Kalana304/CEM_Design_Files/SolidWorks/LED light/Number 8 screw/screw.PNG

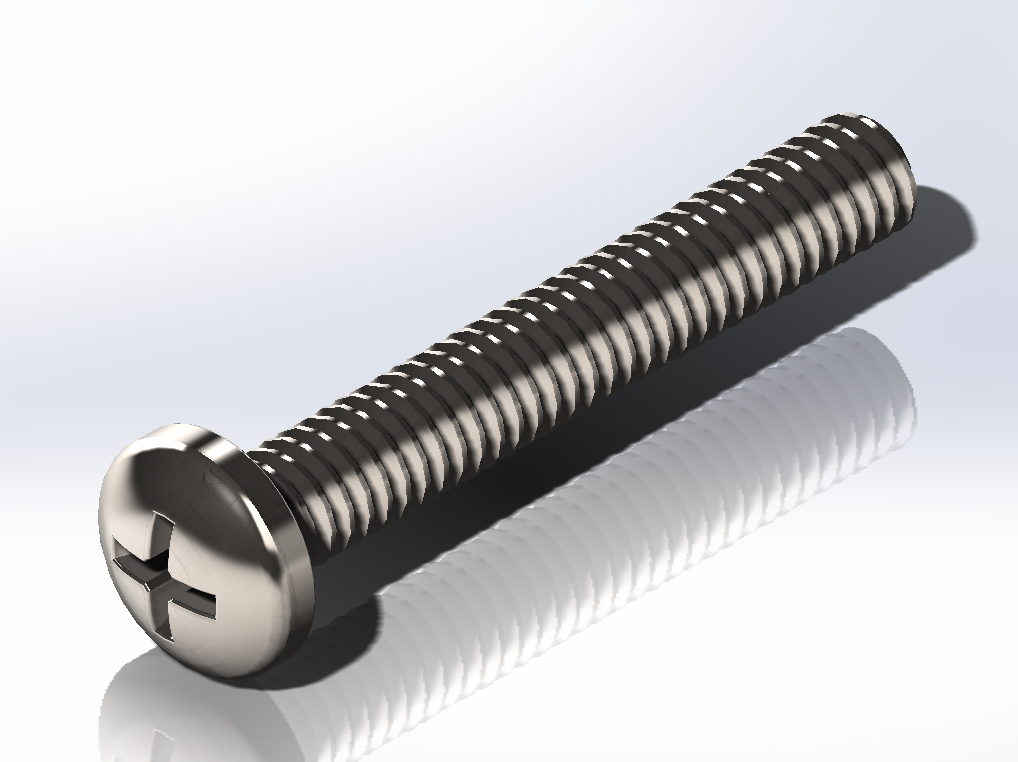
SolidWorks/LED light/Number 8 screw/screw.PNG
