Kalana304/CEM_Design_Files/SolidWorks/LED light/arduino-buzzer-1.snapshot.2/Screenshot (179).png

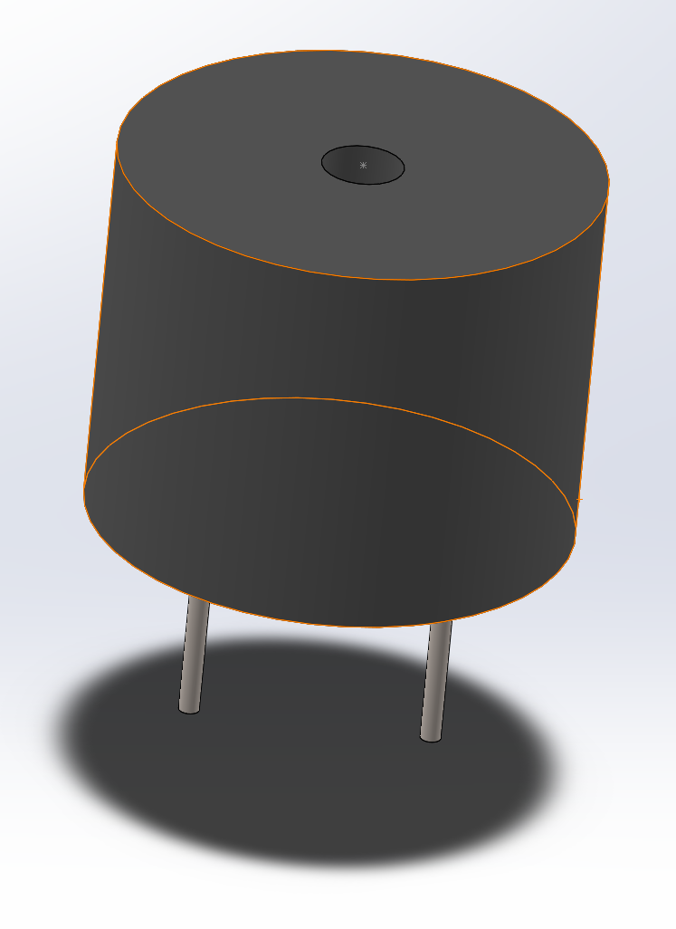
SolidWorks/LED light/arduino-buzzer-1.snapshot.2/Screenshot (179).png
