Kalana304/CEM_Design_Files/Reports/Enclosure.docx

Group 1

Controlled Environment Monitors

Manufacturing Document

# Contents

# Display Unit Manufacture

## Enclosure

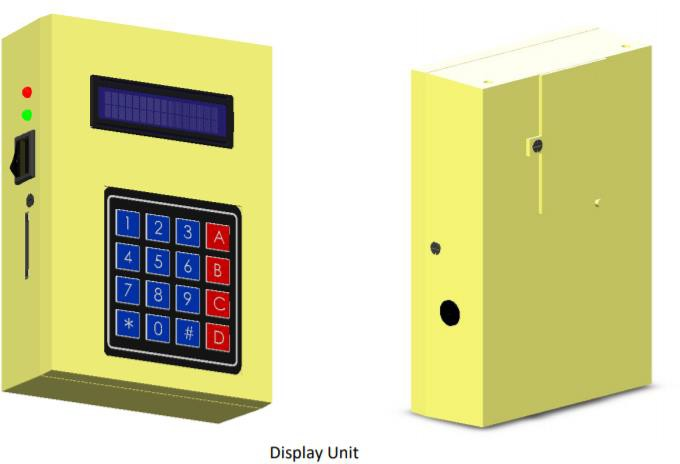
[picture p13: figure]
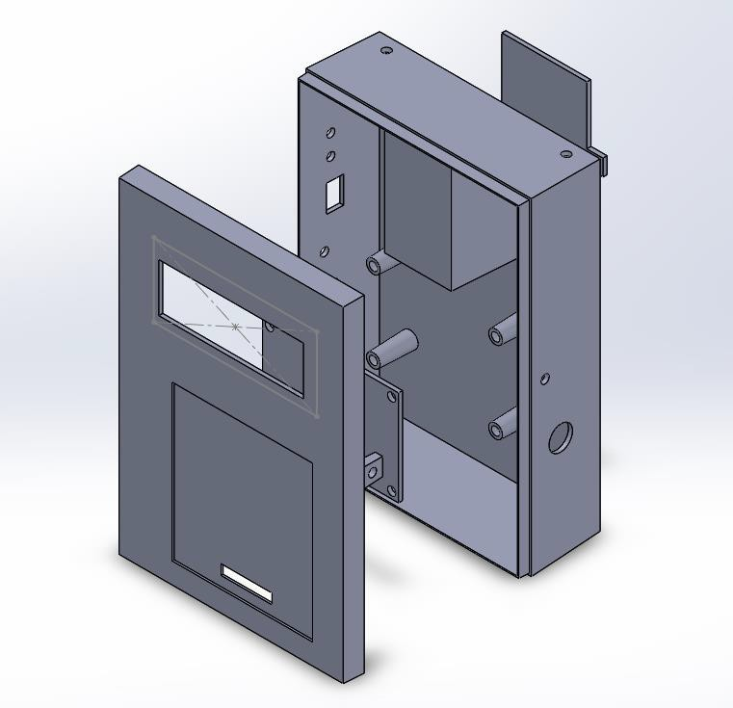
[picture p14: figure]

## Components

The display unit enclosure consists of 3 components that are manufactured by injection molding. All units are to be molded using hard plastic.

1. Top Cover
2. Bottom Cover
3. Battery Cover

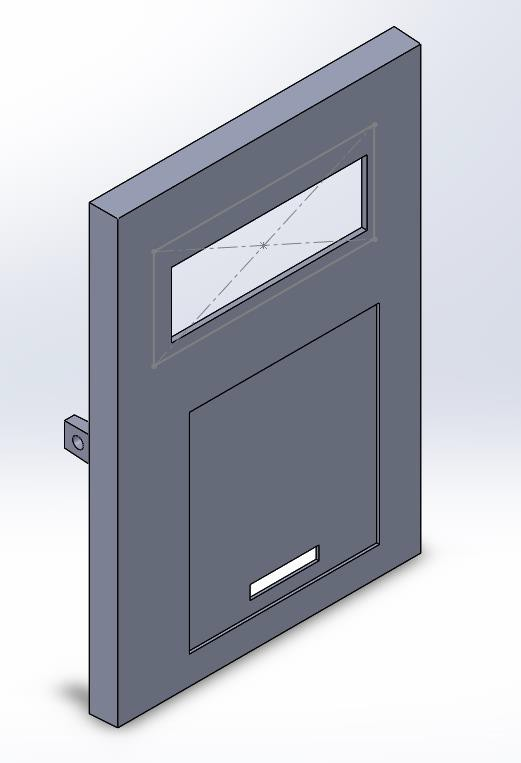
[picture p15: figure]

## Top Cover

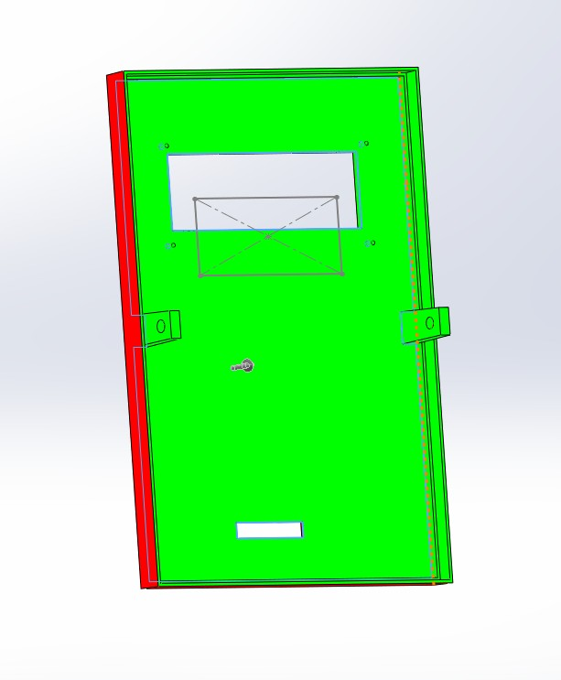
[picture p16: figure]

Draft Analysis

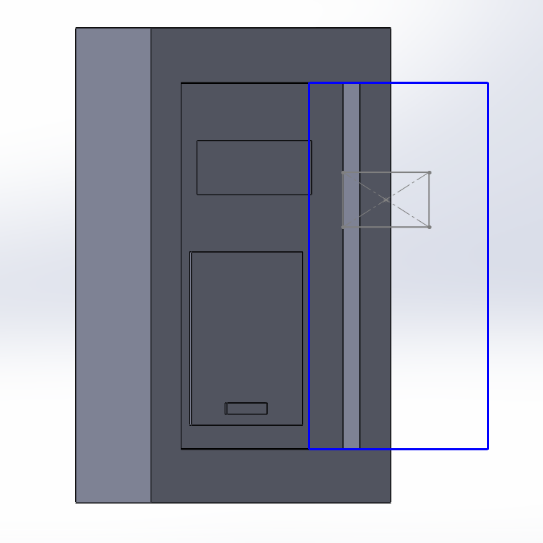
[picture p17: figure]
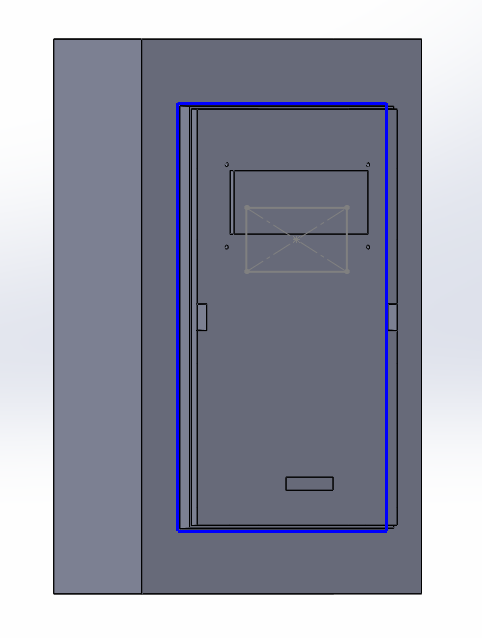
[picture p18: figure]

Mold Components

Cavity Core

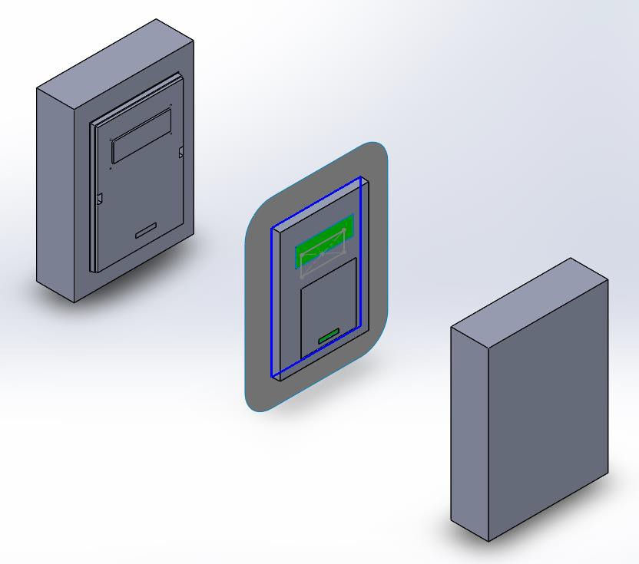
[picture p19: figure]

Exploded view of mold

## Bottom Cover

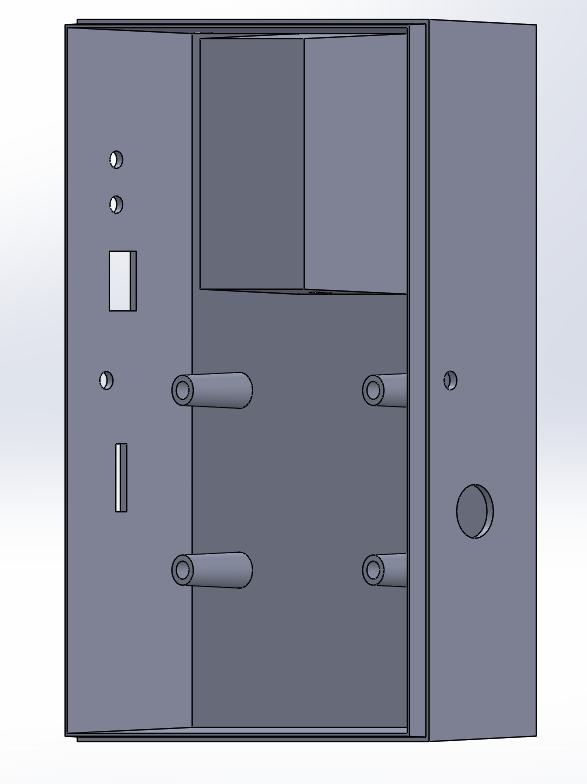
[picture p20: figure]

Draft Analysis

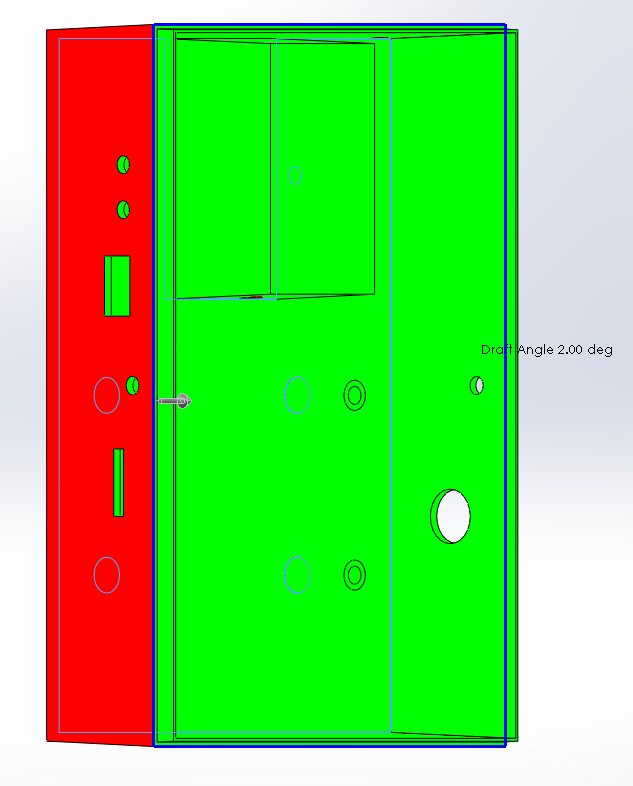
[picture p21: figure]
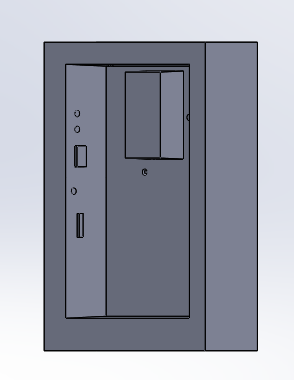
[picture p22: figure]
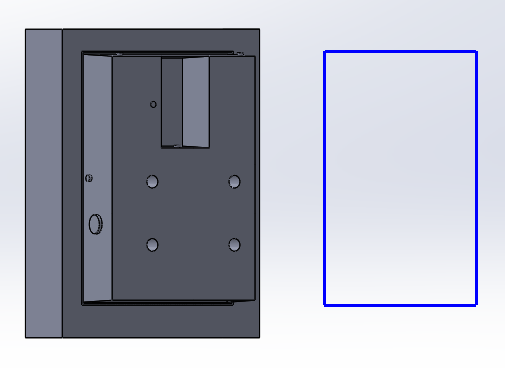
[picture p23: figure]

Mold Components

Core Cavity

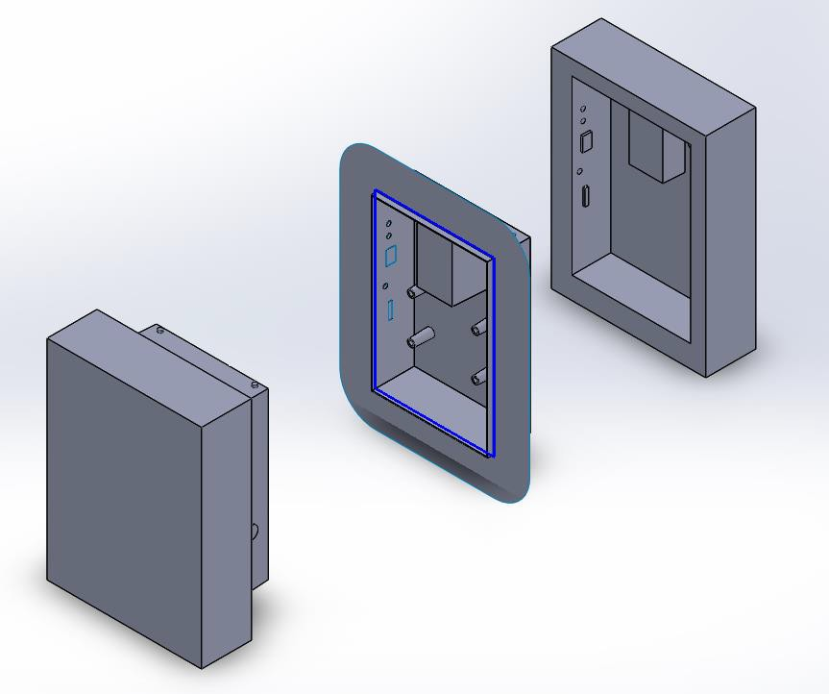
[picture p24: figure]

Exploded view of Mold

## Battery Cover

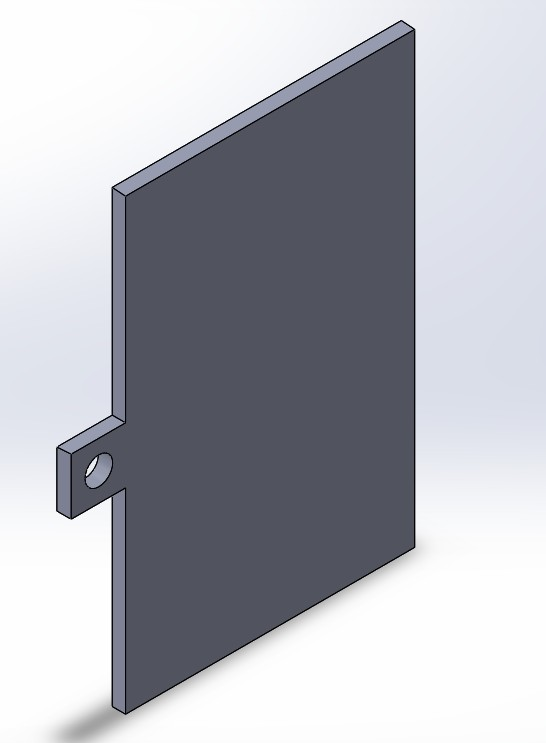
[picture p25: figure]

Draft Analysis

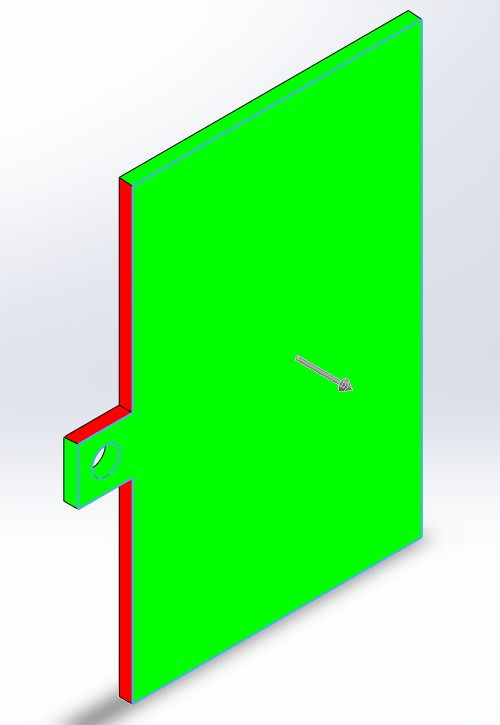
[picture p26: figure]

Mold Components

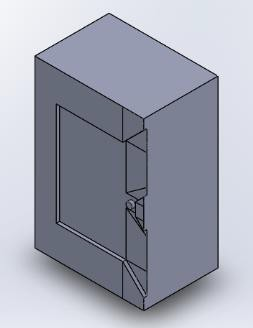
[picture p27: figure]
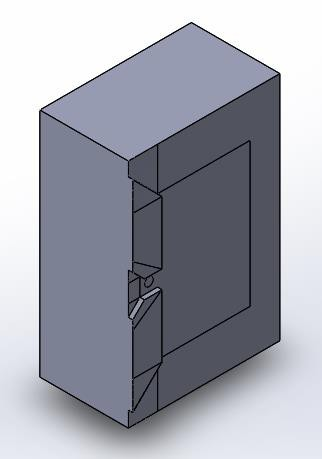
[picture p28: figure]

Core Cavity

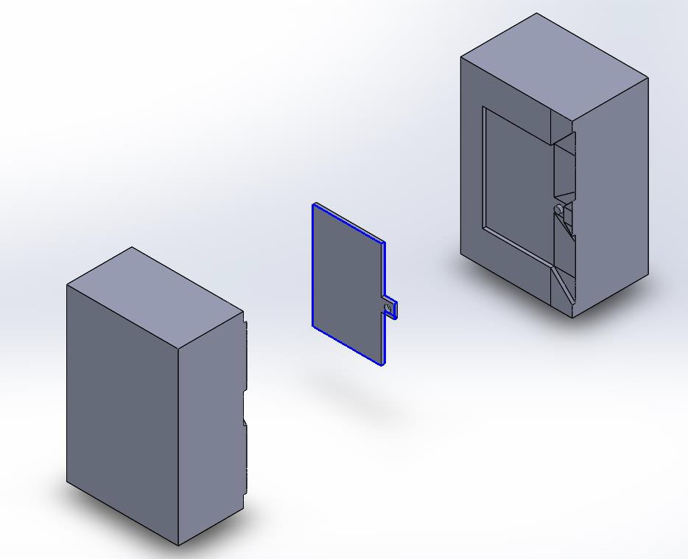
[picture p29: figure]

Exploded view of Mold

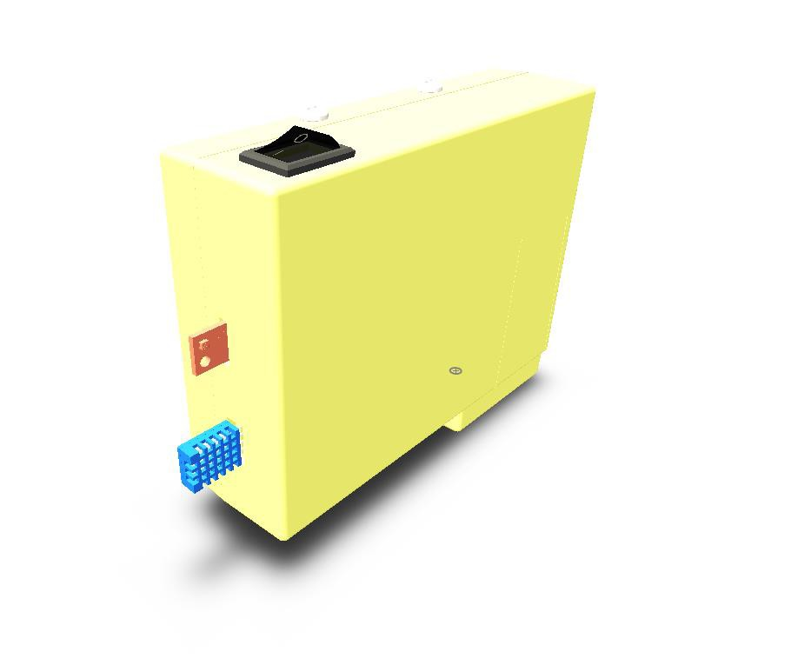
[picture p30: figure]
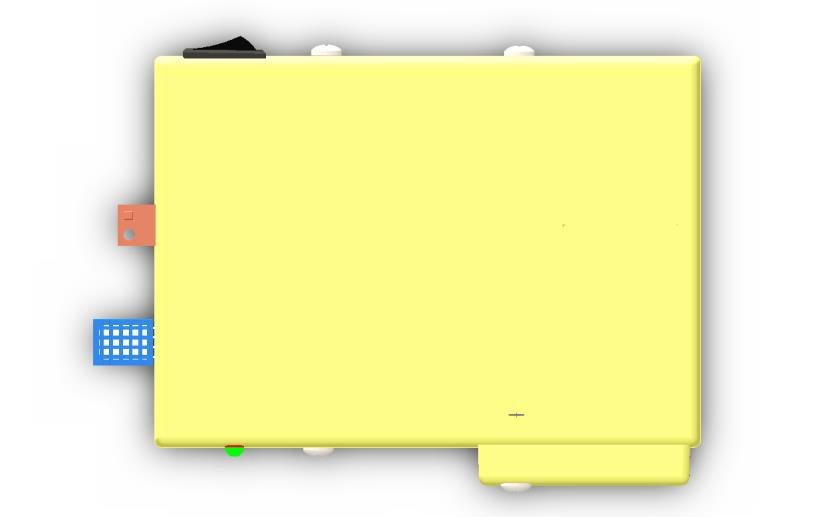
[picture p31: figure]

# Sensor Unit Manufacture

Sensor Unit

## Enclosure

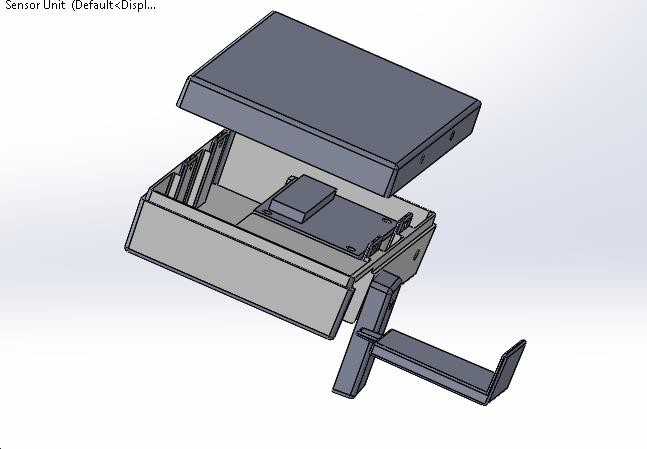
[picture p32: figure]

### Components

The Sensor Unit Enclosure consists of 4 components that are to be manufactured by injection molding. All units are to be molded using hard plastic

Components to be molded are:

  1. Top Cover
  2. Bottom Cover
  3. Battery Cover
  4. Battery Lock

### Top Cover

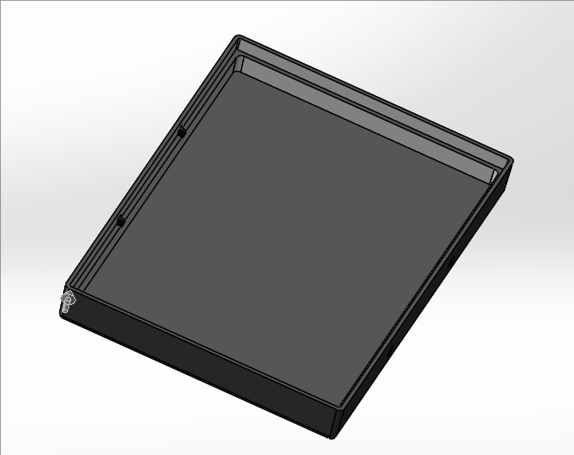
[picture p33: figure]

Draft Analysis

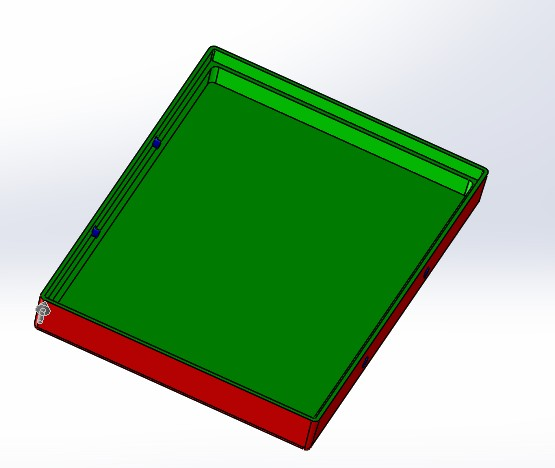
[picture p34: figure]

Mold Components

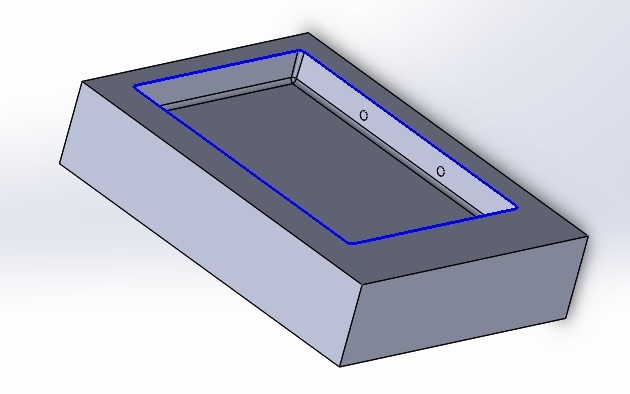
[picture p35: figure]
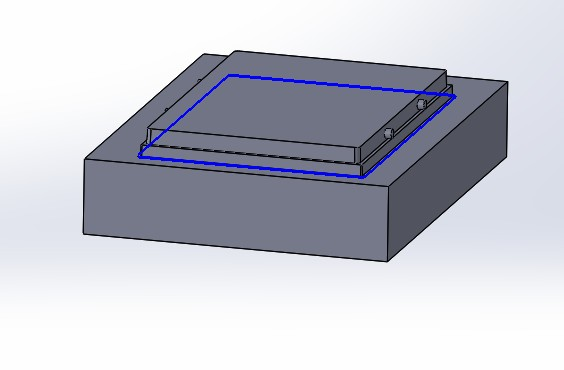
[picture p36: figure]
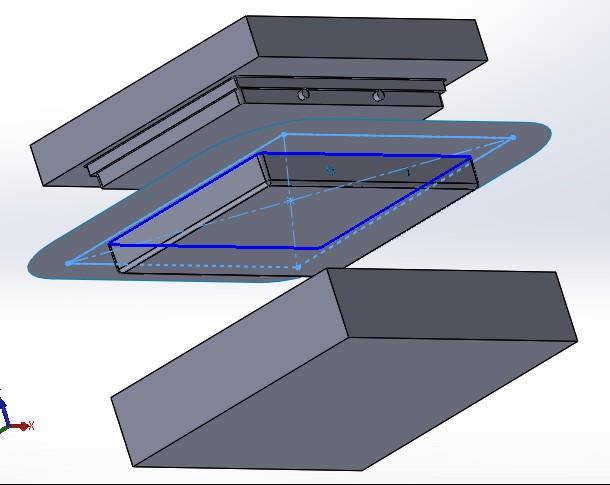
[picture p37: figure]

Cavity

Core

Exploded View of Mold

### Bottom Cover

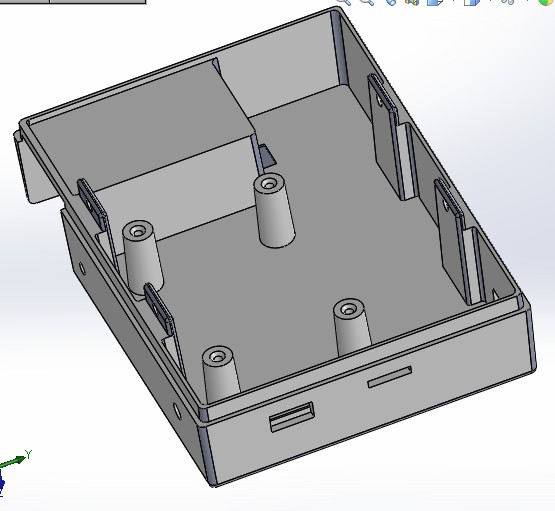
[picture p38: figure]

Draft Analysis

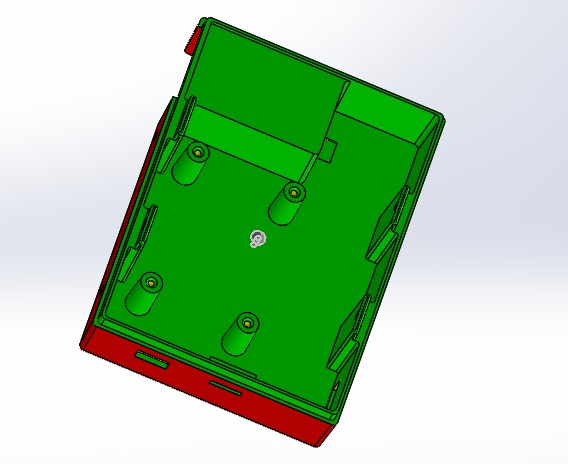
[picture p39: figure]
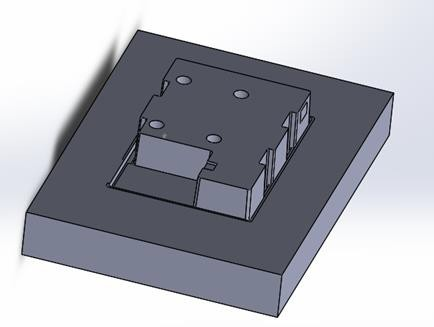
[picture p40: figure]

Mold Components

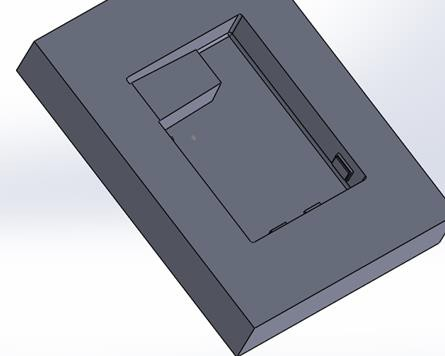
[picture p41: figure]
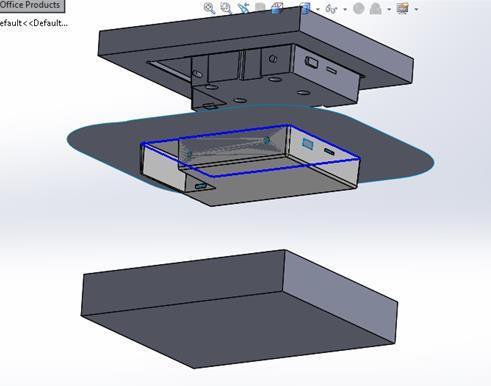
[picture p42: figure]

Cavity

Core

Exploded View of Mold

### Battery Cover

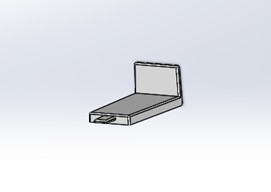
[picture p43: figure]

Draft Analysis

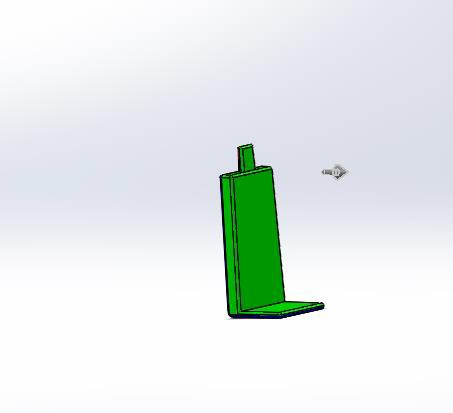
[picture p44: figure]

Mold Components

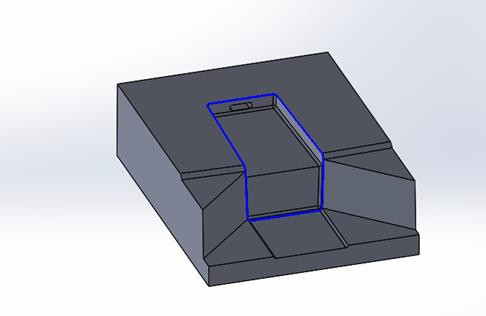
[picture p45: figure]
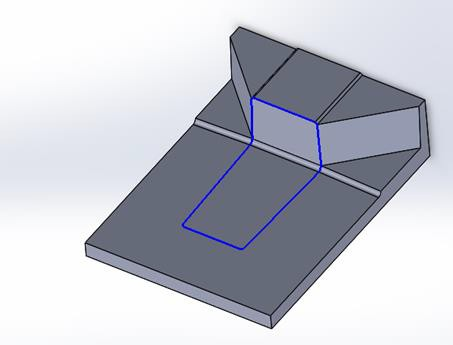
[picture p46: figure]
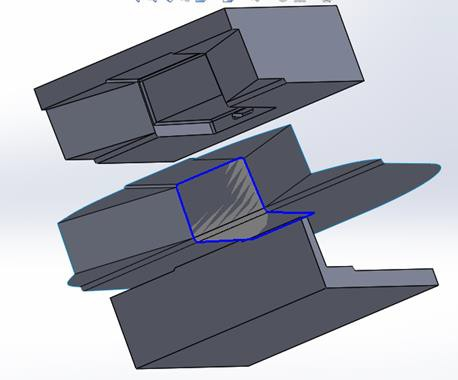
[picture p47: figure]

Cavity

Core

Exploded View of Mold

### Battery Lock

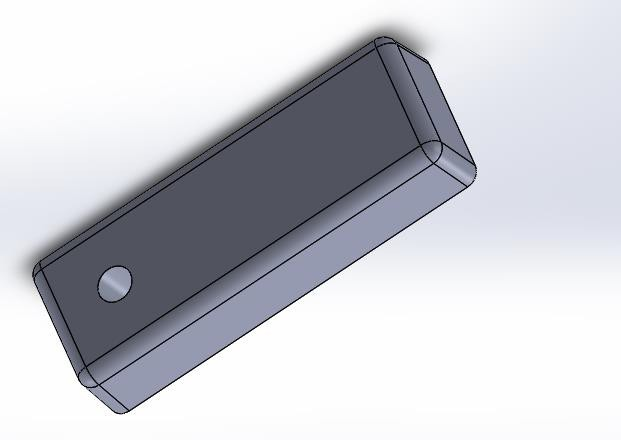
[picture p48: figure]

Draft Analysis

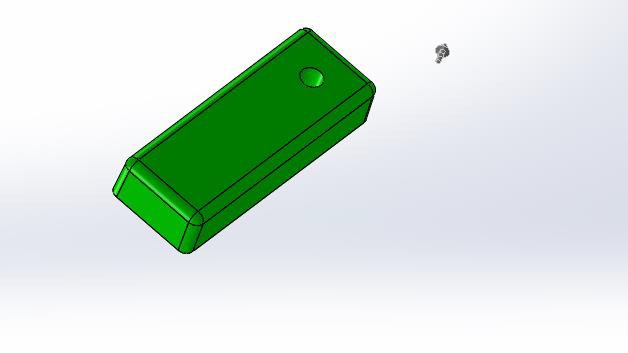
[picture p49: figure]
