Kalana304/CEM_Design_Files/SolidWorks/SolidWorks Design Report.pdf

# CEM SOLIDWORKS DESIGNS

### GROUP 1

## MAY 24, 2019

160005C | Abeywardena K.G.
160050H | Bahavan T.T.N.
160145E | Ekanayake R.P.
160190K | Gunawardena M.B.M.
160276F | Kariyawasam U.G.S.D.
160285G | Karunasena G.K.S.R.
160480B | Perera W.A.H.D.
160616B | Sumanthiran S. K.
160637N | Tribuwan T.W.H.
160648A | Uyanwatte A.M.B

## 1. Sensor Module

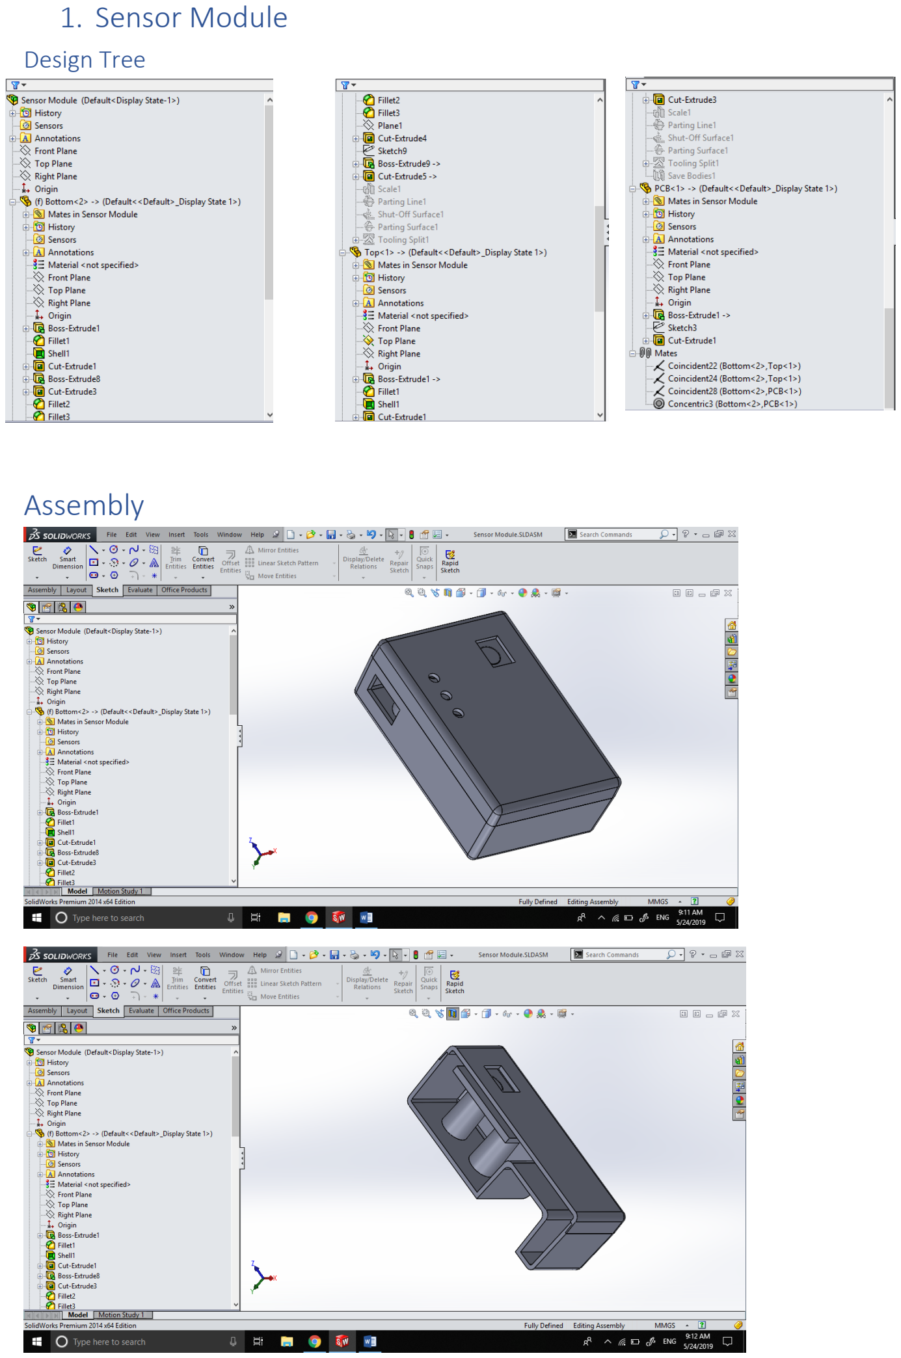
[picture p161: page 2]

Design Tree

## Assembly

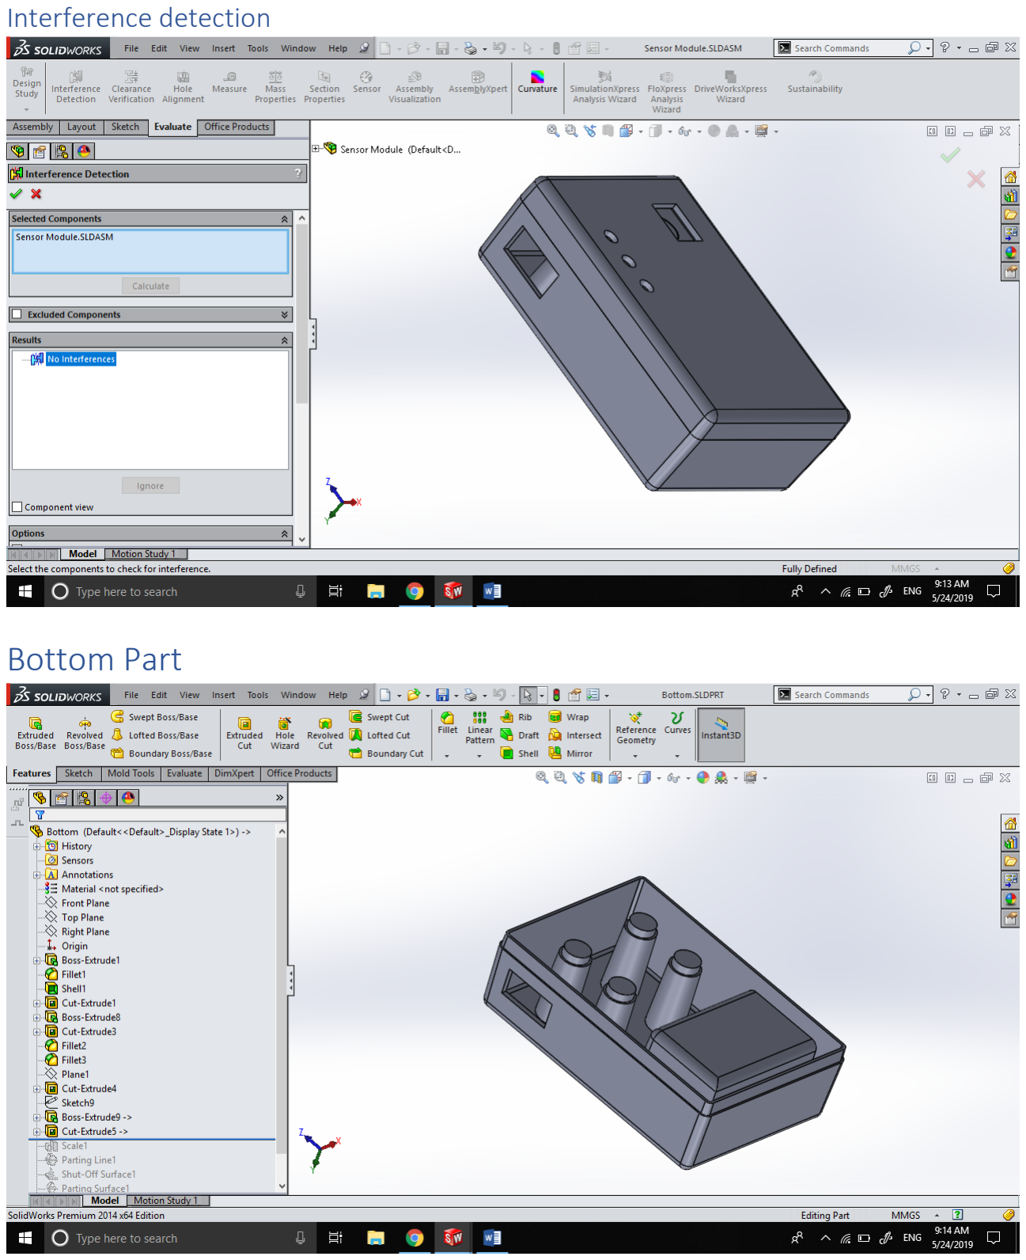
[picture p162: page 3]

Interference detection

## Bottom Part

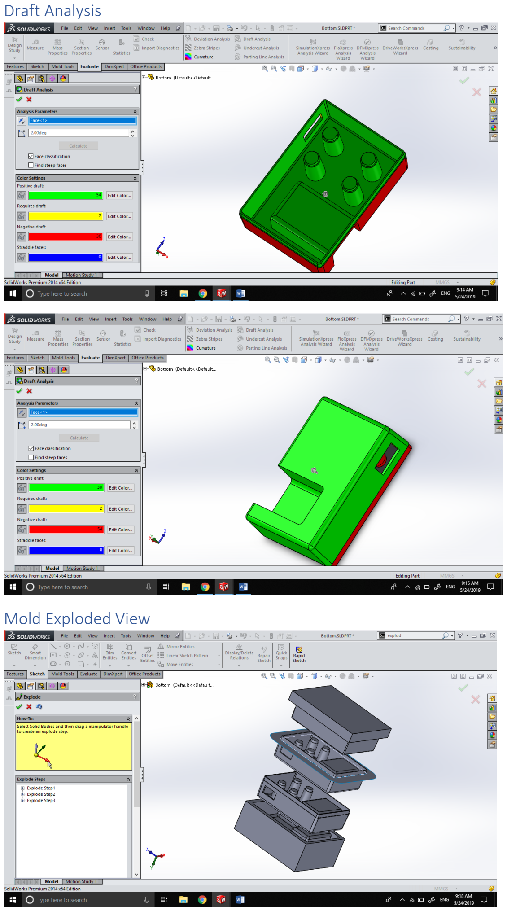
[picture p163: page 4]

Draft Analysis

Mold Exploded View

## Top Part

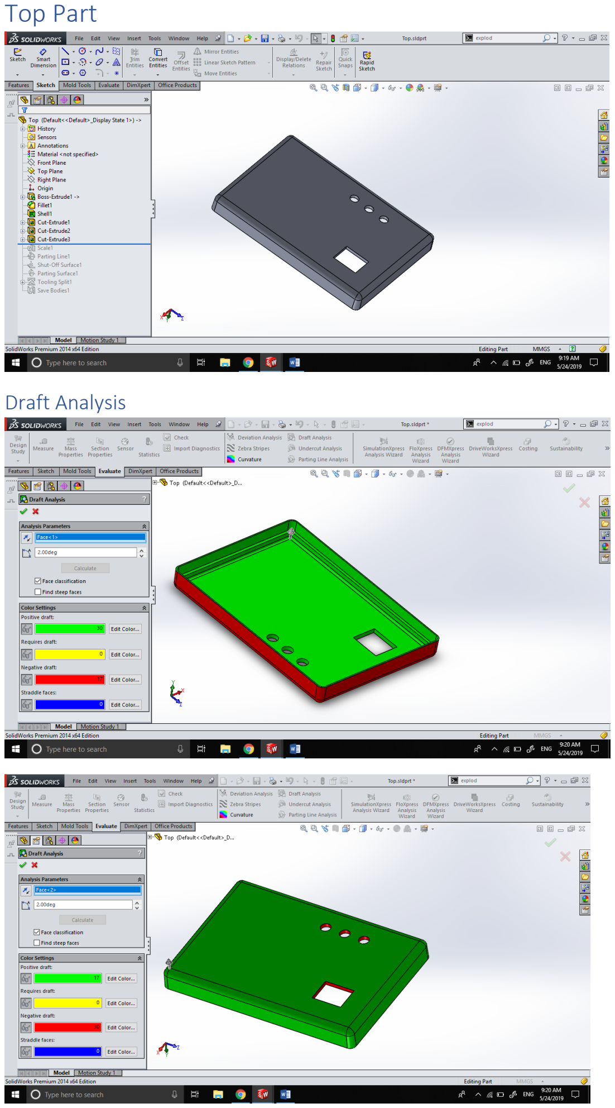
[picture p164: page 5]

Draft Analysis

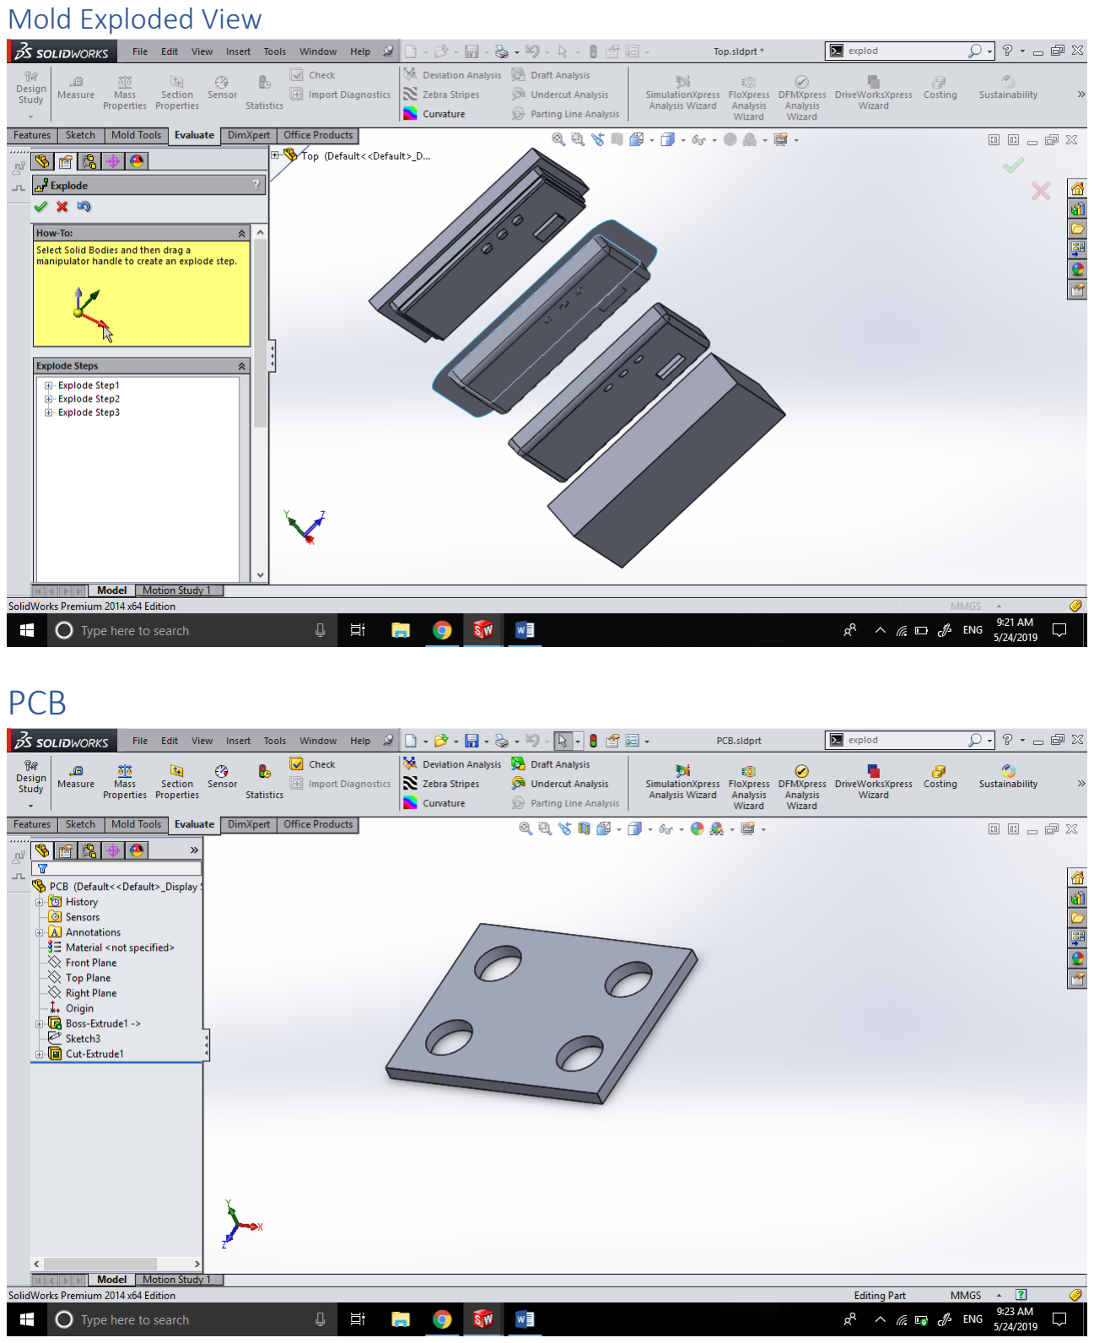
[picture p165: page 6]

Mold Exploded View

## PCB

## Display Unit Enclosure Design

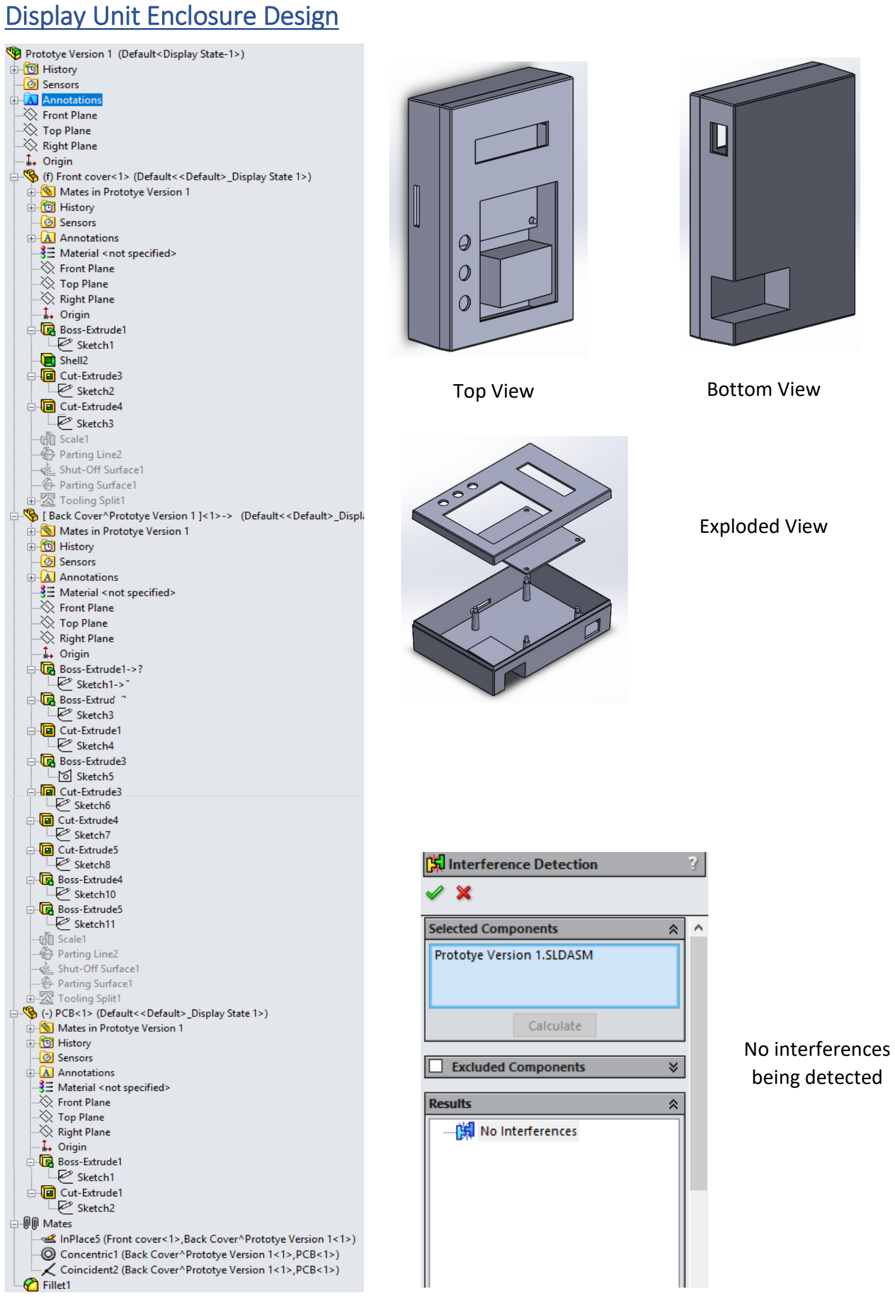
[picture p166: page 7]

Top View | Bottom View

Exploded View

No interferences
being detected

## Back Cover

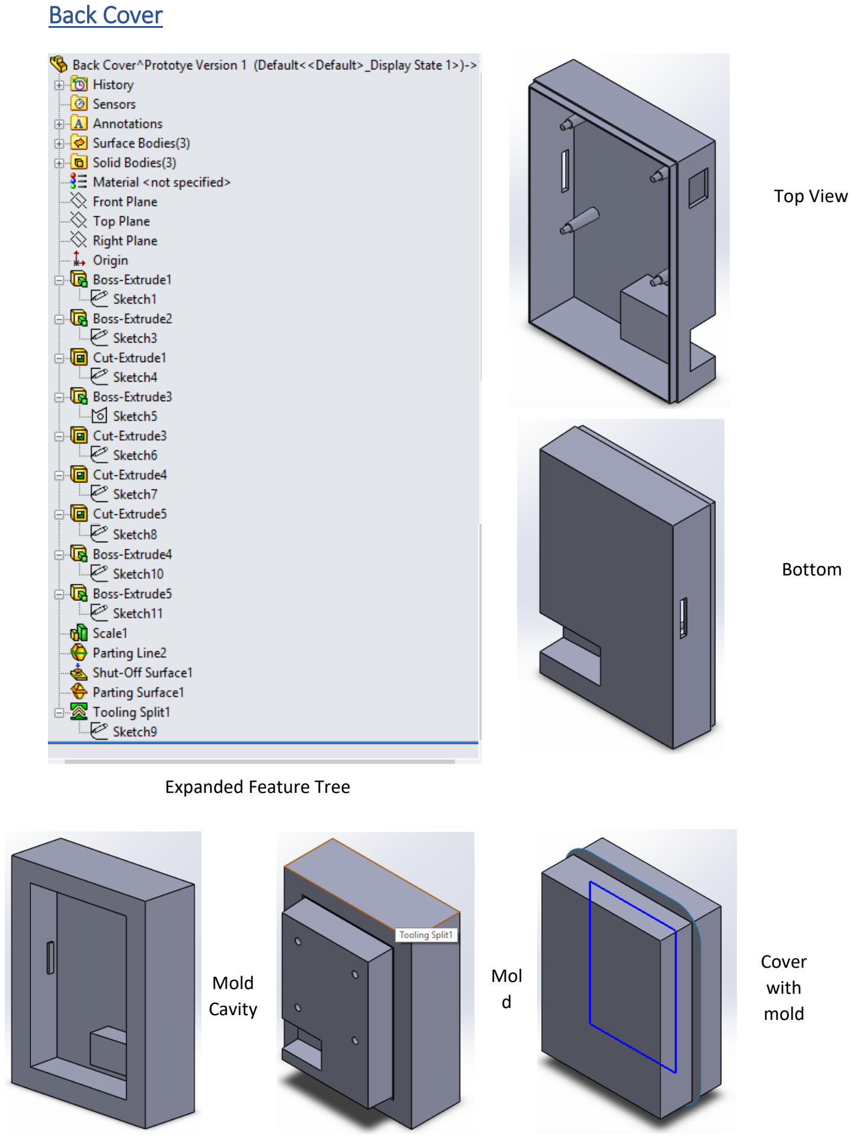
[picture p167: page 8]

Top View

Bottom

Expanded Feature Tree

Mold
Cavity

Mol
d

Cover
with
mold

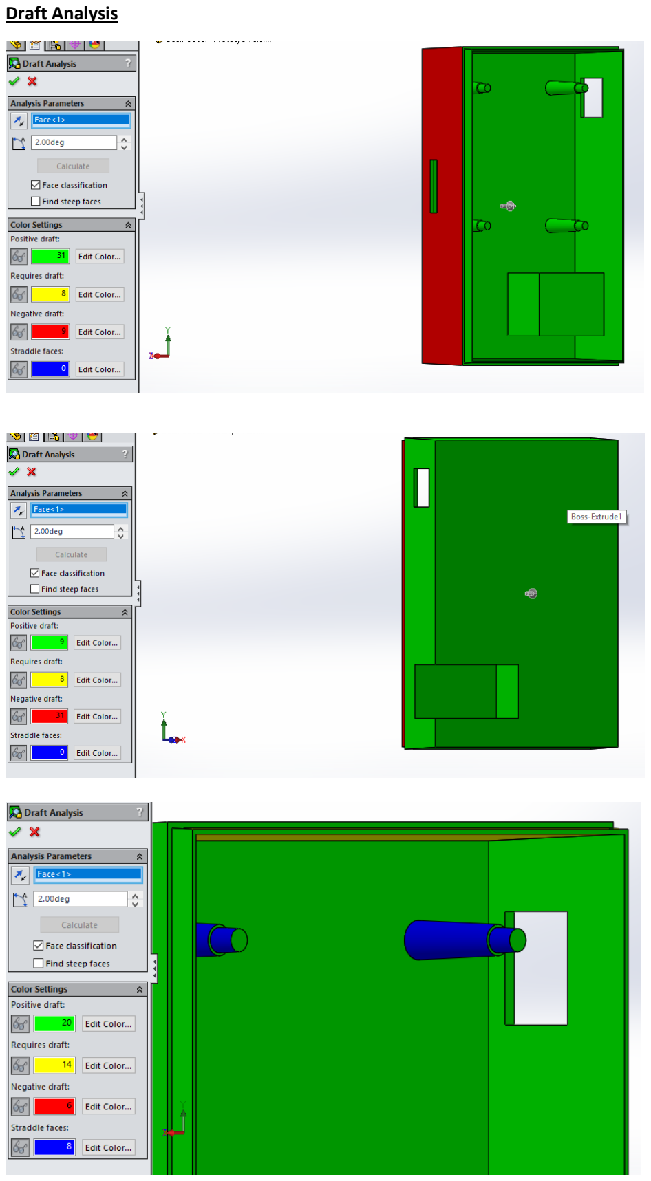
[picture p168: page 9]

Draft Analysis

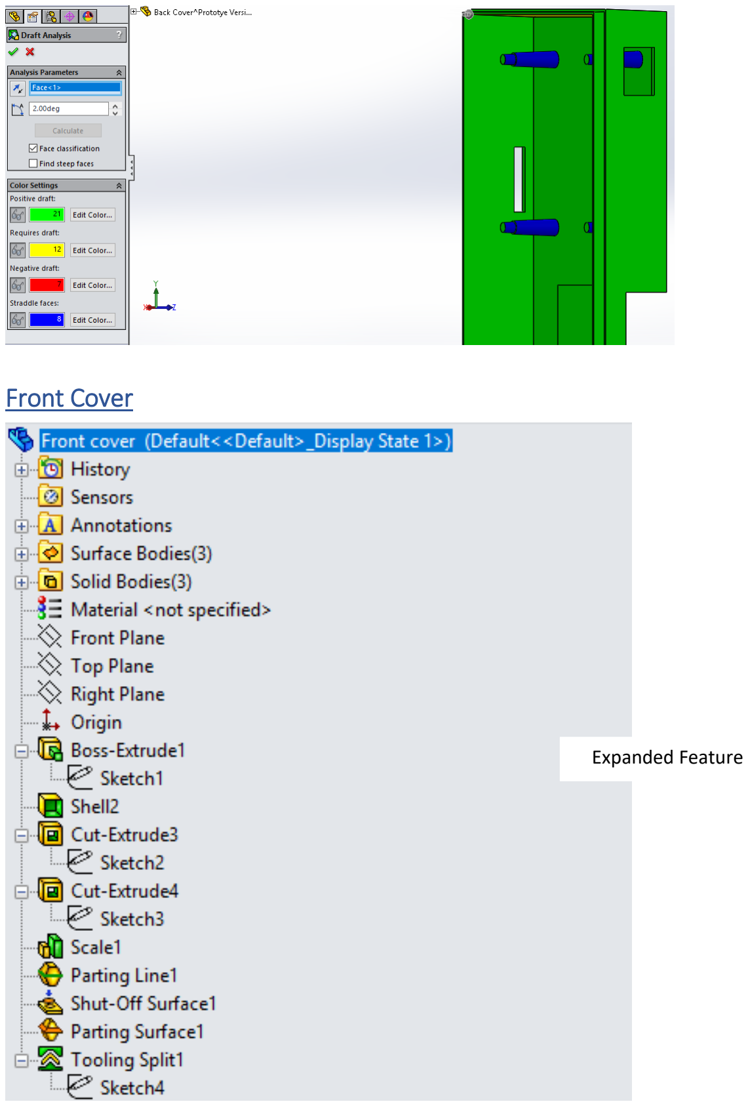
[picture p169: page 10]

## Front Cover

Expanded Feature

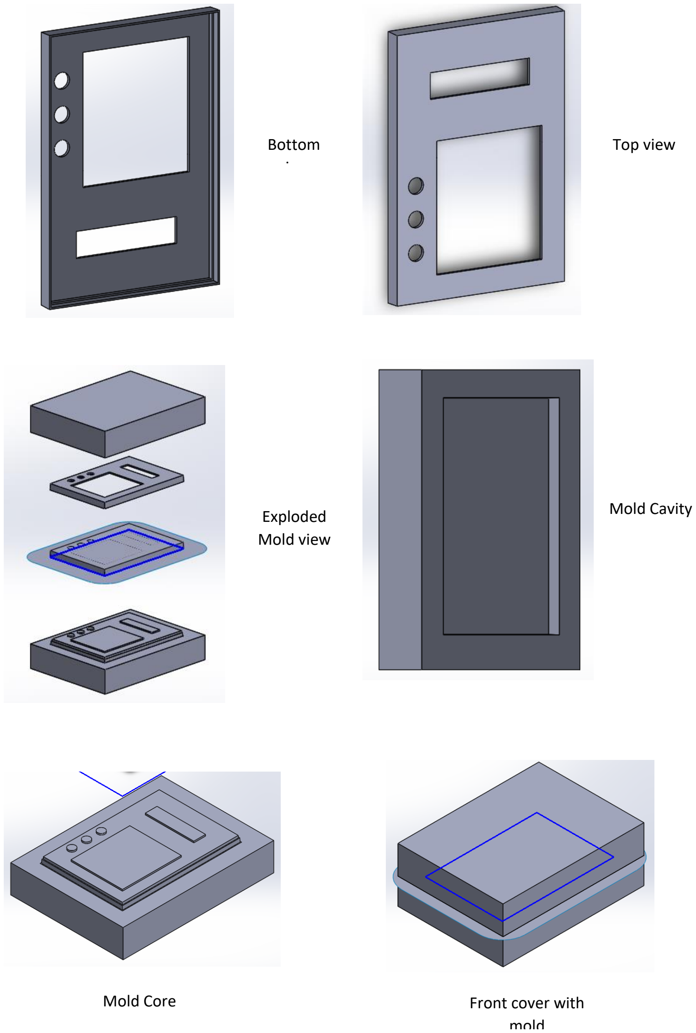
[picture p170: page 11]

Bottom

Top view

Exploded
Mold view

Mold Cavity

Mold Core | Front cover with mold

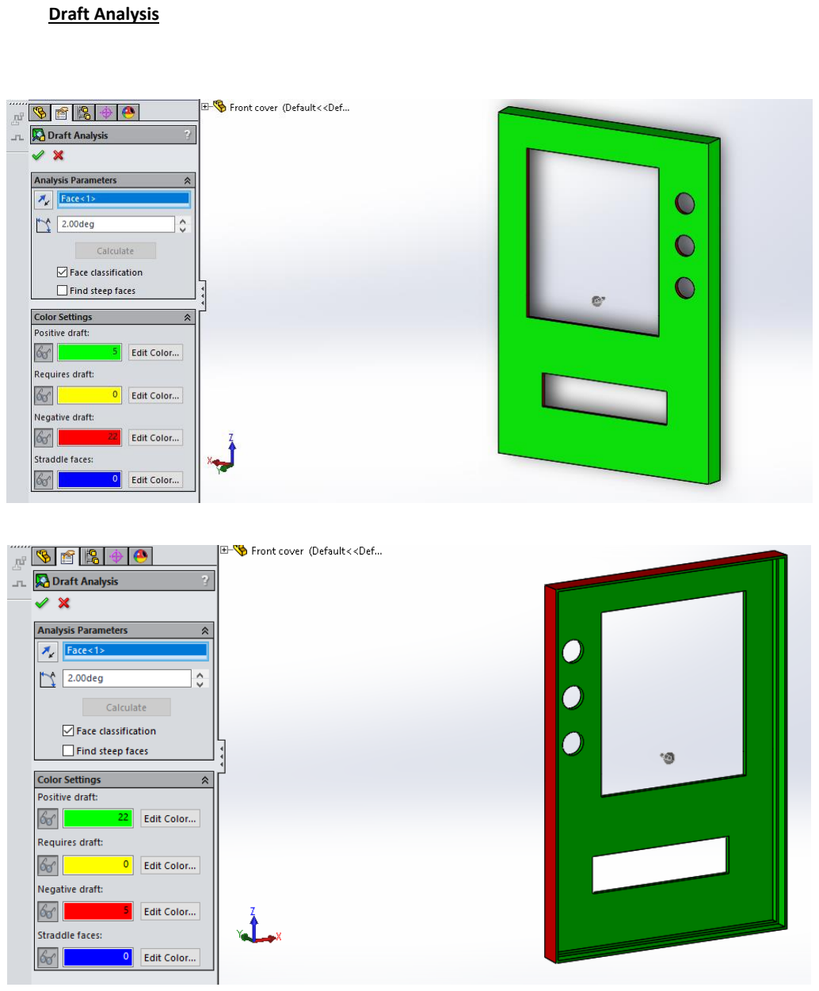
[picture p171: page 12]

Draft Analysis

## PCB Design

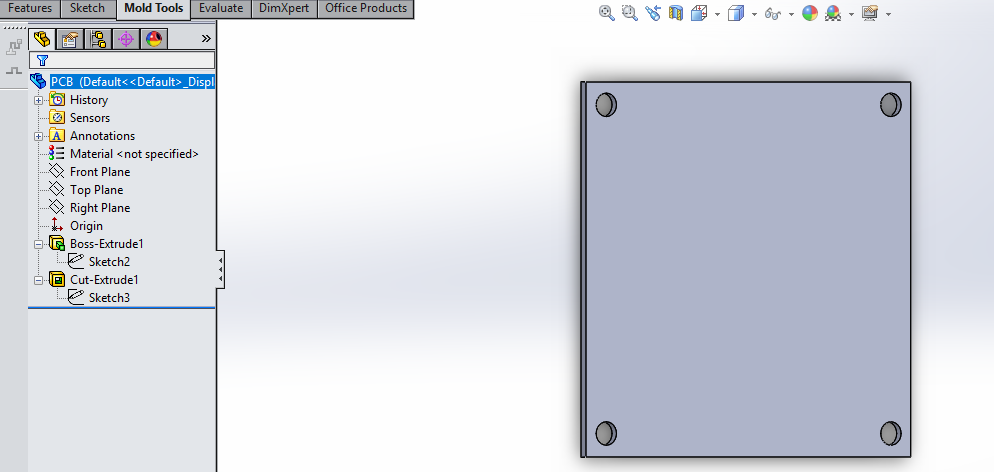
[picture p172: figure]
