Kalana304/CEM_Design_Files/Reports/Document List.xlsx

Document Components Needed
 | Component | Have | Containing Document Name | Added to Design Document | Production Document | Promotional Document | User Manual | Service Manual | Disposal Instructions
 | Interpreters Feedback | Yes | Interpreters.docx | No
 | Product Goals | Yes | ProductGoals_Desgin_specs_Conceptual Designs_Evaluations.docx | No
 | Design Specs | Yes | Specs(1).pdf | No
 | Conceptual Designs | Yes | ProductGoals_Desgin_specs_Conceptual Designs_Evaluations.docx | No
 | Evaluation | Yes | ProductGoals_Desgin_specs_Conceptual Designs_Evaluations.docx | No
 | Preliminary Design and Evaluation | No |  | No
 | Detailed Design |  |  | No
 | Solidworks Mold Screenshots | No |  | No
 | Product Screenshots | Yes | Service Manual.dox | No
 | Assembly Instruction | Yes | Service Manual.dox | No
 | Circuit Diagrams | Yes | cct diagram * .pdf | No
 | Layout Images | Yes | Circuit Information | No
 | Codes | No |  | No
 | Features | No |  | No
 | Test Details | No |  | No
 | Usage Information | No |  | No
 | Service Information | Yes | Service Manual.dox | No |  |  |  | Complete
 | Disposal Information | No |  | No
 | Datasheets
