Kalana304/CEM_Design_Files/Reports/Circuit Information/Etch_length_sensor_unit.pdf

Design Name D:/JAKS jaya/Propagater/orcad lib/sensorboardfinal.brd
Date Thu Jun 06 21:34:40 2019
Net Name | Layer Name | Total Length (millimeters) | Line Width (millimeters) | Length at Width (millimeters)
N01461 | TOP | 7.7887 | 0.5000 | 7.7887
N01481 | TOP | 13.0578 | 0.5000 | 13.0578
N01545 | TOP | 10.6569 | 0.5000 | 10.6569
N01565 | TOP | 8.7383 | 0.5000 | 8.7383
N01577 | TOP | 7.9861 | 0.5000 | 7.9861
N01607 | BOTTOM | 12.5173 | 0.8000 | 12.5173
N03368 | BOTTOM | 14.3891 | 0.8000 | 14.3891
N03420 | TOP | 19.4144 | 0.7000 | 8.4853
N03420 | BOTTOM | 19.4144 | 0.8000 | 10.9291
N05812 | BOTTOM | 117.8184 | 0.5000 | 27.5953
N05812 | BOTTOM | 117.8184 | 0.8000 | 40.8636
N05812 | BOTTOM | 117.8184 | 1.3000 | 49.3595
N05864 | TOP | 201.7947 | 0.5000 | 37.9584
N05864 | BOTTOM | 201.7947 | 0.7000 | 62.8143
N05864 | BOTTOM | 201.7947 | 0.8000 | 23.3978
N05864 | BOTTOM | 201.7947 | 1.0000 | 42.1947
N05864 | BOTTOM | 201.7947 | 1.3000 | 24.4841
N05864 | BOTTOM | 201.7947 | 1.5000 | 10.9453
N06064 | BOTTOM | 6.3024 | 0.5000 | 6.3024
N06072 | BOTTOM | 6.3024 | 0.5000 | 6.3024
N06627 | TOP | 199.7712 | 0.7000 | 37.4890
N06627 | BOTTOM | 199.7712 | 0.7000 | 136.3284
N06627 | BOTTOM | 199.7712 | 0.8000 | 8.7931
N06627 | BOTTOM | 199.7712 | 1.0000 | 17.1607
N06779 | BOTTOM | 17.3665 | 0.8000 | 17.3665
N07080 | BOTTOM | 13.3806 | 0.7000 | 13.3806
N07092 | BOTTOM | 13.3806 | 0.7000 | 13.3806
N07402 | BOTTOM | 14.4783 | 0.7000 | 14.4783
N07414 | BOTTOM | 24.6688 | 0.7000 | 24.6688
N09349 | BOTTOM | 6.2528 | 0.8000 | 6.2528
Etch Length by Layer and Width Report | Page 1 of 1
file:///C:/Users/HP/AppData/Local/Temp/#Taaaacc00888.tmp.html | 06-Jun-19
