Kalana304/CEM_Design_Files/Datasheets/Product Views/BatteryLockOutline.png

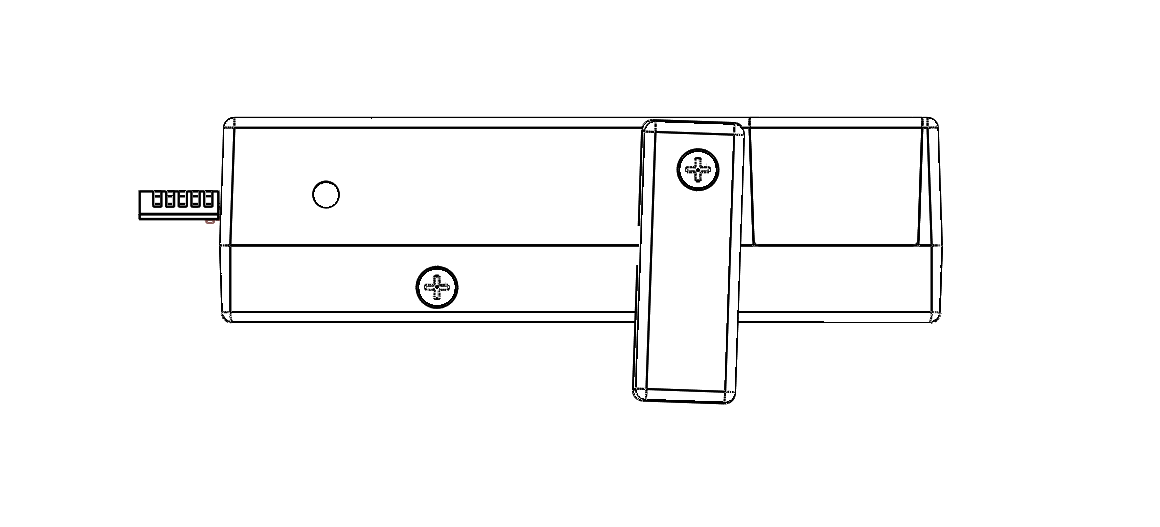
Datasheets/Product Views/BatteryLockOutline.png
