Kalana304/CEM_Design_Files/Datasheets/Product Views/DBatteryLockOutline.png

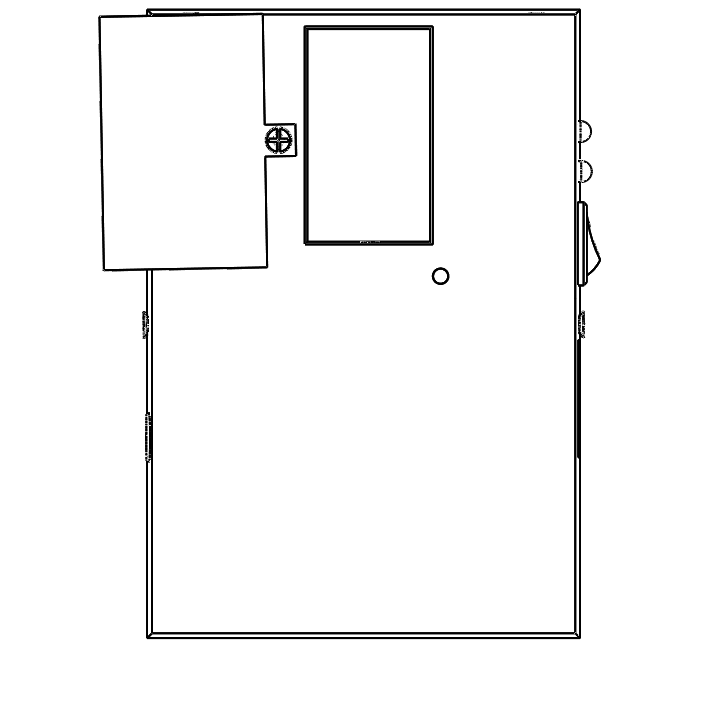
Datasheets/Product Views/DBatteryLockOutline.png
