Kalana304/CEM_Design_Files/Datasheets/Product Views/DisplayExploded.png

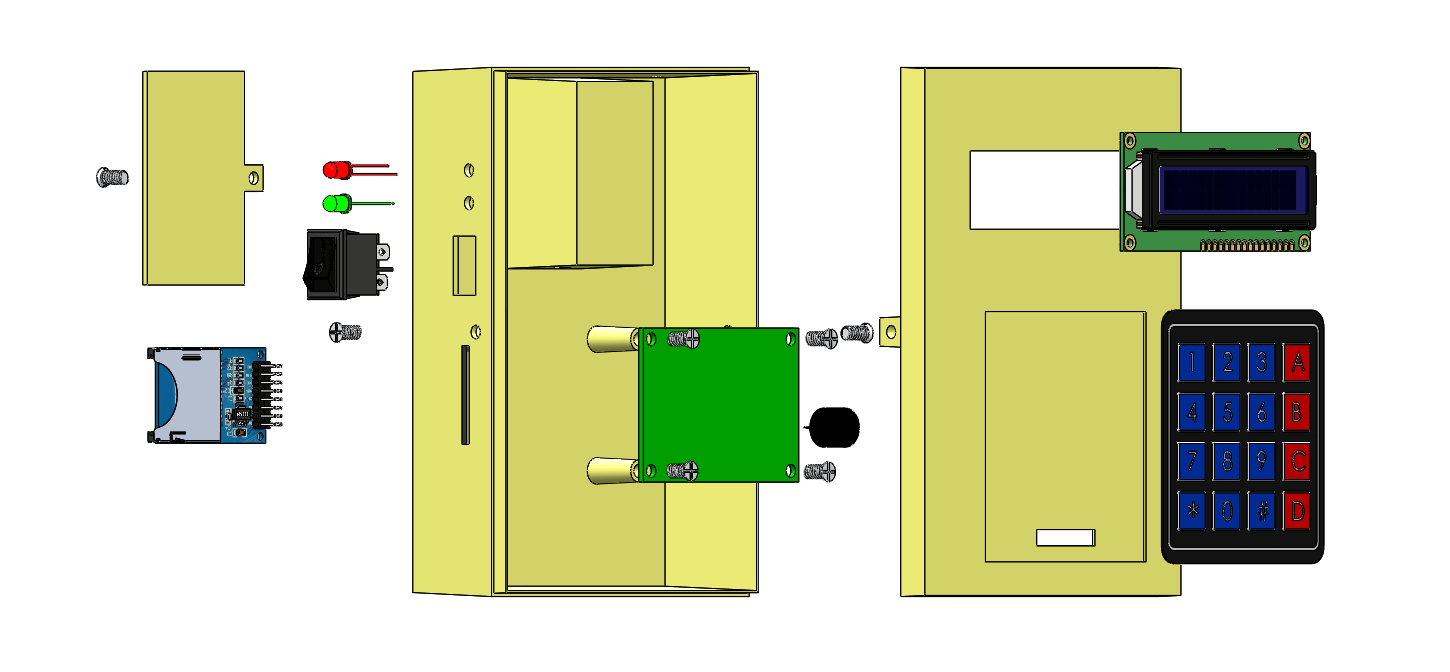
Datasheets/Product Views/DisplayExploded.png
