Kalana304/CEM_Design_Files/Datasheets/Product Views/DisplayExplodedAnnotated.png

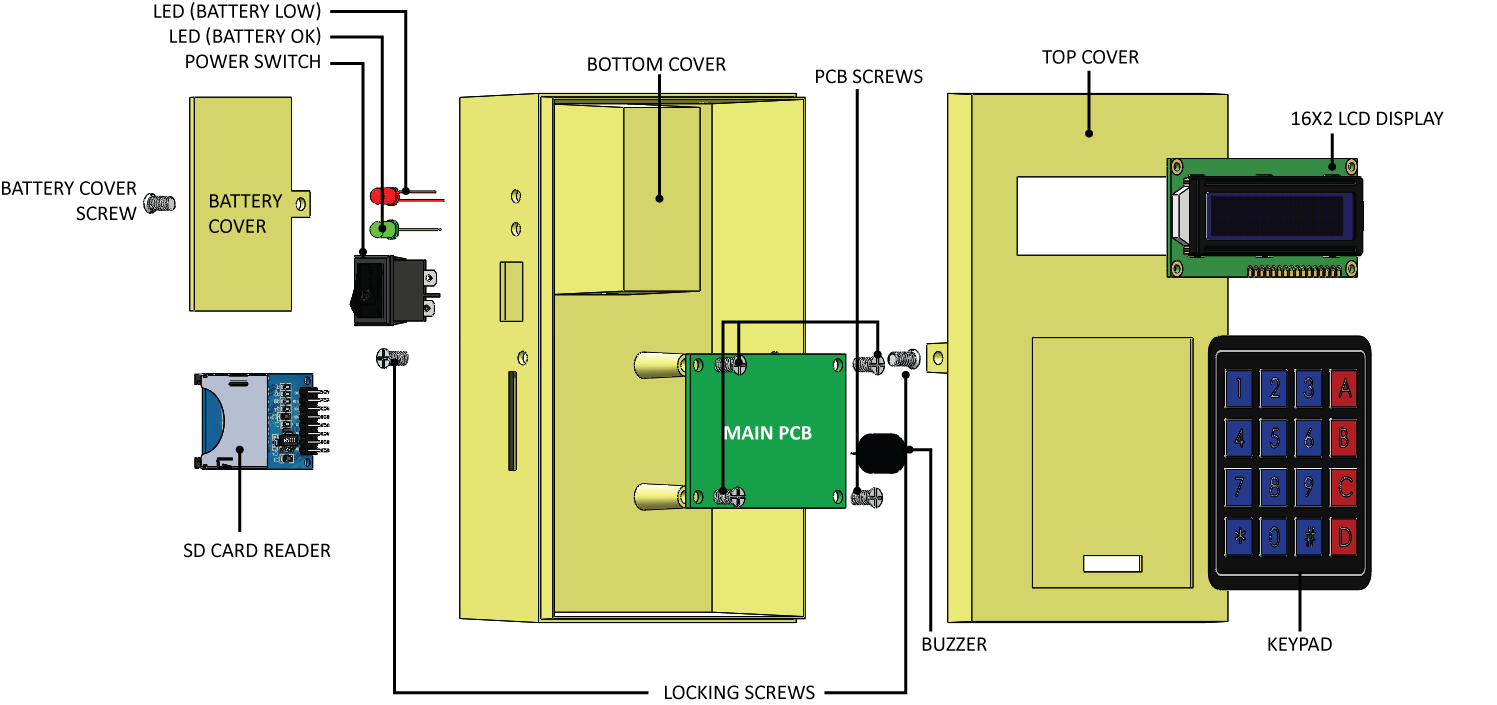
Datasheets/Product Views/DisplayExplodedAnnotated.png
