Kalana304/CEM_Design_Files/Datasheets/Product Views/DisplayInsideOutline.png

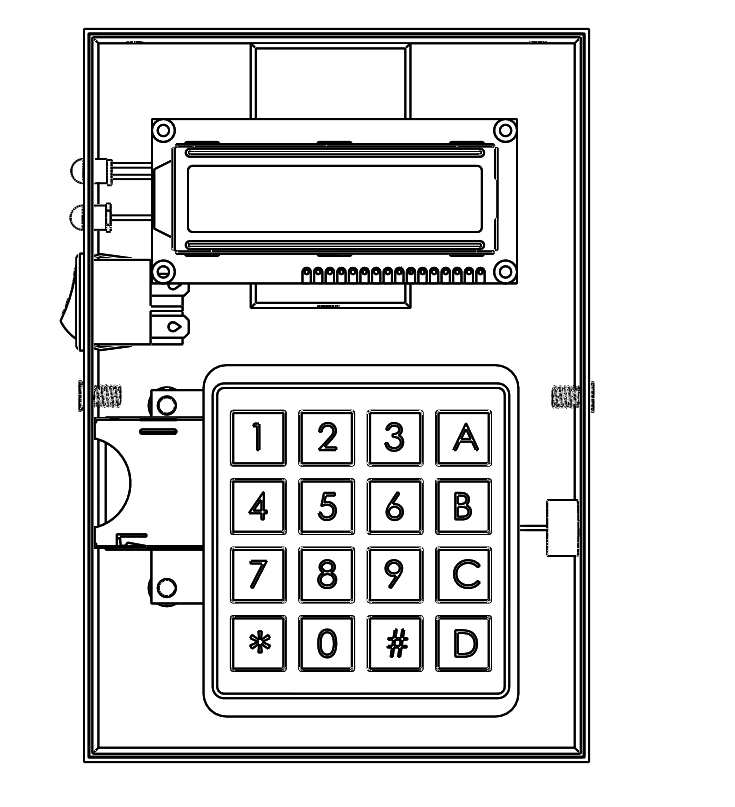
Datasheets/Product Views/DisplayInsideOutline.png
