Kalana304/CEM_Design_Files/Datasheets/Product Views/DisplayLeftOutline.png

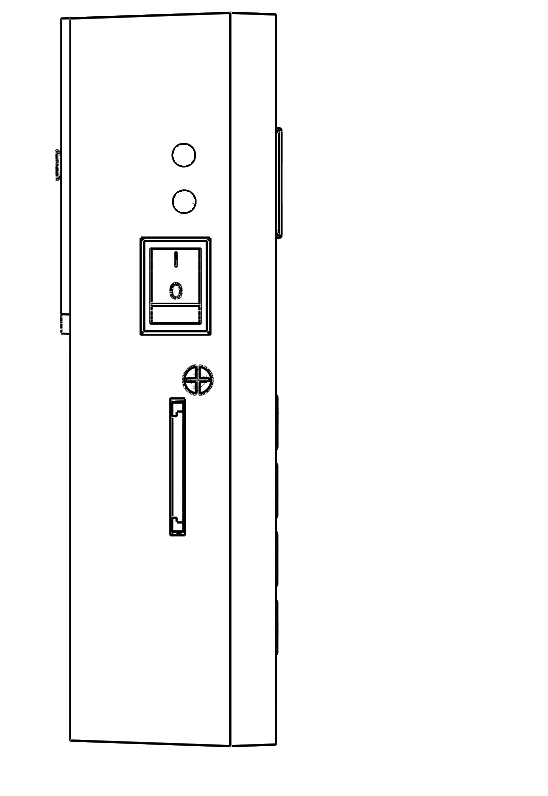
Datasheets/Product Views/DisplayLeftOutline.png
