Kalana304/CEM_Design_Files/Datasheets/Product Views/DisplayRightOutline.png

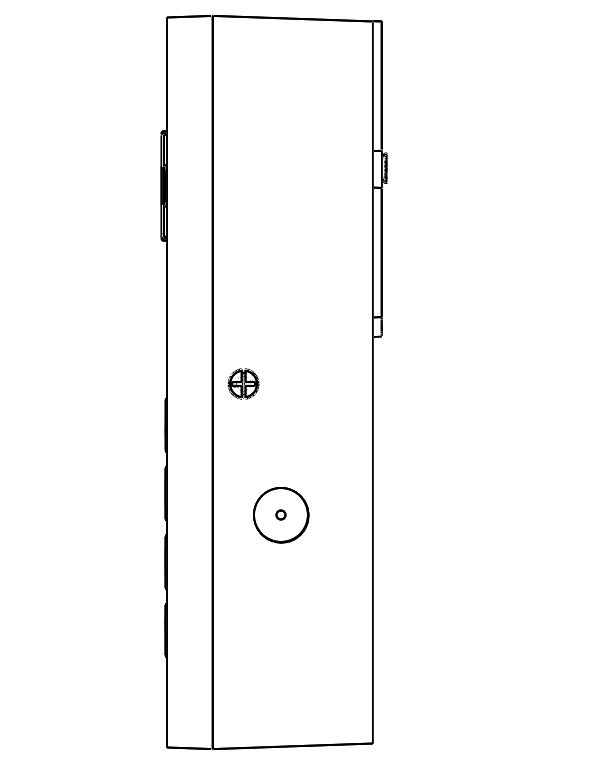
Datasheets/Product Views/DisplayRightOutline.png
