Kalana304/CEM_Design_Files/Datasheets/Product Views/DisplayTopOutline.png

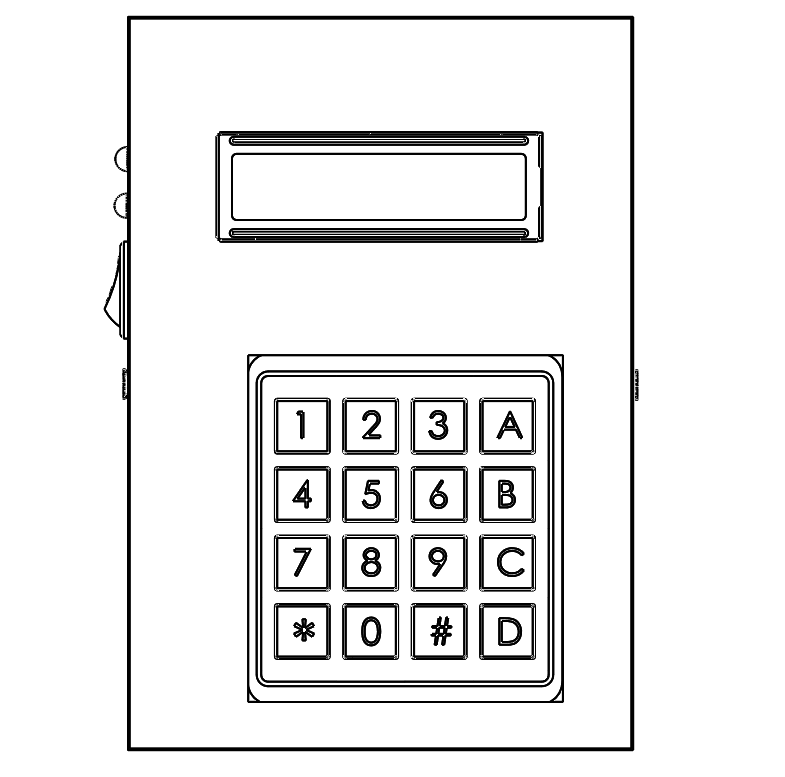
Datasheets/Product Views/DisplayTopOutline.png
