Kalana304/CEM_Design_Files/Datasheets/Product Views/DisplayUnitBack.png

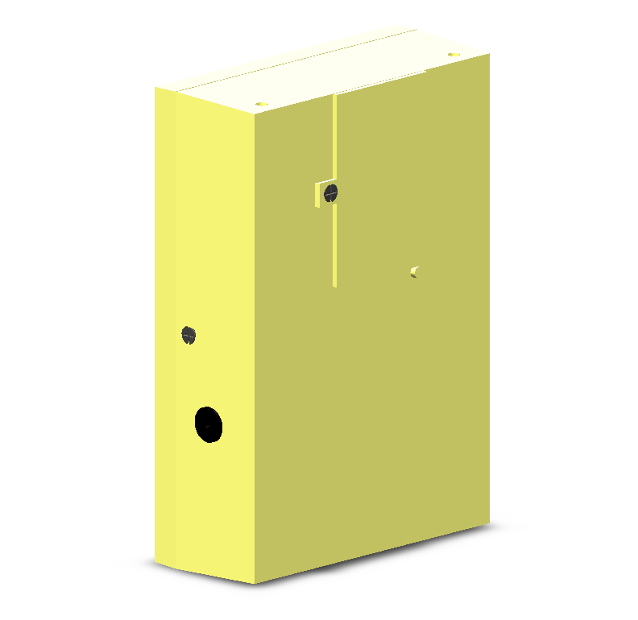
Datasheets/Product Views/DisplayUnitBack.png
