Kalana304/CEM_Design_Files/Datasheets/Product Views/SensorBottomOutline.png

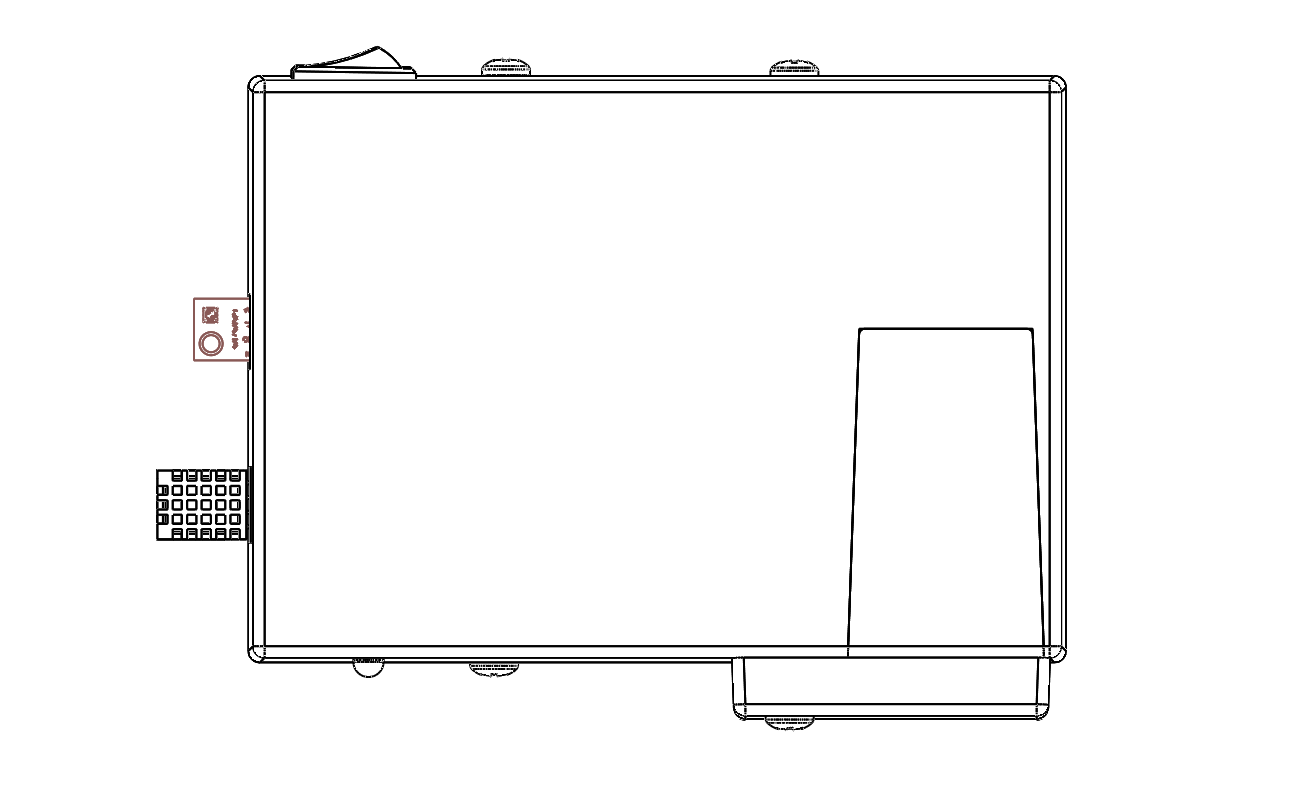
Datasheets/Product Views/SensorBottomOutline.png
