Kalana304/CEM_Design_Files/Datasheets/Product Views/SensorExploded View.png

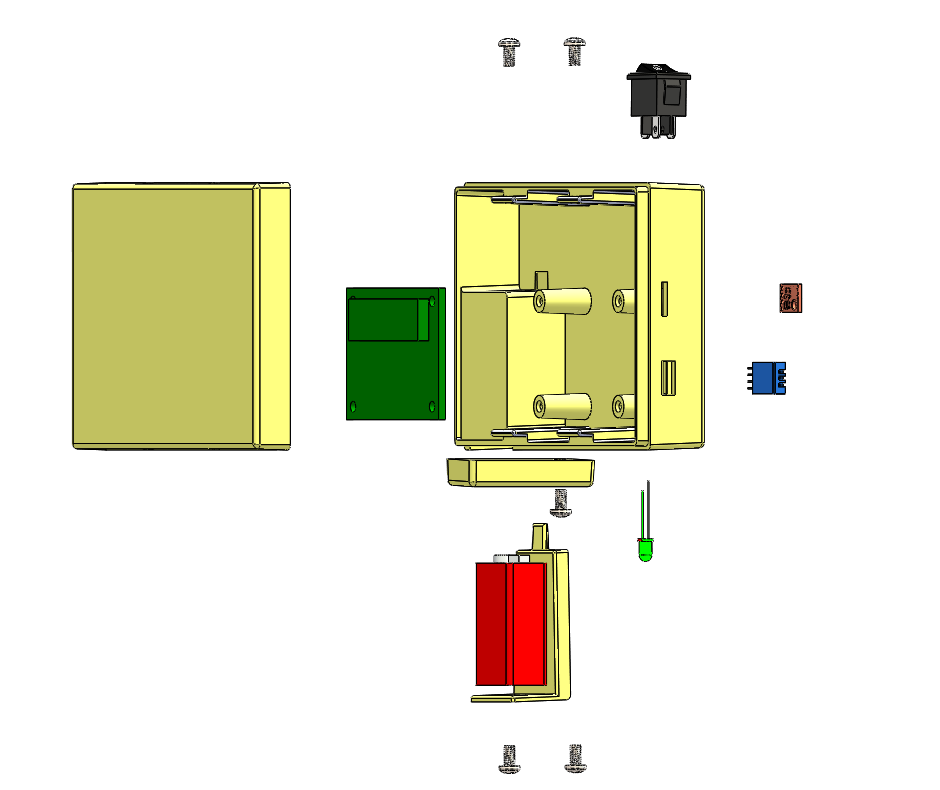
Datasheets/Product Views/SensorExploded View.png
