Kalana304/CEM_Design_Files/Datasheets/Product Views/SensorInsideOutline.png

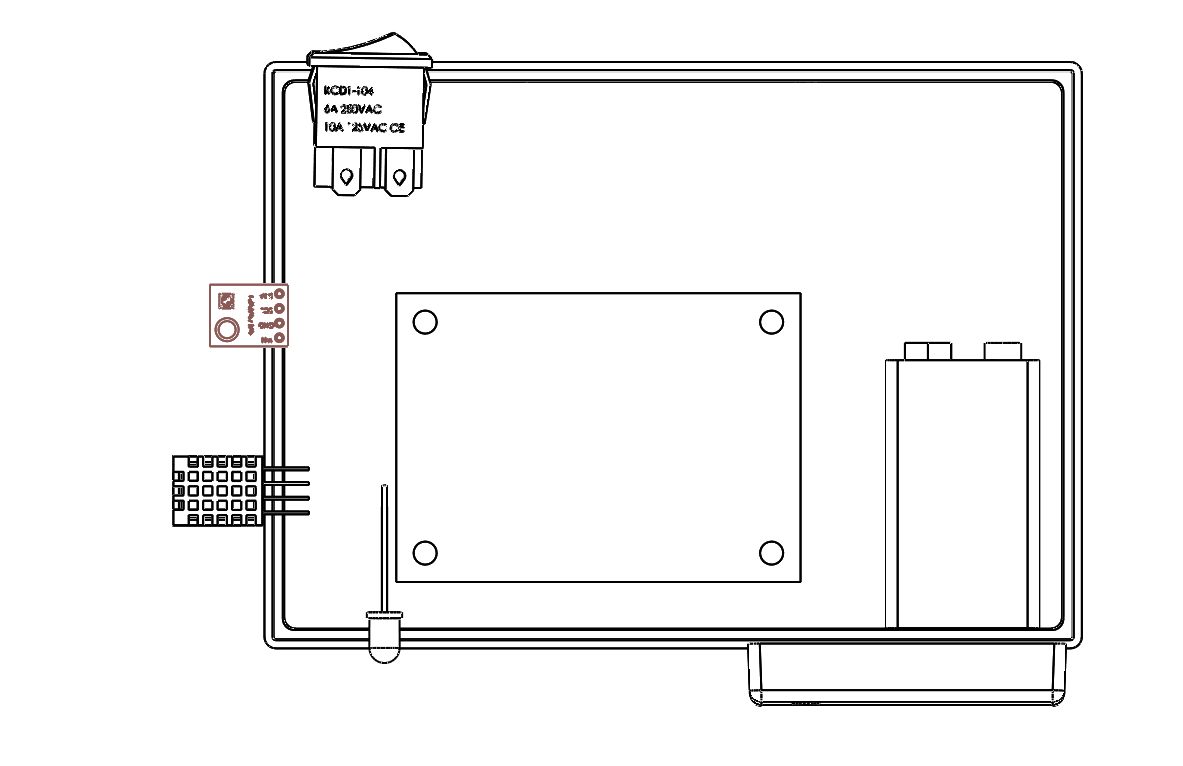
Datasheets/Product Views/SensorInsideOutline.png
