Kalana304/CEM_Design_Files/Datasheets/Product Views/SensorLeftOutline.png

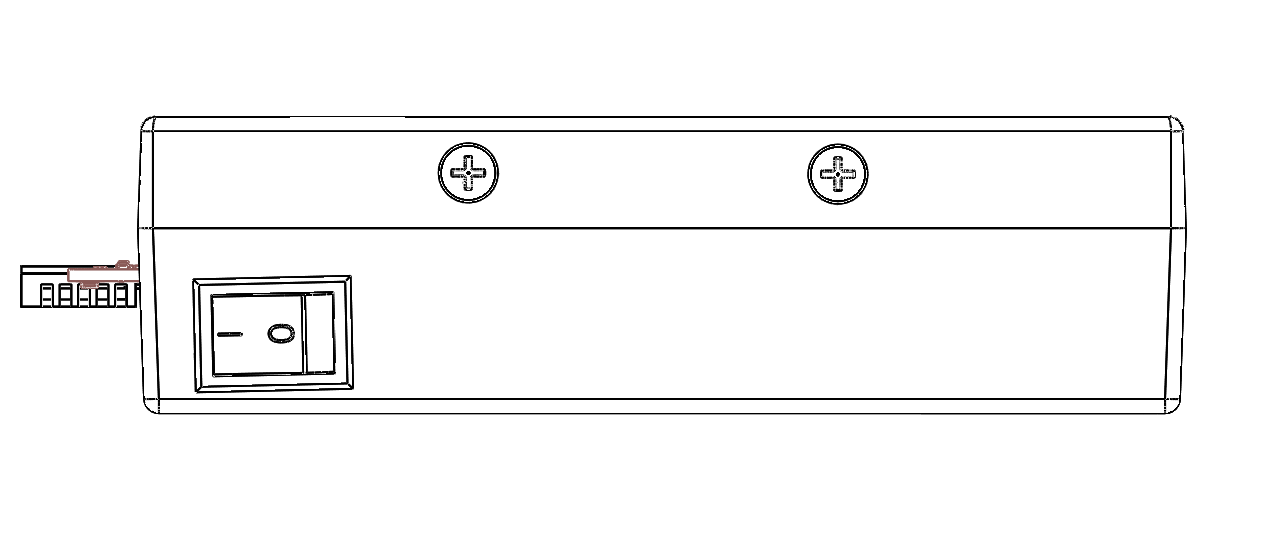
Datasheets/Product Views/SensorLeftOutline.png
