Kalana304/CEM_Design_Files/Datasheets/Product Views/SensorRightOultine.png

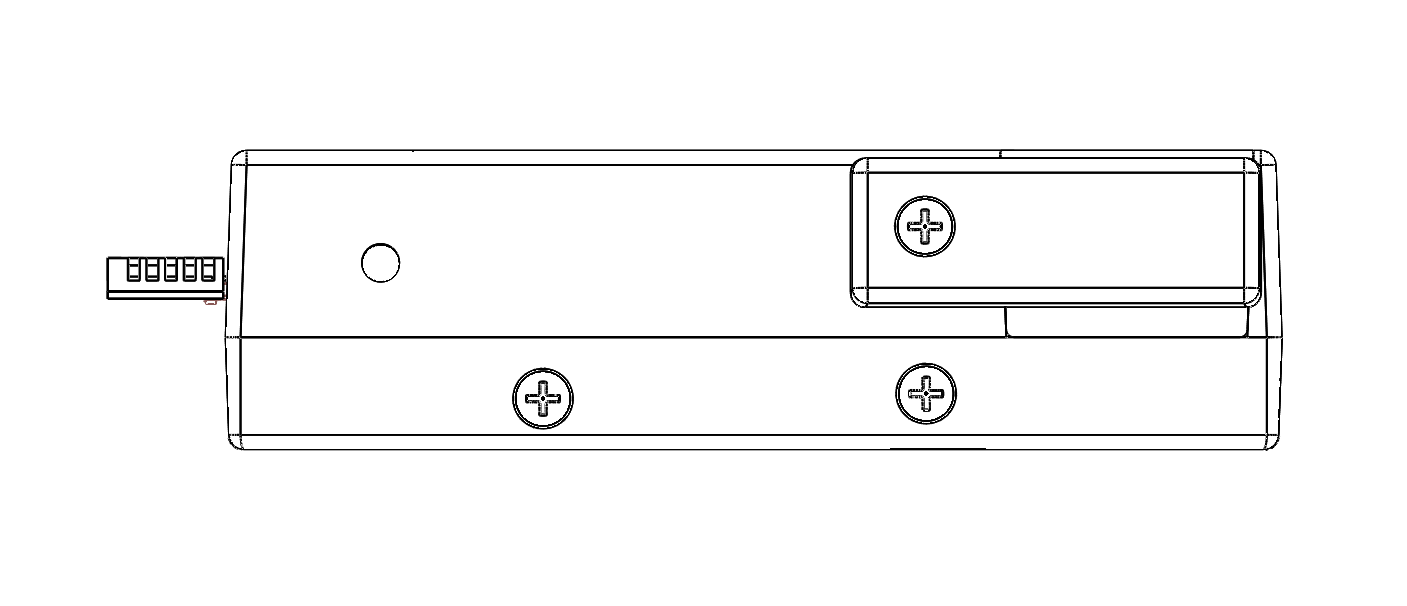
Datasheets/Product Views/SensorRightOultine.png
