Kalana304/CEM_Design_Files/Datasheets/Product Views/SensorTopOutline.png

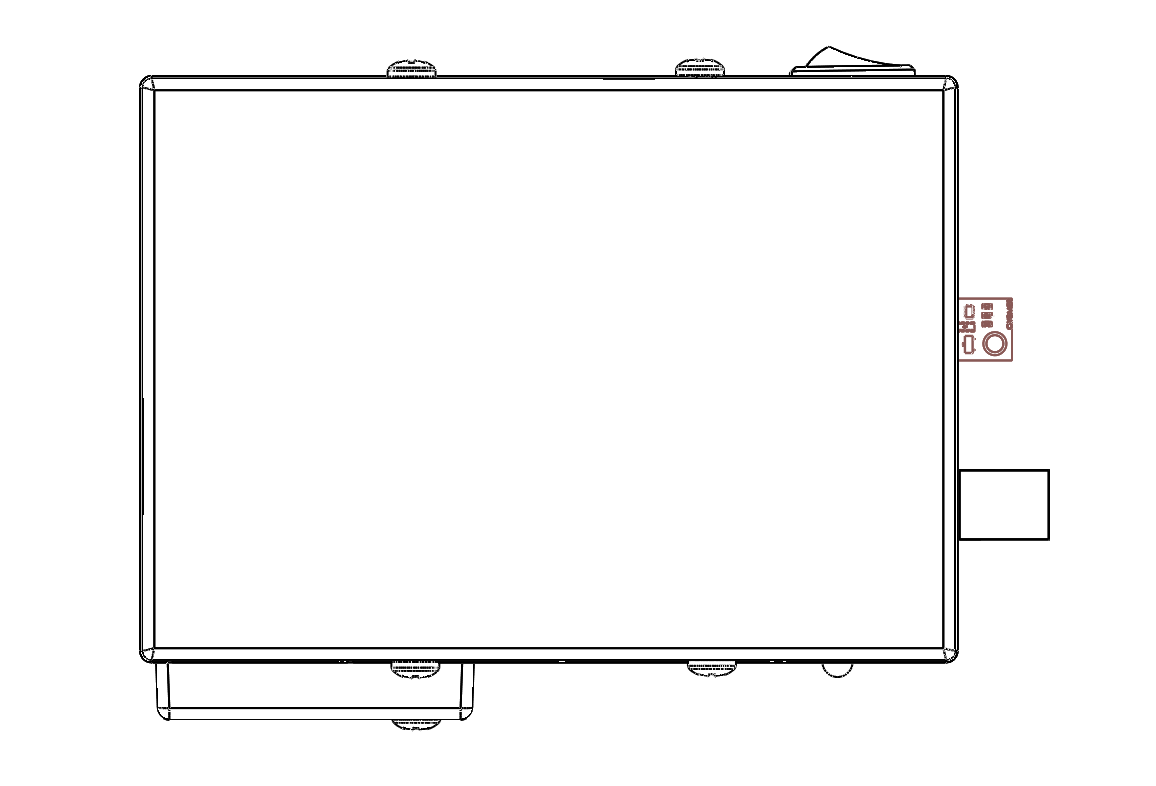
Datasheets/Product Views/SensorTopOutline.png
