Kalana304/CEM_Design_Files/Reports/Circuit Information/bot_display unit.png

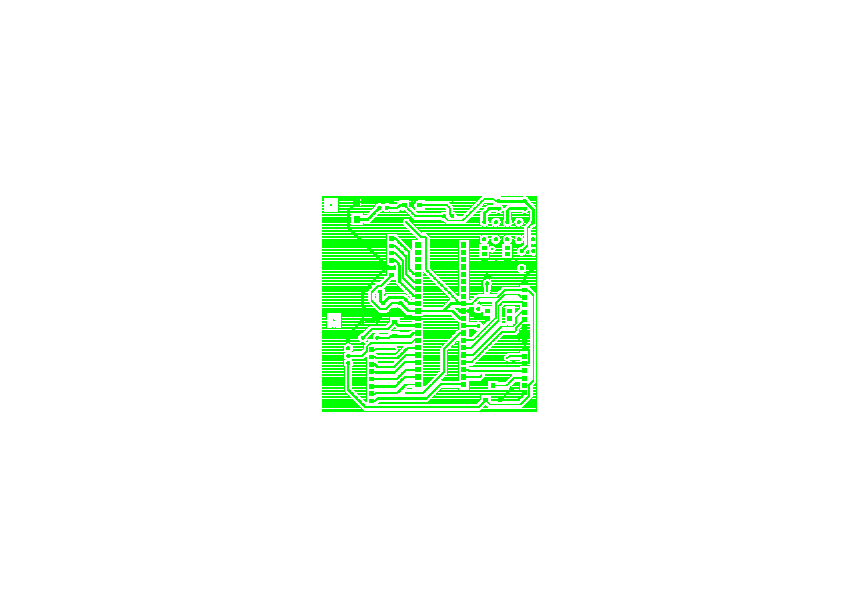
Reports/Circuit Information/bot_display unit.png
