Kalana304/CEM_Design_Files/Reports/Circuit Information/cct diagram Display unit_Page_5.png

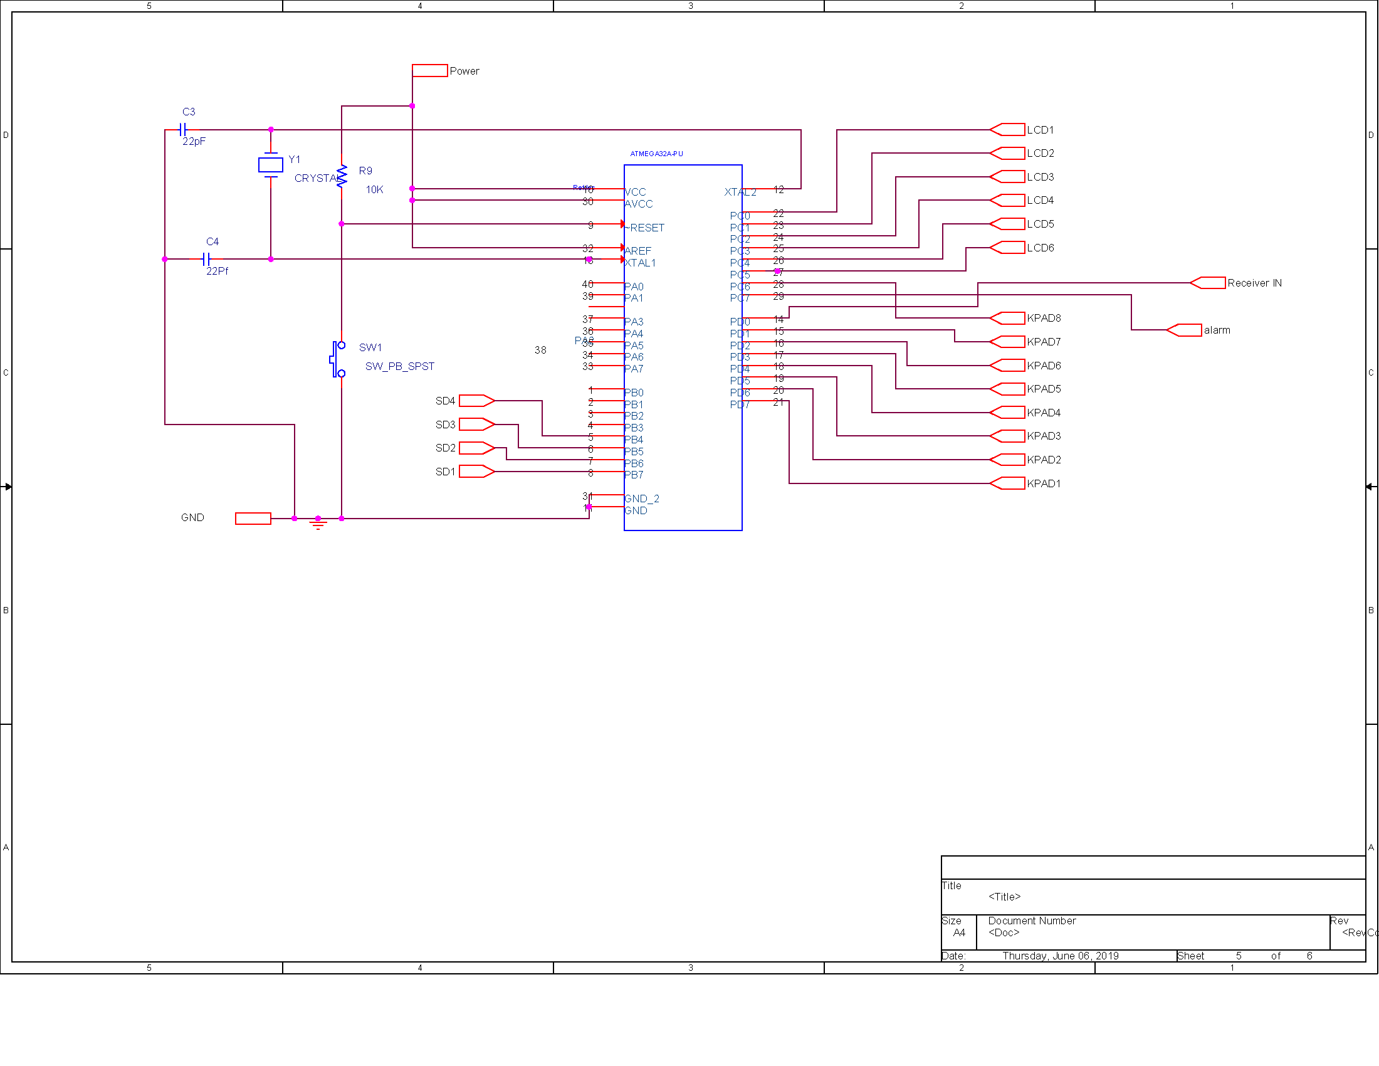
Reports/Circuit Information/cct diagram Display unit_Page_5.png
