Kalana304/CEM_Design_Files/Reports/Circuit Information/cct diagram Sensor schem_Page_1.png

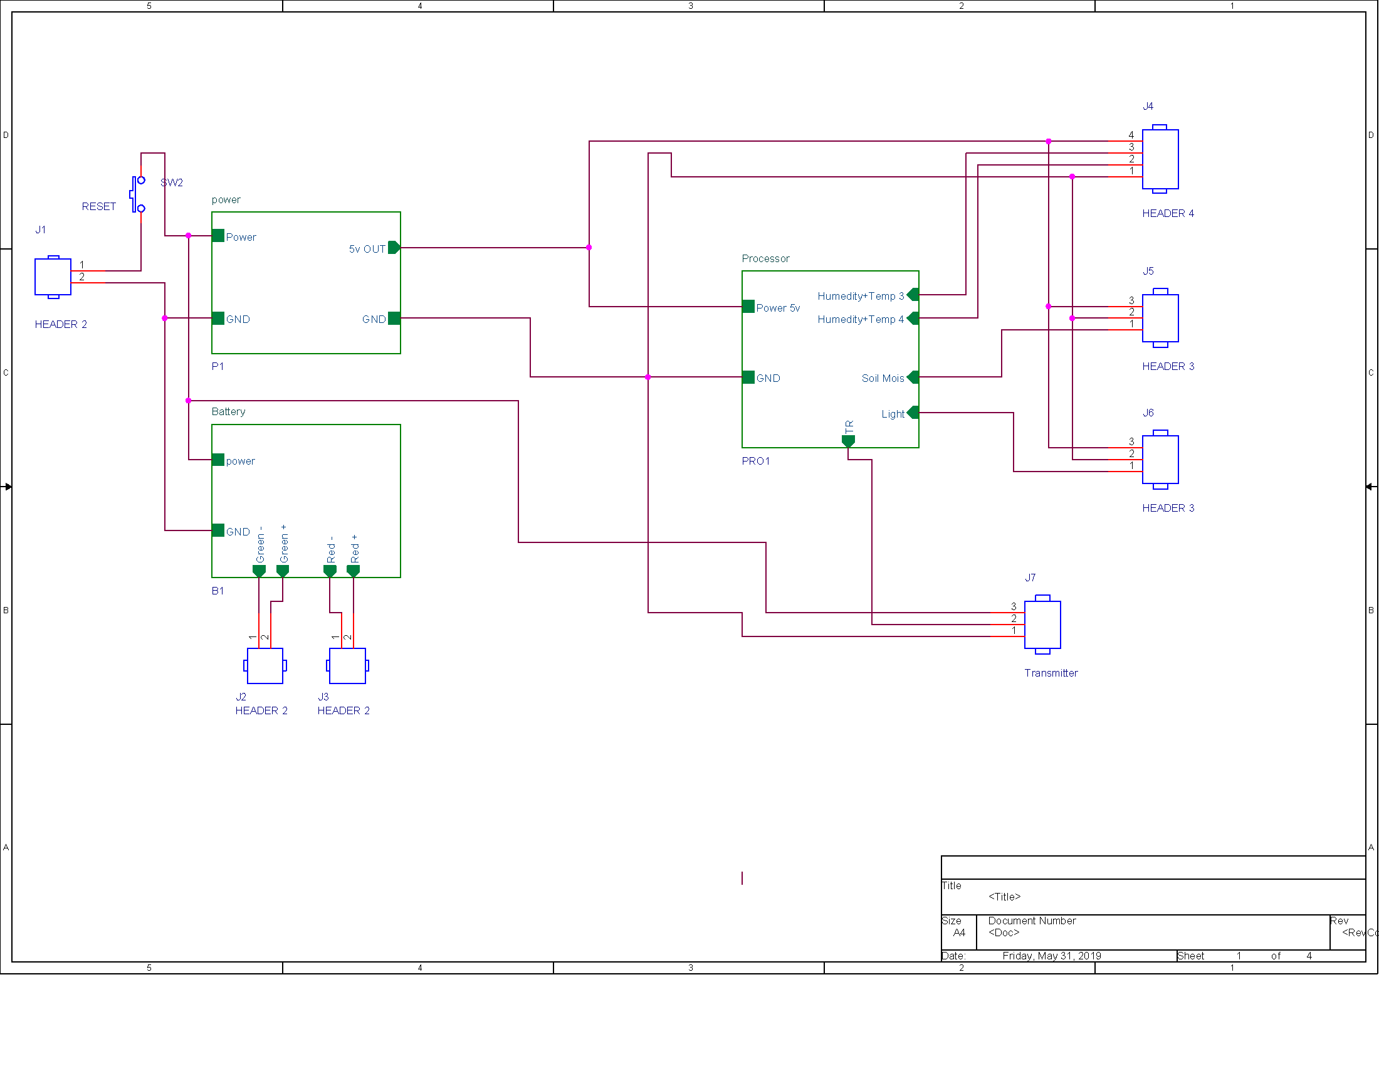
Reports/Circuit Information/cct diagram Sensor schem_Page_1.png
