Kalana304/CEM_Design_Files/SolidWorks/LED light/Temperature-humidity-sensor/Adsong DHT21 - 2.JPG

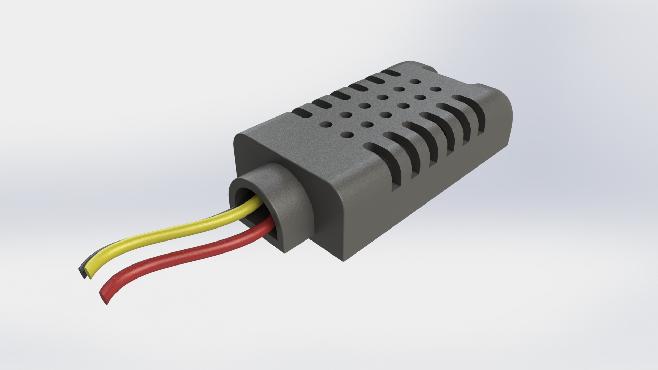
SolidWorks/LED light/Temperature-humidity-sensor/Adsong DHT21 - 2.JPG
