Kalana304/CEM_Design_Files/Untitled Project.tif

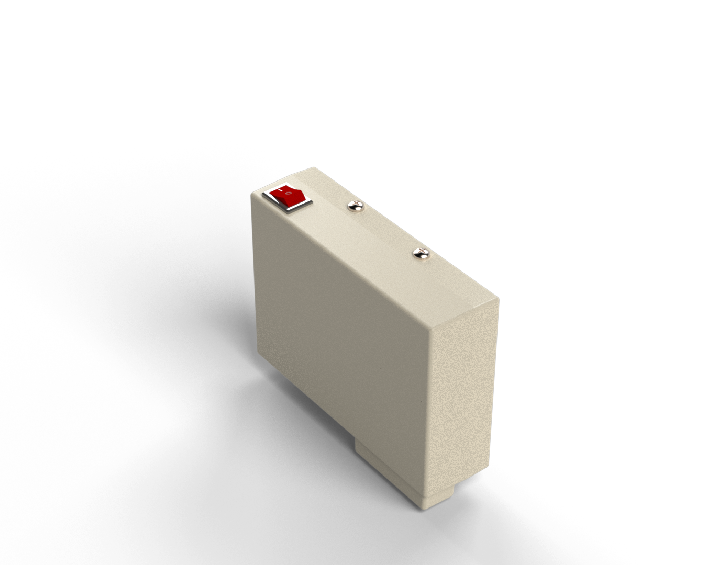
Untitled Project.tif
