Kalana304/CEM_Design_Files/Display Unit/Assem4.SLDASM

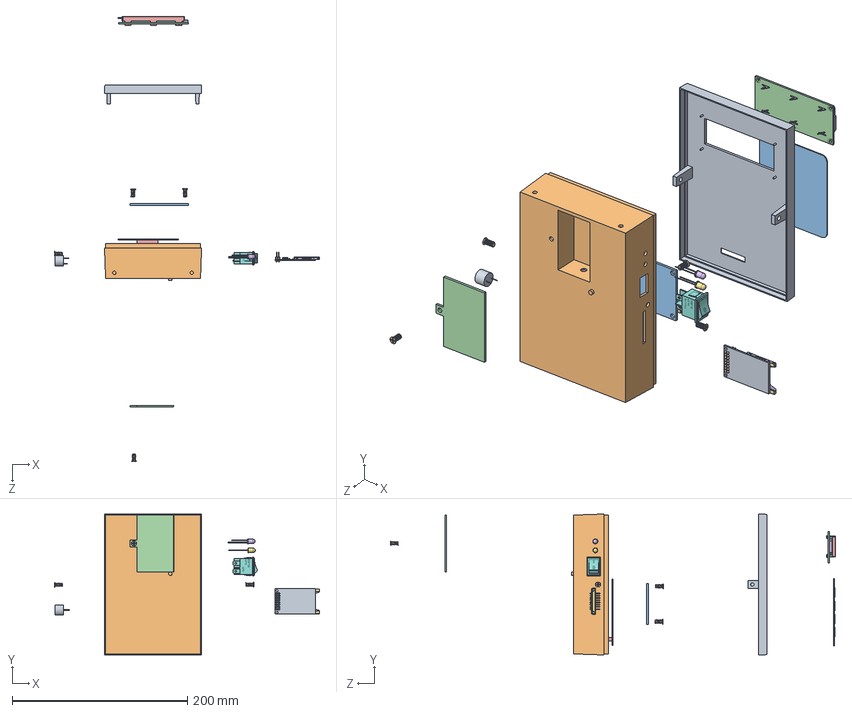
[picture p202: CAD file, 2019-06-17]
Display Unit/Assem4.SLDASM
302.0 x 160.7 x 507.4 mm
Top
Bottom
PCB^Assem4
Battery Cover
led1
led2
SWITCH KCD1-104
placa
8pin_header
RESISTOR_SMD_103 x 4
CAPACITOR_805 x 2
CAPACITOR_1206 x 2
SD_CASCA
interno_sd
AMS1117
PINO_SD x 11
universal screw x 7
Md0090
LCD_PCB
metal_casing
LCDbacklight
LCD
conductors x 2
Altavoz
