Kalana304/CEM_Design_Files/SolidWorks/Display Unit/Assem3.SLDASM

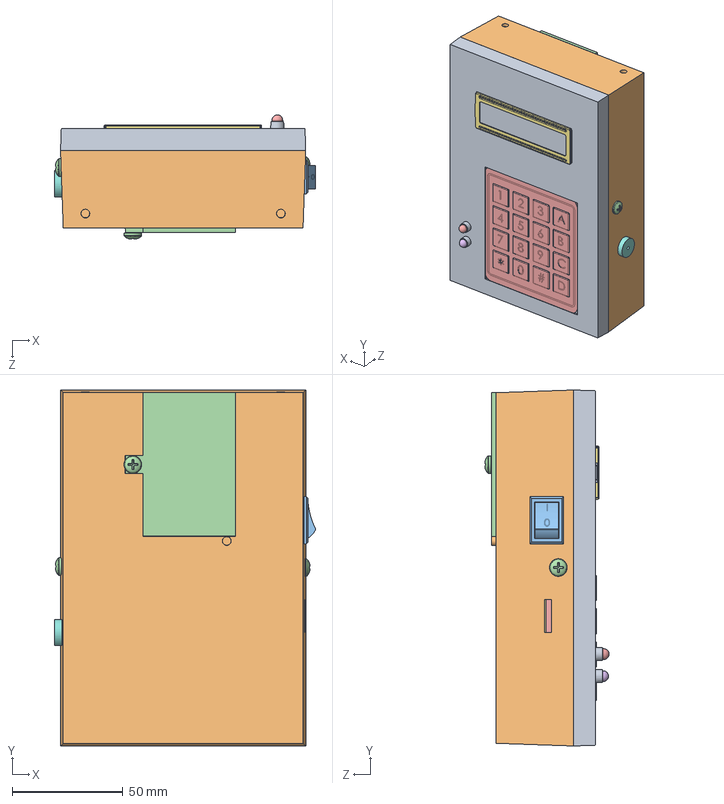
[picture p203: CAD file, 2019-06-17]
SolidWorks/Display Unit/Assem3.SLDASM
118.0 x 160.7 x 56.1 mm
Top
Bottom
PCB^Assem3
Battery Cover
Md0090
LCD_PCB
metal_casing
LCDbacklight
LCD
conductors x 2
SWITCH KCD1-104
No 8 Pan Head Screw x 3
led2
led1
placa
8pin_header
RESISTOR_SMD_103 x 4
CAPACITOR_805 x 2
CAPACITOR_1206 x 2
SD_CASCA
interno_sd
AMS1117
PINO_SD x 11
Altavoz
