Kalana304/CEM_Design_Files/SolidWorks/Sensor Unit Complete/Sensor Unit.SLDASM

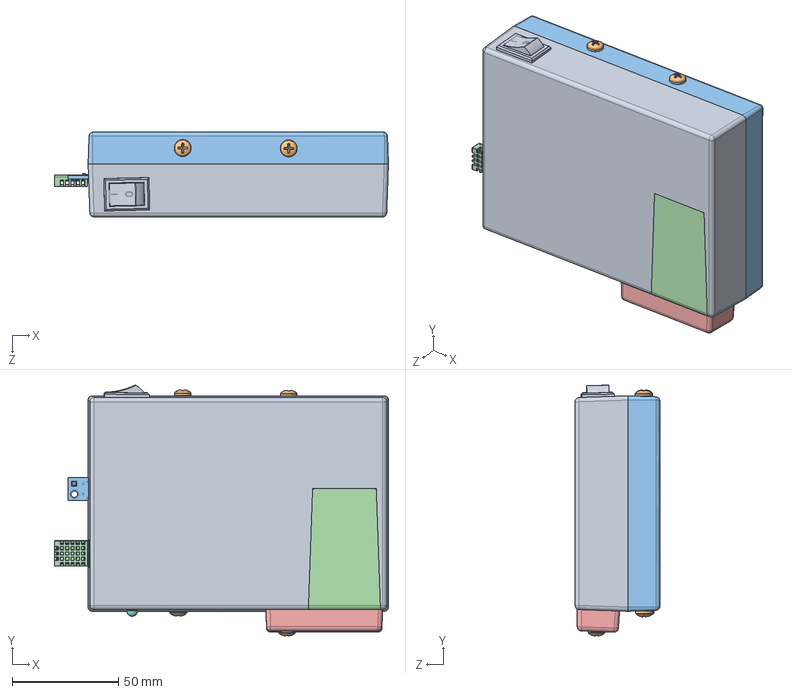
[picture p204: CAD file, 2019-06-17]
SolidWorks/Sensor Unit Complete/Sensor Unit.SLDASM
157.3 x 118.1 x 40.0 mm
Bottom
Board
Top
Battery Cover
Battery Lock
Battery^Sensor Unit
led1
SWITCH KCD1-104
No 8 Pan Head Screw x 5
GY-BME280
DHT11
