Kalana304/CEM_Design_Files/SolidWorks/LED light/16x2-character-lcd-display-1.snapshot.2/DFRobot_1602_LCD.SLDASM

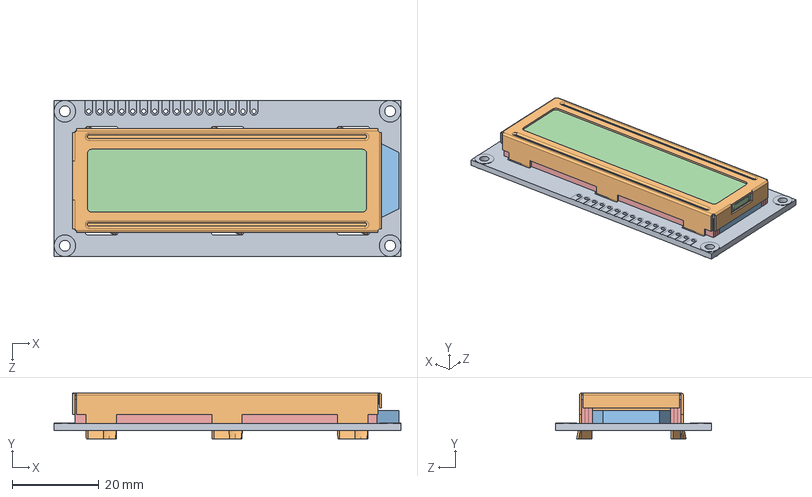
[picture p205: CAD file, 2019-06-17]
SolidWorks/LED light/16x2-character-lcd-display-1.snapshot.2/DFRobot_1602_LCD.SLDASM
80.0 x 10.6 x 36.0 mm
LCD_PCB
metal_casing
LCDbacklight
LCD
conductors x 2
