Kalana304/CEM_Design_Files/SolidWorks/LED light/sd-card-reader-1.snapshot.2/SD_CARD.SLDASM

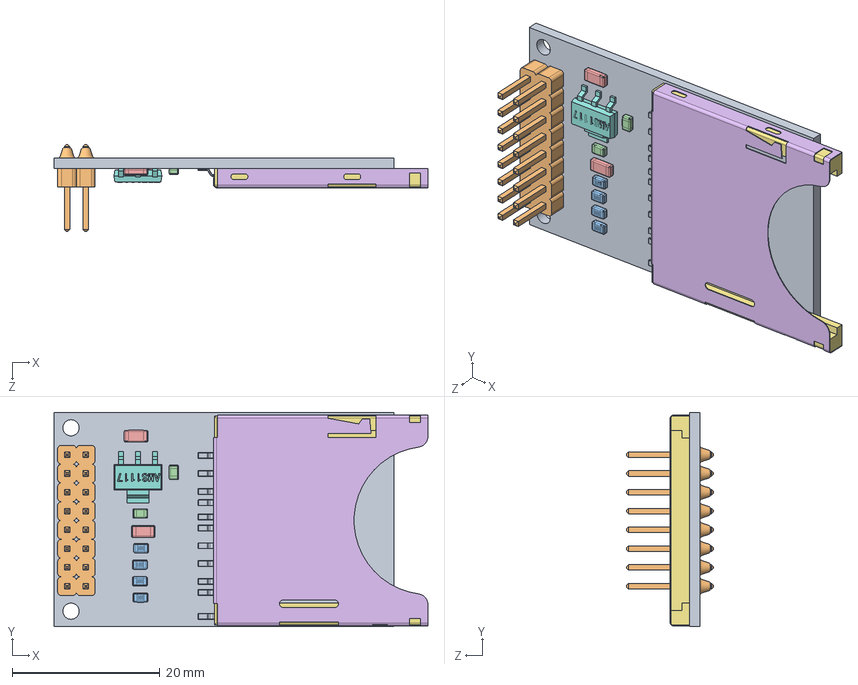
[picture p206: CAD file, 2019-06-17]
SolidWorks/LED light/sd-card-reader-1.snapshot.2/SD_CARD.SLDASM
50.6 x 29.0 x 11.8 mm
placa
8pin_header
RESISTOR_SMD_103 x 4
CAPACITOR_805 x 2
CAPACITOR_1206 x 2
SD_CASCA
interno_sd
AMS1117
PINO_SD x 11
