Kalana304/CEM_Design_Files/SolidWorks/LED light/16x2-character-lcd-display-1.snapshot.2/LCD.SLDPRT

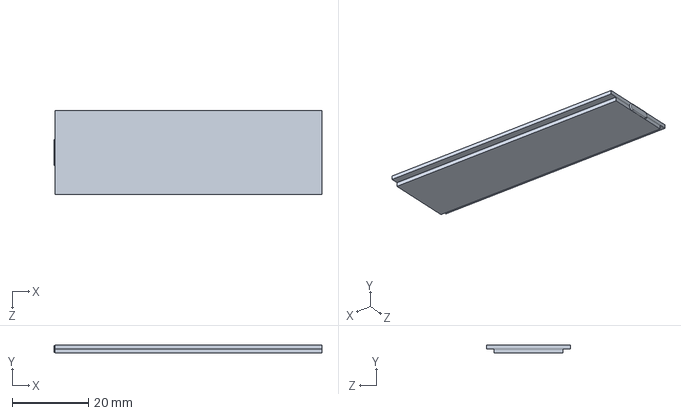
[picture p207: CAD file, 2019-06-17]
SolidWorks/LED light/16x2-character-lcd-display-1.snapshot.2/LCD.SLDPRT
70.3 x 2.10 x 22.0 mm
