Kalana304/CEM_Design_Files/SolidWorks/LED light/arduino-buzzer-1.snapshot.2/Altavoz.SLDPRT

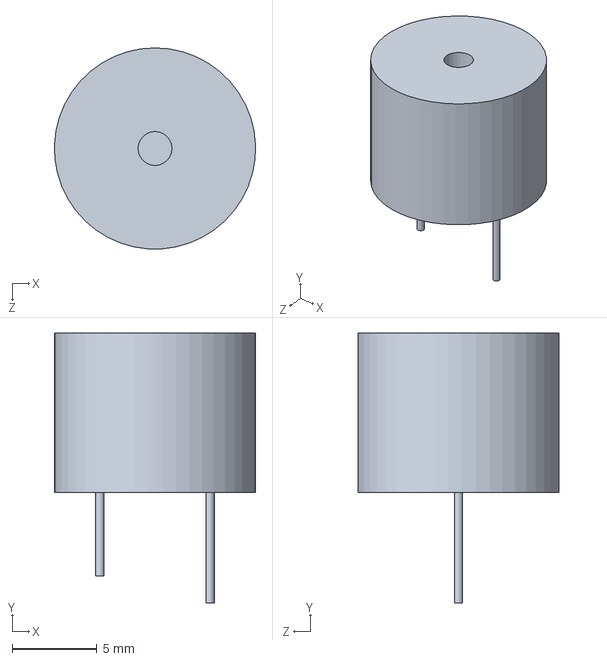
[picture p208: CAD file, 2019-06-17]
SolidWorks/LED light/arduino-buzzer-1.snapshot.2/Altavoz.SLDPRT
11.8 x 15.9 x 11.9 mm
