Kalana304/CEM_Design_Files/SolidWorks/LED light/LightSensor/GY-BME280.SLDPRT

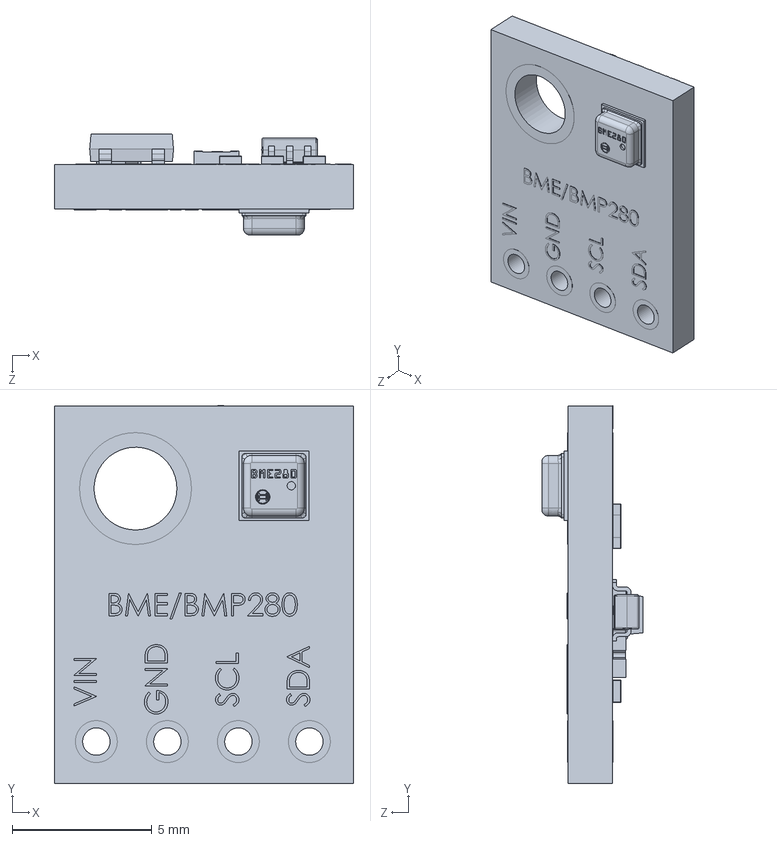
[picture p209: CAD file, 2019-06-17]
SolidWorks/LED light/LightSensor/GY-BME280.SLDPRT
10.7 x 13.5 x 3.63 mm
