Kalana304/CEM_Design_Files/SolidWorks/LED light/Md0090.SLDPRT

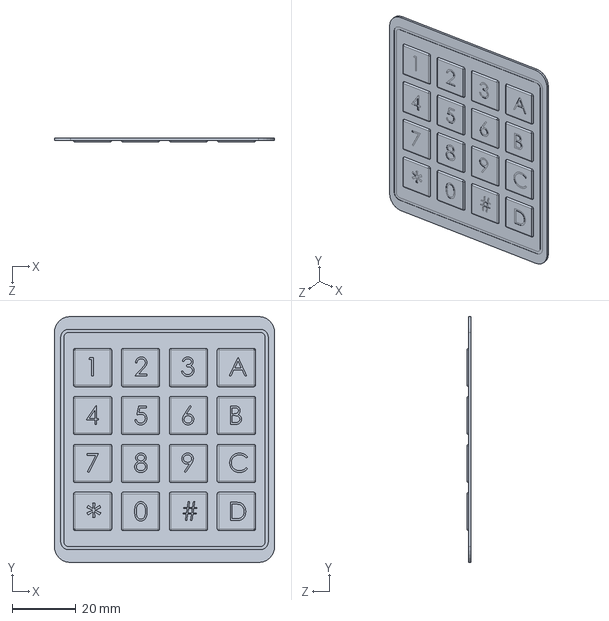
[picture p210: CAD file, 2019-06-17]
SolidWorks/LED light/Md0090.SLDPRT
69.0 x 77.0 x 1.31 mm
