Kalana304/CEM_Design_Files/SolidWorks/LED light/sd-card-reader-1.snapshot.2/8pin_header.SLDPRT

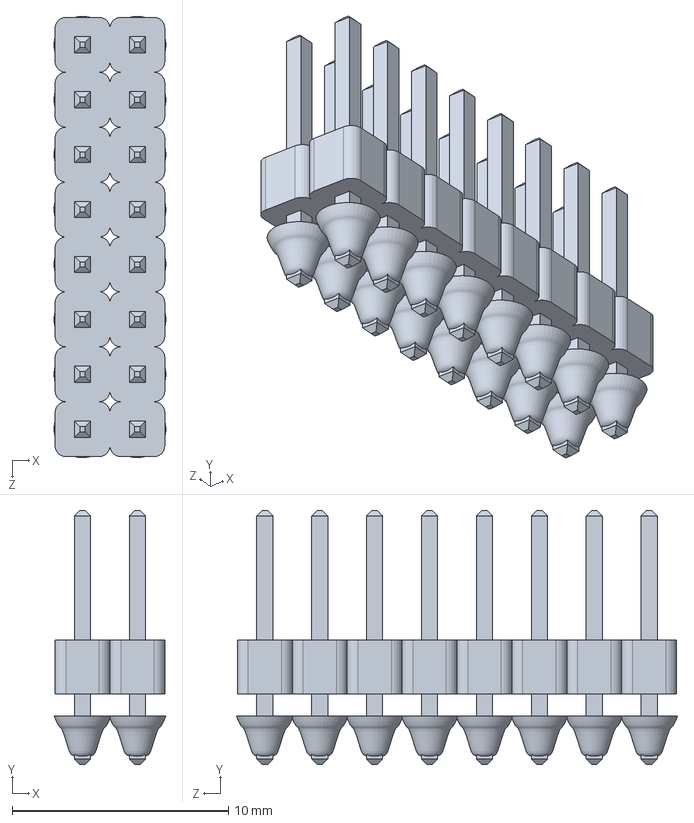
[picture p211: CAD file, 2019-06-17]
SolidWorks/LED light/sd-card-reader-1.snapshot.2/8pin_header.SLDPRT
5.18 x 11.8 x 20.4 mm
