Kalana304/CEM_Design_Files/SolidWorks/LED light/Temperature-humidity-sensor/Adsong DHT21.SLDPRT

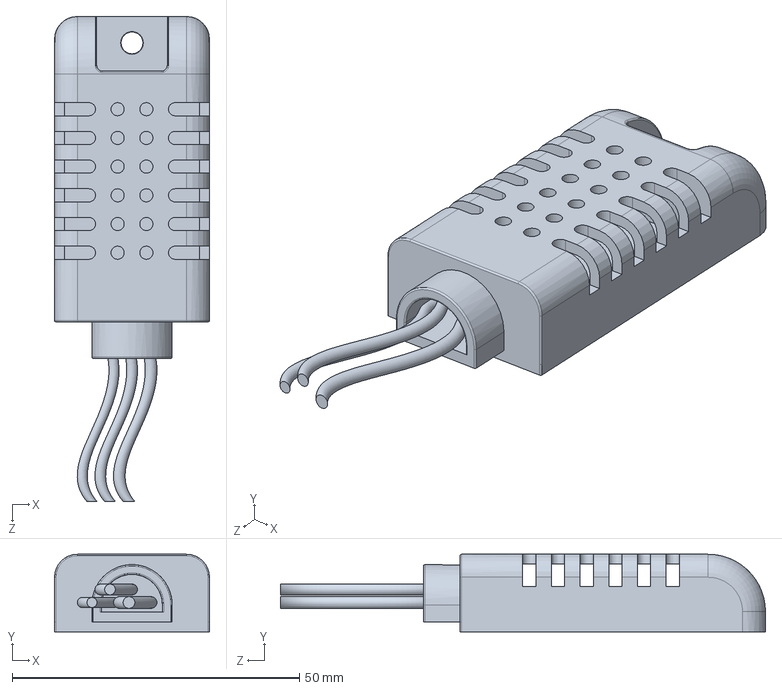
[picture p212: CAD file, 2019-06-17]
SolidWorks/LED light/Temperature-humidity-sensor/Adsong DHT21.SLDPRT
27.0 x 13.5 x 84.5 mm
