Kalana304/CEM_Design_Files/SolidWorks/LED light/Tempsensor/DHT11.STEP

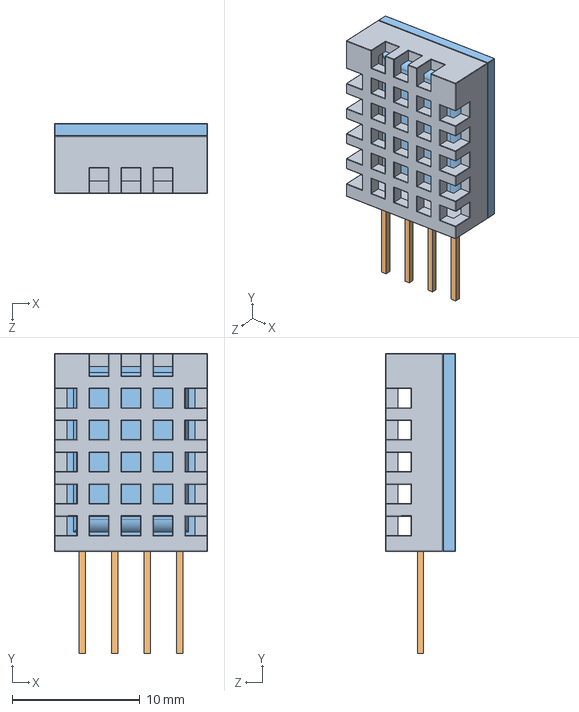
[picture p213: CAD file, 2019-06-17]
SolidWorks/LED light/Tempsensor/DHT11.STEP
12.0 x 23.5 x 5.50 mm
