Kalana304/CEM_Design_Files/Display Unit/Part2.sldprt

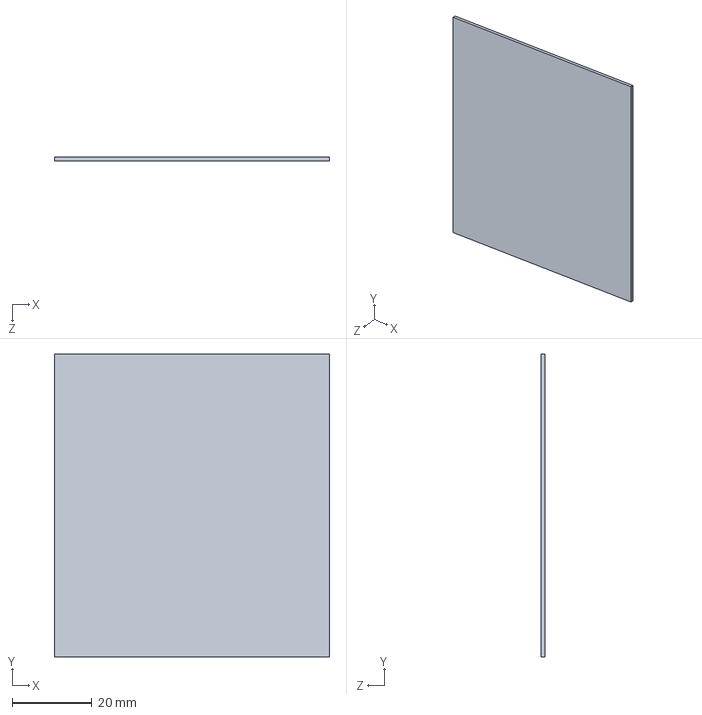
[picture p214: CAD file, 2019-06-17]
Display Unit/Part2.sldprt
68.9 x 75.9 x 1.00 mm
