Kalana304/CEM_Design_Files/SolidWorks/LED light/16x2-character-lcd-display-1.snapshot.2/metal_casing.SLDPRT

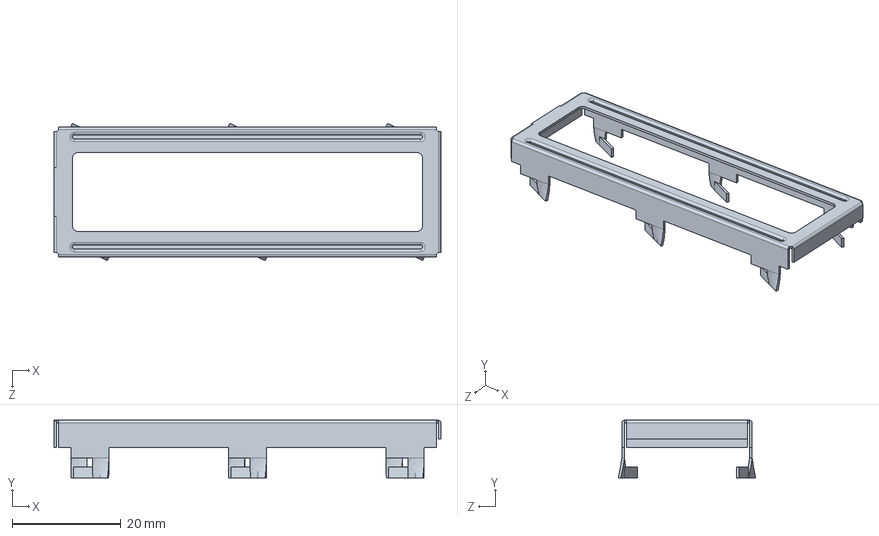
[picture p216: CAD file, 2019-06-17]
SolidWorks/LED light/16x2-character-lcd-display-1.snapshot.2/metal_casing.SLDPRT
71.2 x 10.6 x 25.3 mm
