Kalana304/CEM_Design_Files/SolidWorks/LED light/led1.SLDPRT

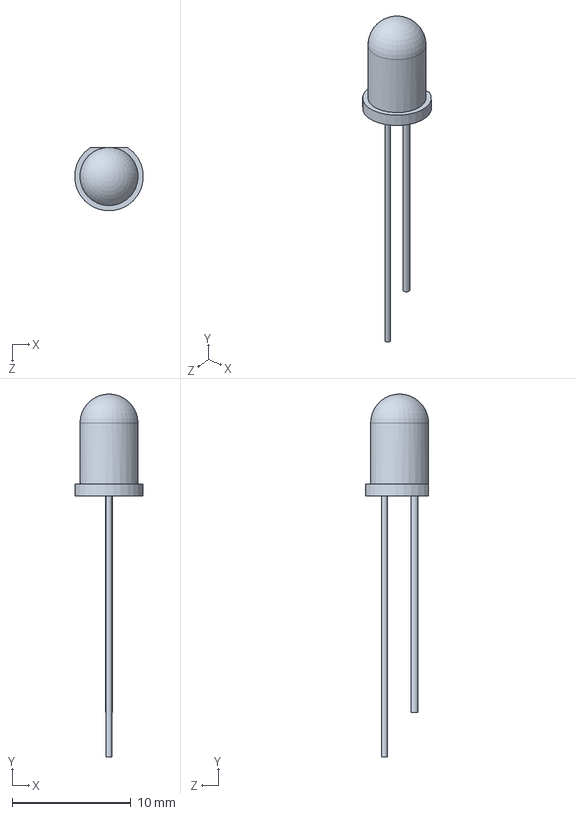
[picture p217: CAD file, 2019-06-17]
SolidWorks/LED light/led1.SLDPRT
5.77 x 30.6 x 5.33 mm
