Kalana304/CEM_Design_Files/SolidWorks/LED light/sd-card-reader-1.snapshot.2/CAPACITOR_1206.SLDPRT

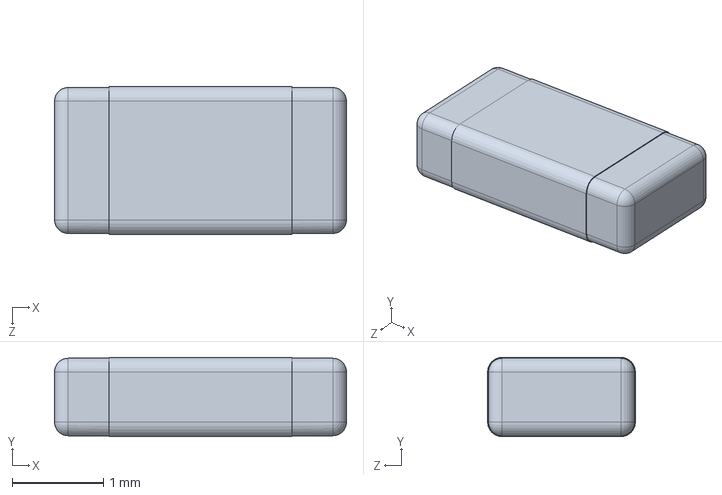
[picture p218: CAD file, 2019-06-17]
SolidWorks/LED light/sd-card-reader-1.snapshot.2/CAPACITOR_1206.SLDPRT
3.20 x 0.87 x 1.62 mm
