Kalana304/CEM_Design_Files/SolidWorks/Sensor Unit Complete/Bottom.SLDPRT

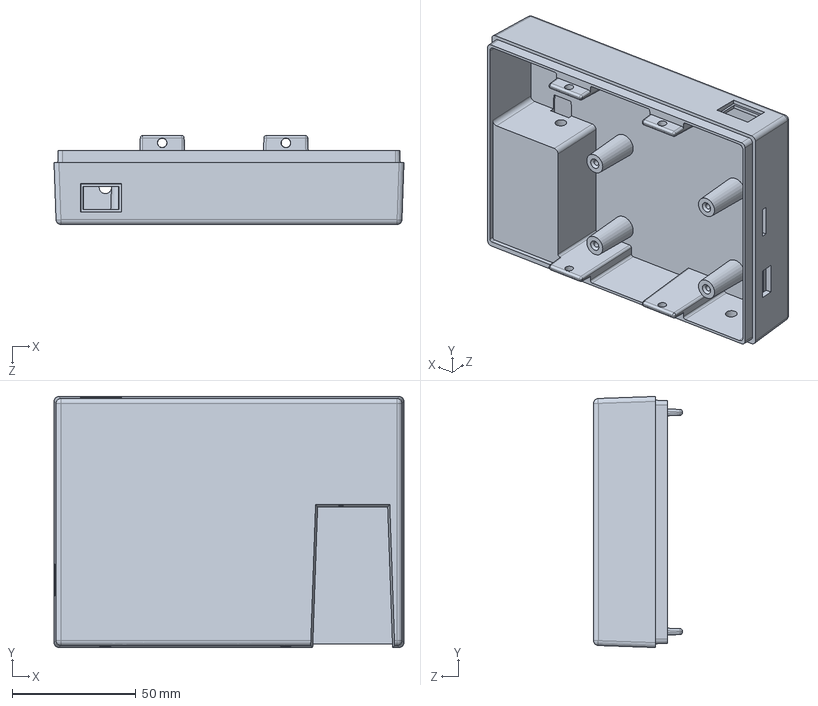
[picture p219: CAD file, 2019-06-17]
SolidWorks/Sensor Unit Complete/Bottom.SLDPRT
141.5 x 101.5 x 36.0 mm
