Kalana304/CEM_Design_Files/Display Unit/Top.SLDPRT

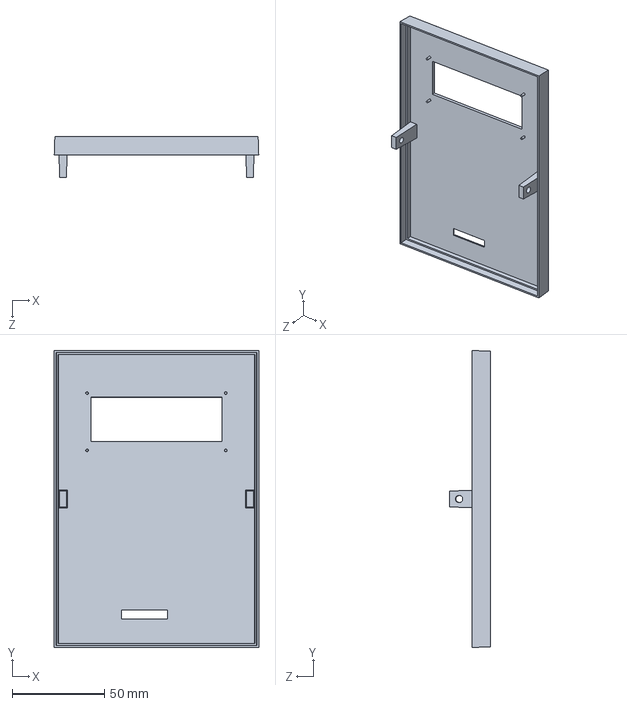
[picture p220: CAD file, 2019-06-17]
Display Unit/Top.SLDPRT
110.7 x 160.7 x 22.0 mm
