Kalana304/CEM_Design_Files/SolidWorks/Display Unit/Assem3 - Battery Cover-2.STL

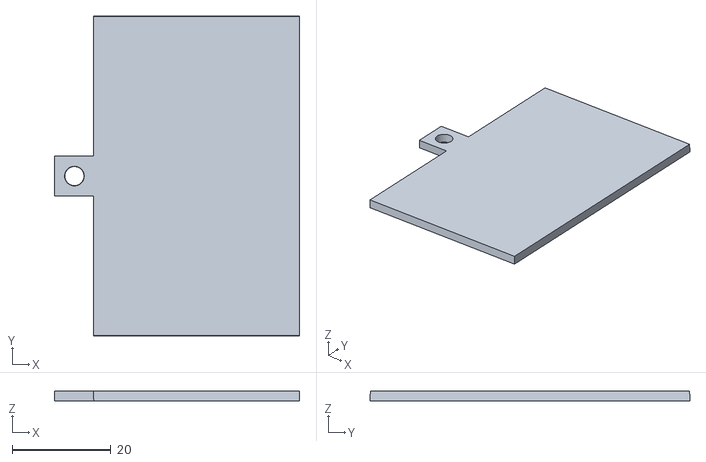
[picture p221: CAD file, 2019-06-03]
SolidWorks/Display Unit/Assem3 - Battery Cover-2.STL
49.8 x 64.9 x 2.00
