Kalana304/CEM_Design_Files/SolidWorks/LED light/16x2-character-lcd-display-1.snapshot.2/LCD_PCB.SLDPRT

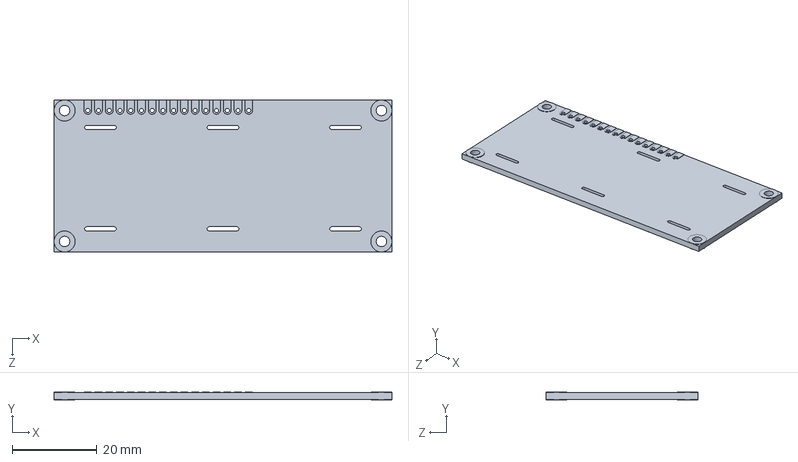
[picture p222: CAD file, 2019-06-17]
SolidWorks/LED light/16x2-character-lcd-display-1.snapshot.2/LCD_PCB.SLDPRT
80.0 x 1.80 x 36.0 mm
