Kalana304/CEM_Design_Files/SolidWorks/LED light/sd-card-reader-1.snapshot.2/CAPACITOR_805.SLDPRT

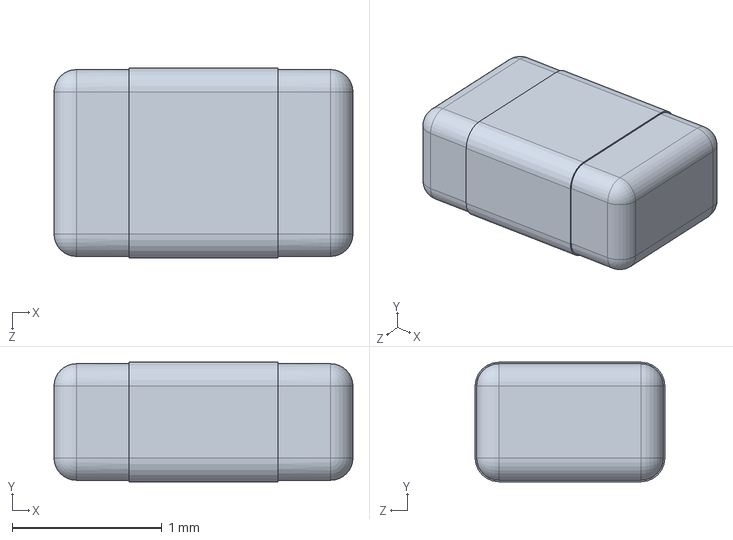
[picture p223: CAD file, 2019-06-17]
SolidWorks/LED light/sd-card-reader-1.snapshot.2/CAPACITOR_805.SLDPRT
2.00 x 0.8 x 1.27 mm
