Kalana304/CEM_Design_Files/SolidWorks/Display Unit/Assem3 - Top-1.STL

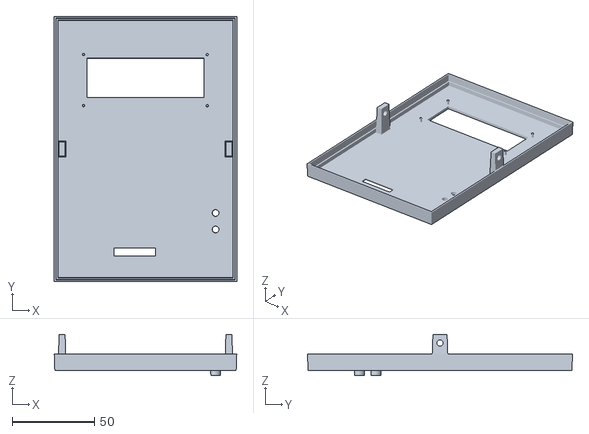
[picture p224: CAD file, 2019-06-03]
SolidWorks/Display Unit/Assem3 - Top-1.STL
110.7 x 160.7 x 25.0
