Kalana304/CEM_Design_Files/SolidWorks/LED light/16x2-character-lcd-display-1.snapshot.2/LCDbacklight.SLDPRT

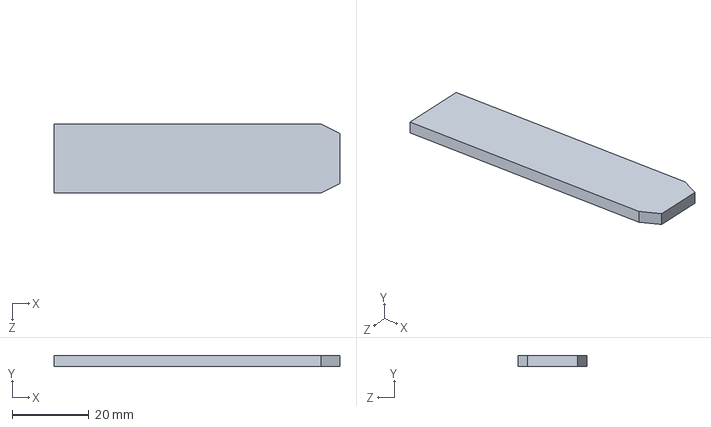
[picture p225: CAD file, 2019-06-17]
SolidWorks/LED light/16x2-character-lcd-display-1.snapshot.2/LCDbacklight.SLDPRT
74.7 x 3.00 x 18.0 mm
