Kalana304/CEM_Design_Files/SolidWorks/LED light/sd-card-reader-1.snapshot.2/interno_sd.SLDPRT

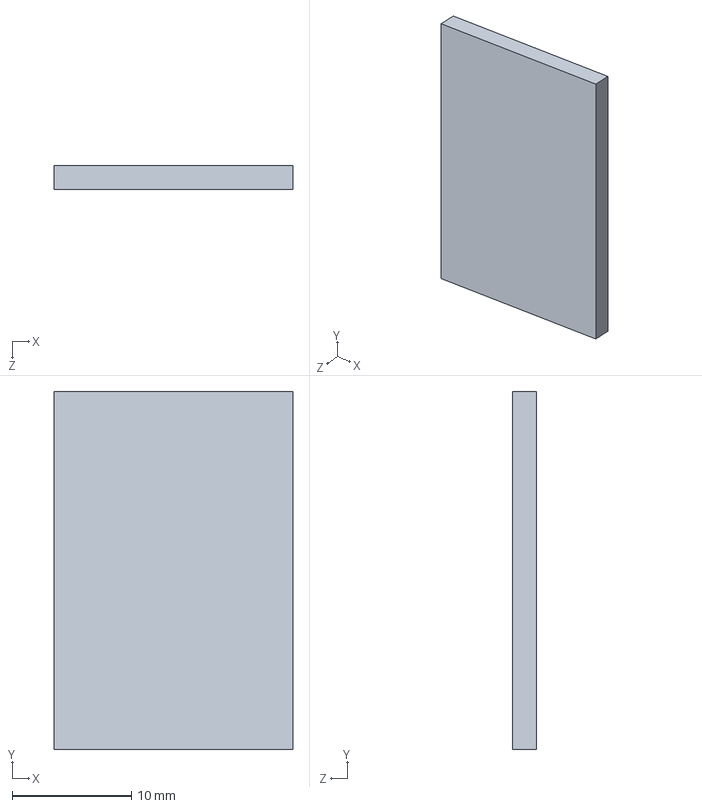
[picture p226: CAD file, 2019-06-17]
SolidWorks/LED light/sd-card-reader-1.snapshot.2/interno_sd.SLDPRT
20.0 x 30.0 x 2.00 mm
