Kalana304/CEM_Design_Files/SolidWorks/LED light/SWITCH KCD1-104.SLDPRT

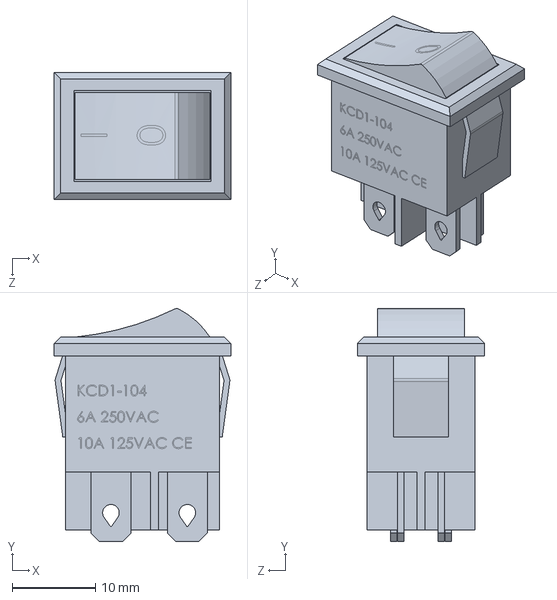
[picture p227: CAD file, 2019-06-17]
SolidWorks/LED light/SWITCH KCD1-104.SLDPRT
21.2 x 28.1 x 15.2 mm
