Kalana304/CEM_Design_Files/SolidWorks/Sensor Unit Complete/Top.sldprt

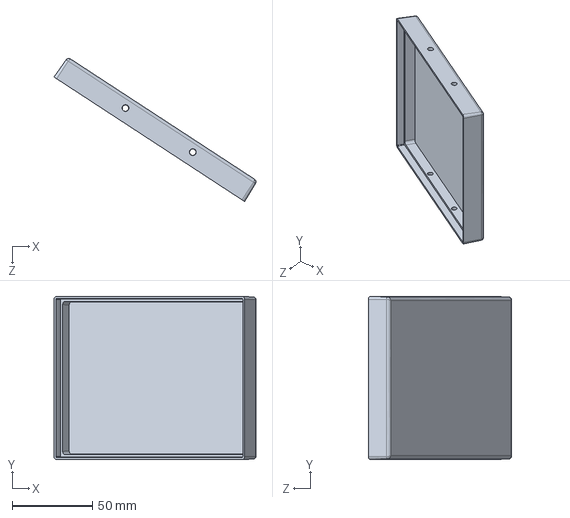
[picture p228: CAD file, 2019-06-17]
SolidWorks/Sensor Unit Complete/Top.sldprt
125.5 x 101.5 x 88.9 mm
