Kalana304/CEM_Design_Files/SolidWorks/Display Unit/Assem3 - PCB^Assem3-1.STL

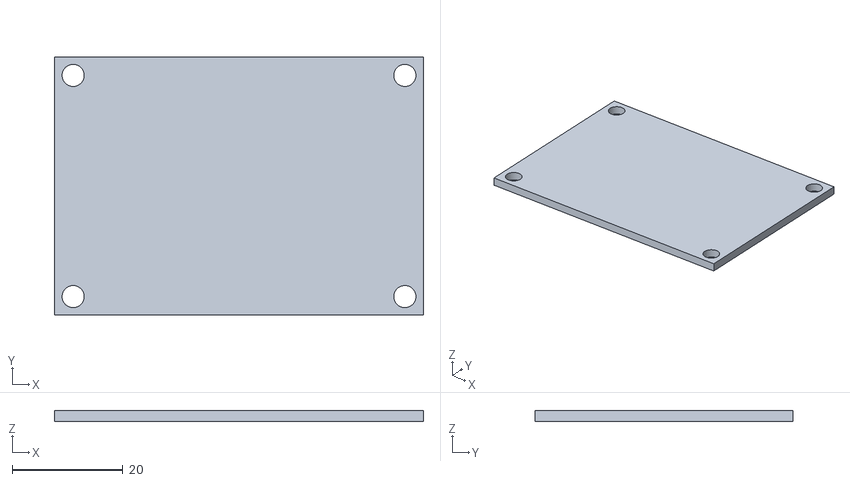
[picture p229: CAD file, 2019-06-03]
SolidWorks/Display Unit/Assem3 - PCB^Assem3-1.STL
66.7 x 46.7 x 2.00
