Kalana304/CEM_Design_Files/SolidWorks/LED light/16x2-character-lcd-display-1.snapshot.2/conductors.SLDPRT

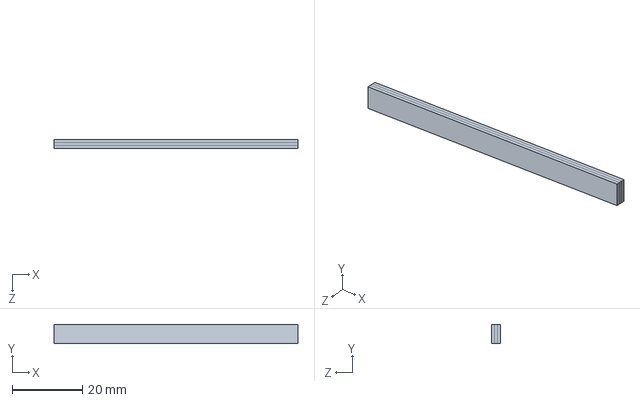
[picture p230: CAD file, 2019-06-17]
SolidWorks/LED light/16x2-character-lcd-display-1.snapshot.2/conductors.SLDPRT
69.7 x 5.50 x 2.50 mm
