Kalana304/CEM_Design_Files/SolidWorks/LED light/sd-card-reader-1.snapshot.2/SD_CASCA.SLDPRT

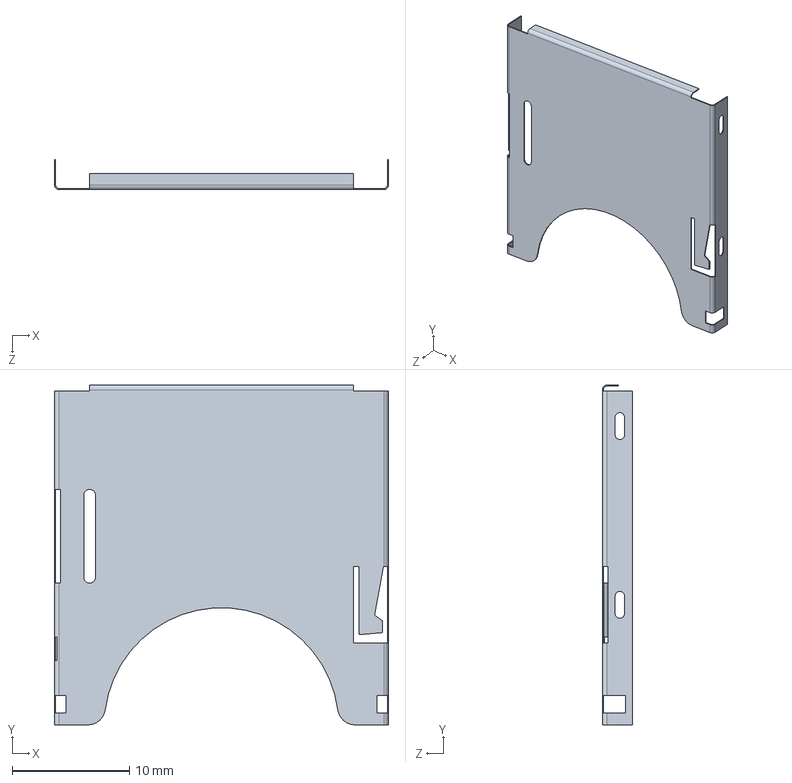
[picture p231: CAD file, 2019-06-17]
SolidWorks/LED light/sd-card-reader-1.snapshot.2/SD_CASCA.SLDPRT
28.5 x 29.0 x 2.60 mm
