Kalana304/CEM_Design_Files/SolidWorks/Sensor Unit Complete/Battery Lock.sldprt

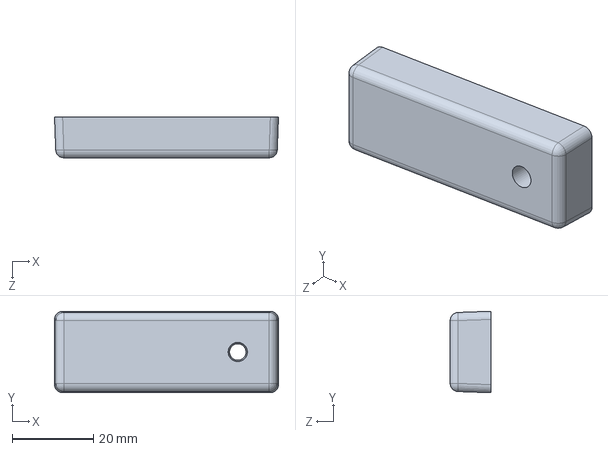
[picture p232: CAD file, 2019-06-17]
SolidWorks/Sensor Unit Complete/Battery Lock.sldprt
55.0 x 20.0 x 10.0 mm
