Kalana304/CEM_Design_Files/SolidWorks/Sensor Unit Complete/Battery Cover.sldprt

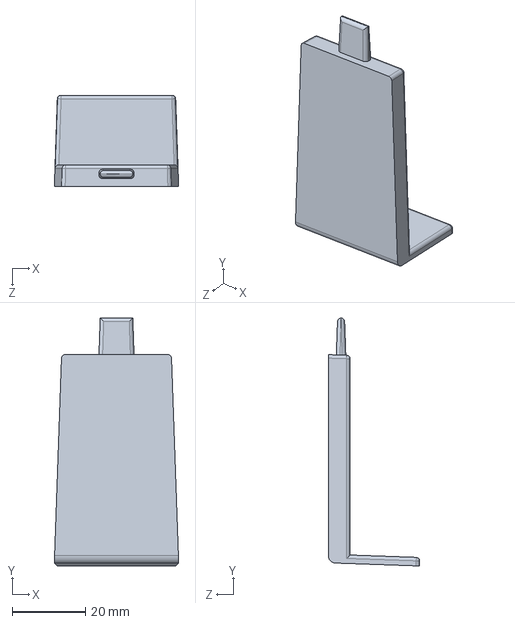
[picture p233: CAD file, 2019-06-17]
SolidWorks/Sensor Unit Complete/Battery Cover.sldprt
33.9 x 67.8 x 25.0 mm
