Kalana304/CEM_Design_Files/SolidWorks/LED light/sd-card-reader-1.snapshot.2/AMS1117.SLDPRT

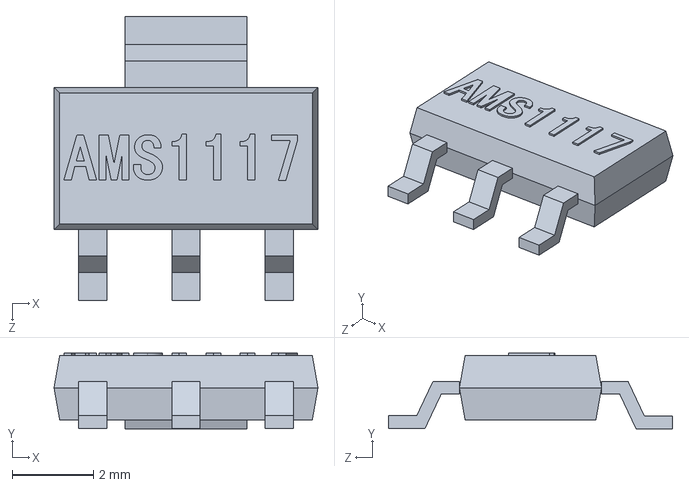
[picture p234: CAD file, 2019-06-17]
SolidWorks/LED light/sd-card-reader-1.snapshot.2/AMS1117.SLDPRT
6.50 x 1.86 x 7.00 mm
