Kalana304/CEM_Design_Files/SolidWorks/Sensor Unit Complete/Sensor Unit - Top-1.STL

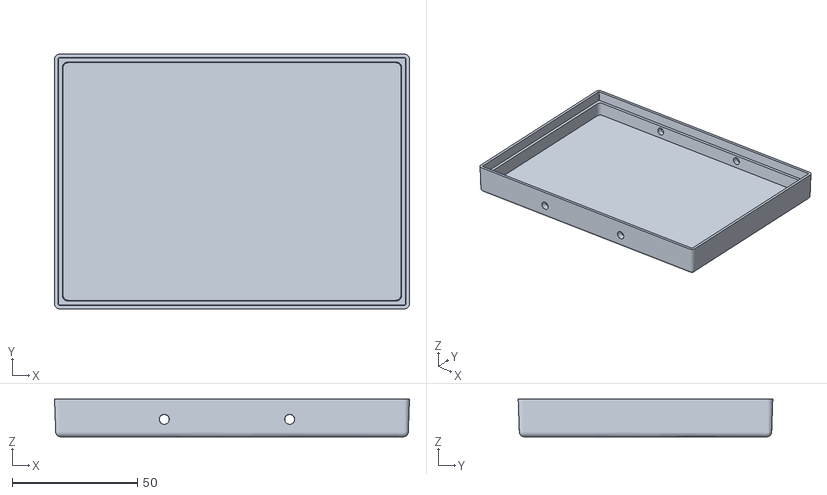
[picture p235: CAD file, 2019-06-03]
SolidWorks/Sensor Unit Complete/Sensor Unit - Top-1.STL
141.5 x 101.5 x 15.0
