Kalana304/CEM_Design_Files/SolidWorks/LED light/sd-card-reader-1.snapshot.2/RESISTOR_SMD_103.SLDPRT

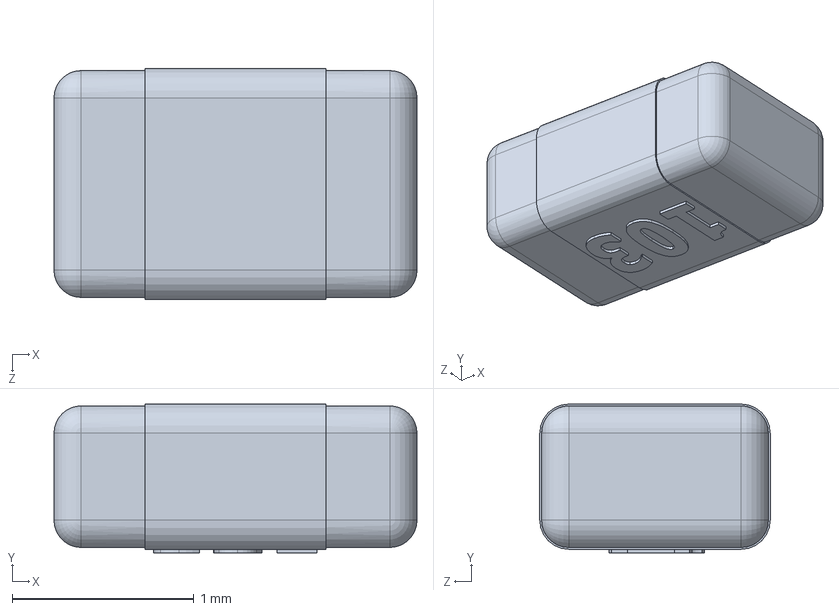
[picture p236: CAD file, 2019-06-17]
SolidWorks/LED light/sd-card-reader-1.snapshot.2/RESISTOR_SMD_103.SLDPRT
2.00 x 0.82 x 1.27 mm
