Kalana304/CEM_Design_Files/SolidWorks/LED light/sd-card-reader-1.snapshot.2/placa.SLDPRT

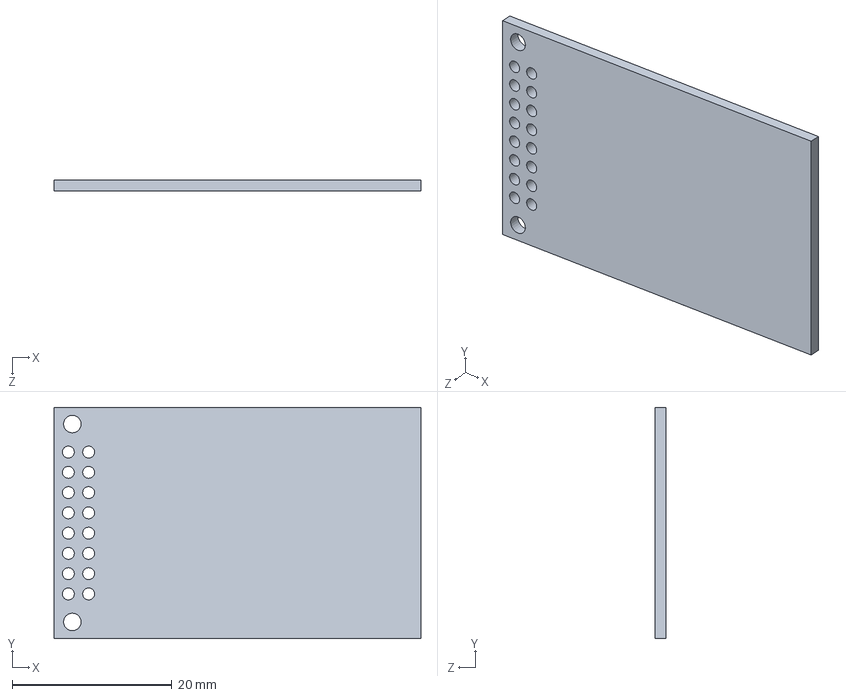
[picture p237: CAD file, 2019-06-17]
SolidWorks/LED light/sd-card-reader-1.snapshot.2/placa.SLDPRT
46.0 x 29.0 x 1.40 mm
