Kalana304/CEM_Design_Files/SolidWorks/LED light/sd-card-reader-1.snapshot.2/PINO_SD.SLDPRT

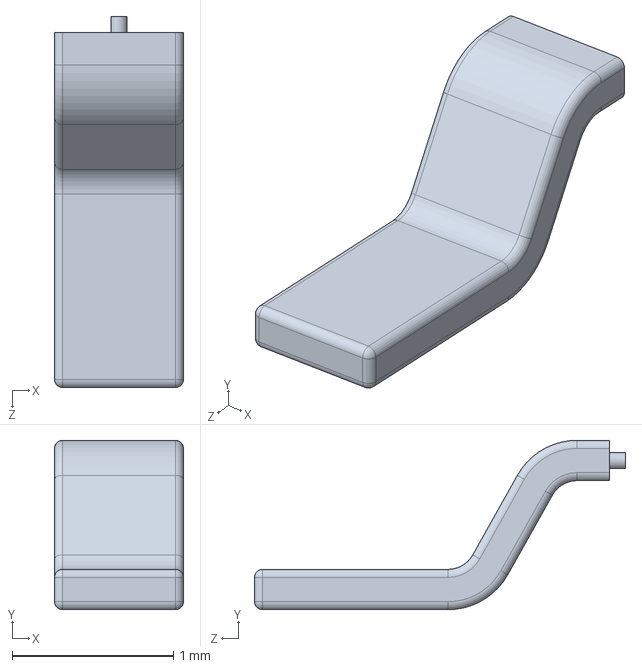
[picture p238: CAD file, 2019-06-17]
SolidWorks/LED light/sd-card-reader-1.snapshot.2/PINO_SD.SLDPRT
0.8 x 1.05 x 2.30 mm
