Kalana304/CEM_Design_Files/SolidWorks/Sensor Unit Complete/Sensor Unit - Battery Lock-1.STL

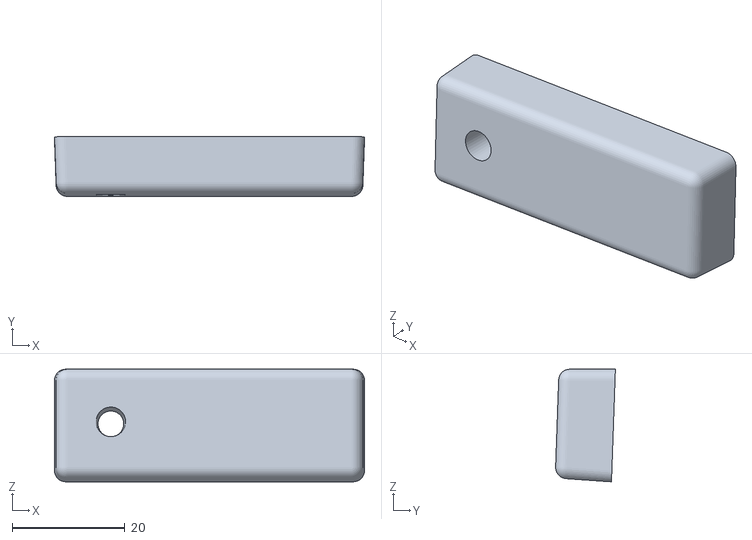
[picture p239: CAD file, 2019-06-03]
SolidWorks/Sensor Unit Complete/Sensor Unit - Battery Lock-1.STL
55.0 x 10.6 x 20.0
