Kalana304/CEM_Design_Files/SolidWorks/Sensor Unit Complete/Sensor Unit - Board-1.STL

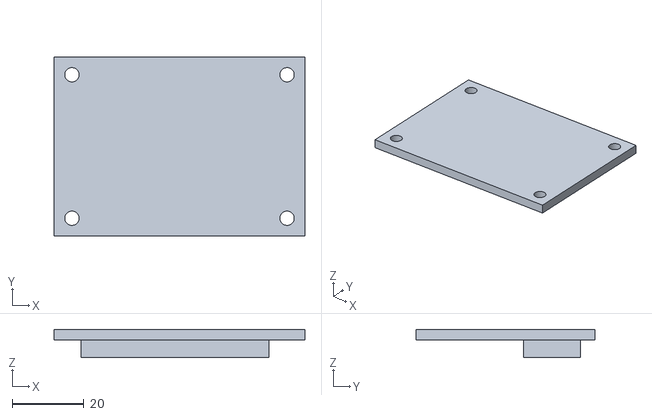
[picture p240: CAD file, 2019-06-03]
SolidWorks/Sensor Unit Complete/Sensor Unit - Board-1.STL
70.0 x 50.0 x 7.83
