Kalana304/CEM_Design_Files/(list of files, cad)

Other CAD files:
SolidWorks/LED light/led2.SLDPRT
SolidWorks/Sensor Unit Complete/Board.sldprt
Display Unit/Battery Cover.sldprt
Display Unit/Part3.sldprt
Display Unit/Bottom.sldprt
Display Unit/LCD.sldprt
SolidWorks/Sensor Unit Complete/Sensor Unit - Bottom-1.STL
SolidWorks/Sensor Unit Complete/Sensor Unit - Battery Cover-1.STL
SolidWorks/Display Unit/Battery Cover.sldprt
SolidWorks/Display Unit/Bottom.sldprt
SolidWorks/Display Unit/Top.SLDPRT
SolidWorks/LED light/Number 8 screw/No 8 Pan Head Screw.SLDPRT
SolidWorks/LED light/Number 8 screw/universal screw.SLDPRT
SolidWorks/LED light/Tempsensor/DHT11.IGS
SolidWorks/LED light/Tempsensor/DHT11.SLDPRT
