Kalana304/CEM_Design_Files/Reports/TestPoints.xlsx

 |  |  |  | Test point (Test Outputs)
 | Test Report for Display Unit |  |  |  |  | Test Report for Sensor Unit
Testpoints on the Top Side |  |  |  |  | Testpoints on the Top Side
Testpoint | Delivered Input (V) | Expected Output(V) |  |  | Tespoint | Delivered Input (V) | Expected Output (V)
N00391 | 4.65±7.5% | 4±0.5%
N00588 | 4.65±7.5% | 4±0.5%
N01074 | 4.65±7.5% | 4±0.5%
N01110 | 4.65±7.5% | 4±0.5%
N01146 | 4.65±7.5% | 4±0.5%
N01180 | 4.65±7.5% | 4.65±7.5%
N01995 | 4.65±7.5% | 4.65±7.5%
N02035 | 4.65±7.5% | 4.65±7.5%
N02075 | 4.65±7.5% | 4.65±7.5%
N02113 | 4.65±7.5% | 4.65±7.5%
N02151 | 4.65±7.5% | 4.65±7.5%
N02192 | 4.65±7.5% | 4.65±7.5%
N02230 | 4.65±7.5% | 4.65±7.5%
N03383 | 4.65±7.5% | 4.65±7.5%
N03418 | 4.65±7.5% | 4.65±7.5%
N06708 | 4.65±7.5% | 4±0.5%
GND | 0 | 0
Nets on The Bottom Side |  |  |  |  | Testpoints on the Bottom Side
Testpoint | Input (V) | Expected Output(V) |  |  | Testpoint | Input (V) | Expected Output(V)
GND | 0 | 0 |  |  | NO6072 | 4.65±7.5% | 4.65±7%
N00686 | 4.65±7.5% | 4.65±7.5% |  |  | NO6064 | 4.65±7.5% | 4.65±7.5%
 |  |  |  |  | NO5812 | 4.65±7.5% | 4.65±7.5%
 | Test Report for Power |  |  |  |  | Test Report for Power
Voltage Supplied by the Battery |  |  | 8±15% |  | Voltage Supplied by the Battery |  |  | 8±15%
Regulated Voltage |  |  | 4.65±7.5% |  | Regulated Voltage |  |  | 4.65±7.5%
Expected Current out from Regulator |  |  | 1A |  | Expected Current out from Regulator |  |  | 3A
