Kalana304/CEM_Design_Files/Reports/Circuit Information/cct diagram Display unit.pdf

# J1HEADER 2

# Receiver RE

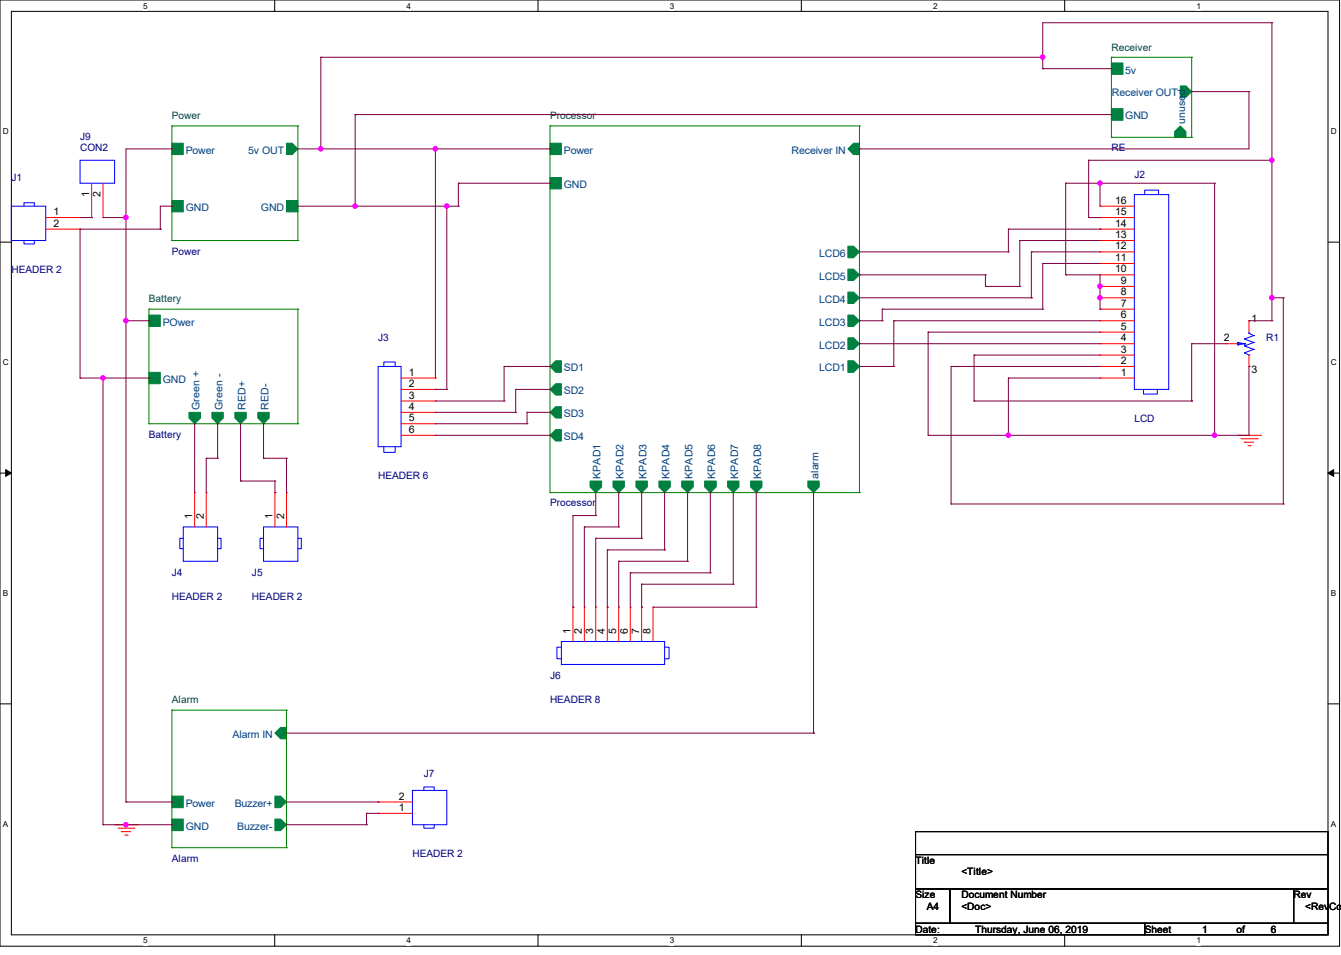
[picture p281: page 1]
A Title Size; Document Number; Rev Date:; Sheet; of <Doc>; <RevCode>; <Title> A4; Thursday, June 06, 2019; 6 Title Size; GND; 5v OUT; Alarm; Power; Buzzer-; Buzzer+; Alarm IN; J4HEADER 2; 2 Battery; Battery Green +; Green ⁻; RED⁺; RED-; POwer; Processor; Receiver IN; LCD1; LCD2; LCD3; LCD4; LCD5; LCD6 KPAD¹; KPAD²; KPAD³; KPAD⁴; KPAD⁵; KPAD⁶; KPAD⁷; KPAD⁸; alarm; J5HEADER 2; J3HEADER 6; J7 HEADER 2; 5vGND; J6HEADER 8; LCD

Receiver OUT unused

2 Power Power Power
J9CON2

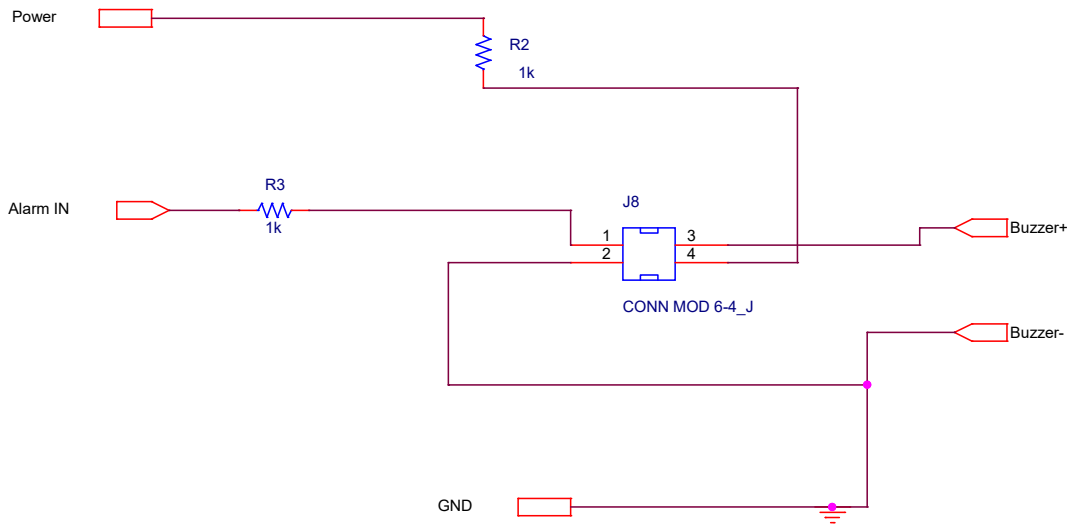
[picture p282: page 2]
GND; Power; Buzzer-; Buzzer+; Alarm IN; Title; Size; Document Number; Rev; Date:; Sheet; <Doc>; <RevCode>; <Title>; Thursday, June 06, 2019; CONN MOD 6-4_J

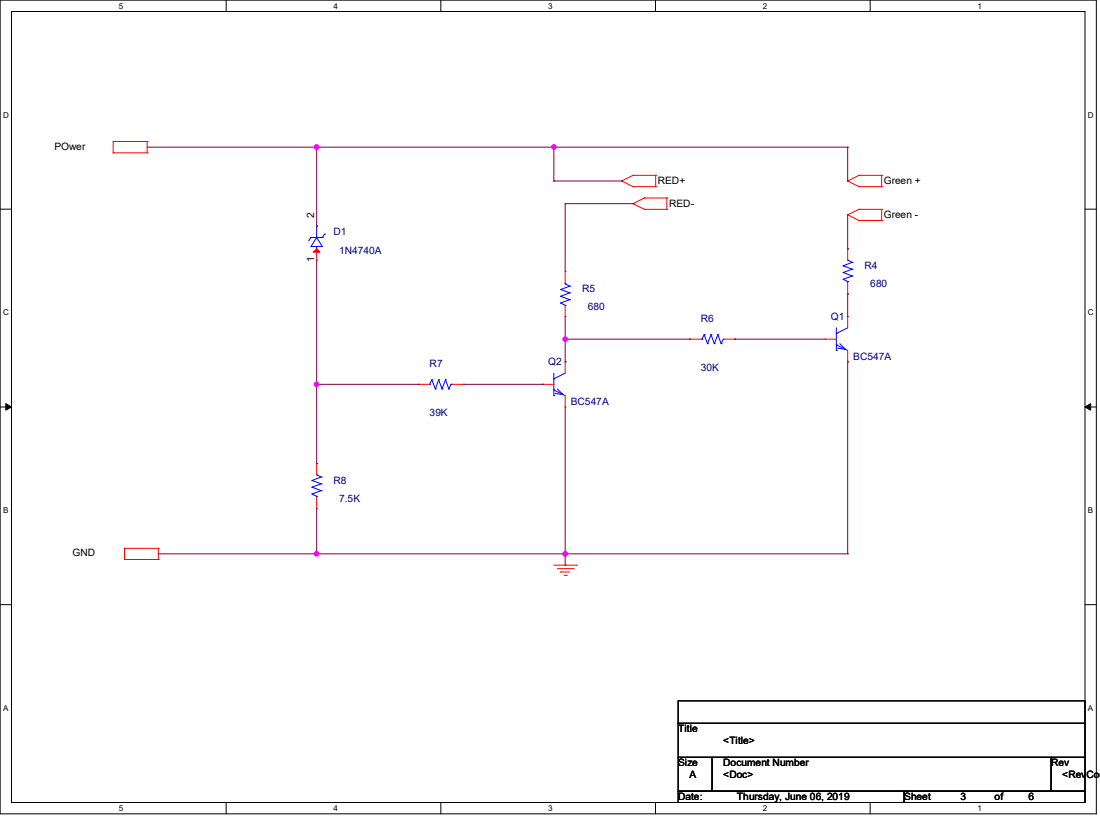
[picture p283: page 3]

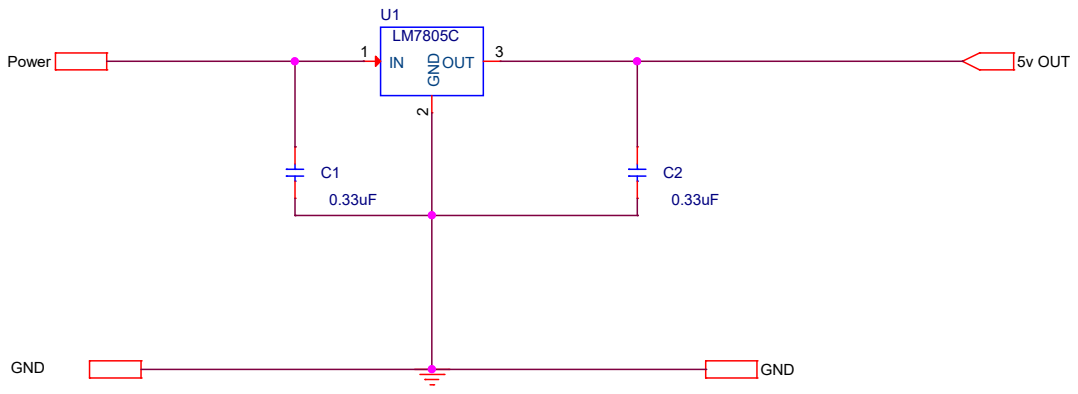
[picture p284: page 4]
Power; GND; 5v OUT; Title; Size; Document Number; Rev; <Doc>; <RevCode>; <Title>; Thursday, June 06, 2019; 2 OUT 3

# LCD6 KPAD1 KPAD3 KPAD4 KPAD5 KPAD6 KPAD7 KPAD8

# SW1 SW_PB_SPST R9

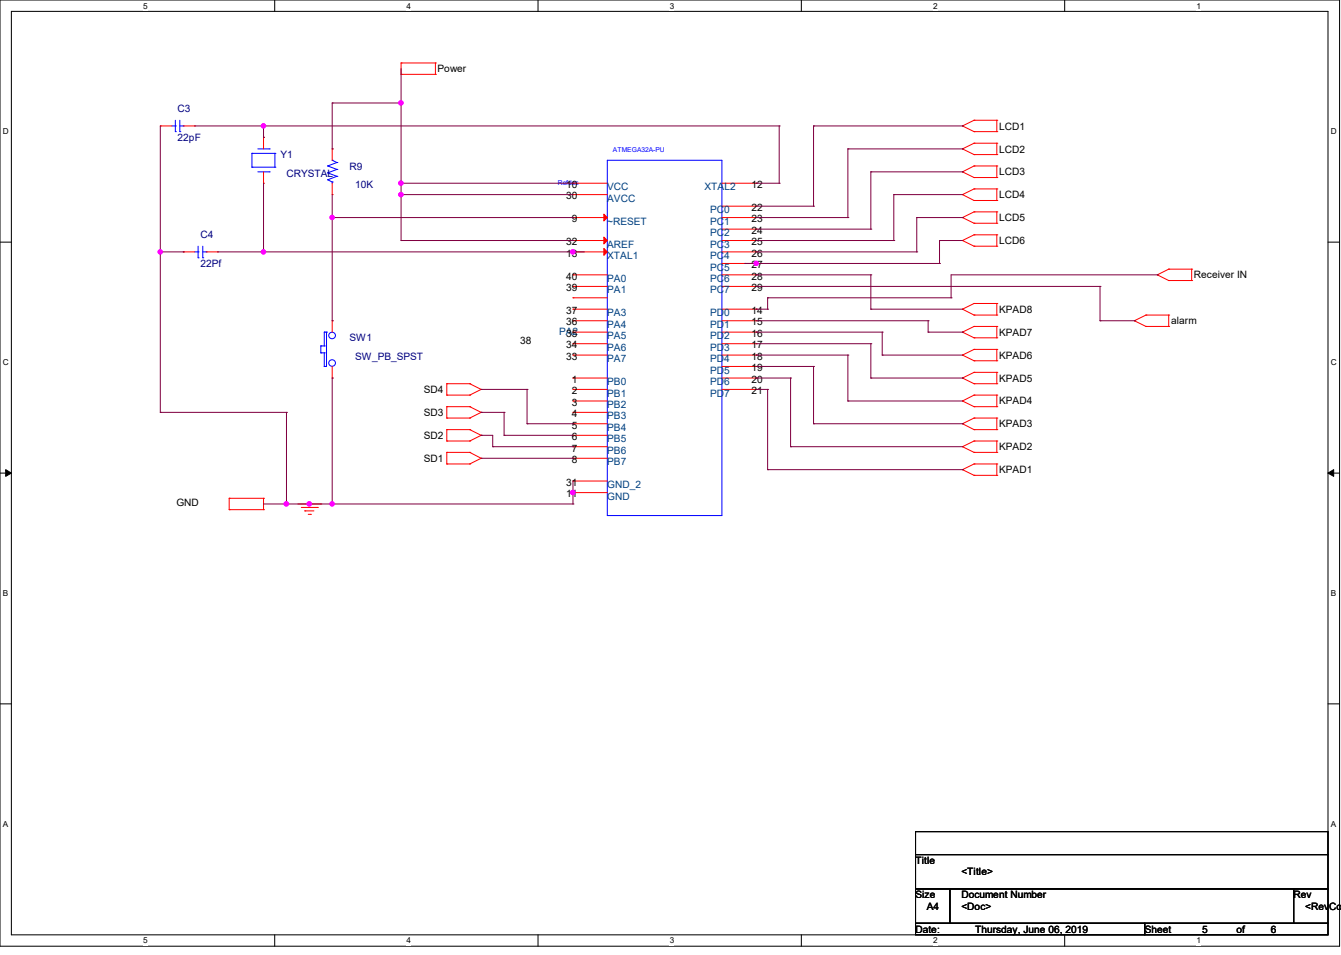
[picture p285: page 5]
Power; GND; Receiver IN; LCD1; LCD2; LCD3; LCD4; LCD5; alarm; KPAD2; Title Size; Document Number; Rev Date:; Sheet; of <Doc>; <RevCode>; <Title> A4; Thursday, June 06, 2019; 6 Title Size; Y1CRYSTAL; ATMEGA32A-PU; Refdes 32; AREF; 30 AVCC; 11 GND; 31 GND_2; 10 VCC; XTAL1; XTAL2; 9 ~RESET C4

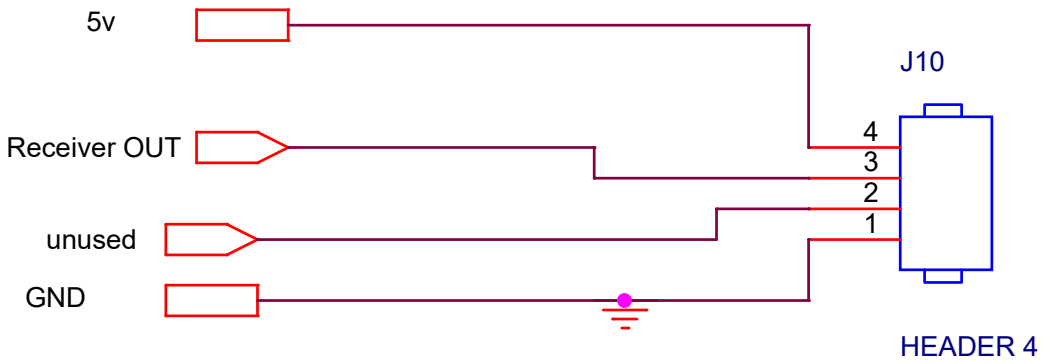
[picture p286: page 6]
GND; Receiver OUT; unused; Title; Size; Document Number; Rev; <Doc>; <RevCode>; <Title>; Thursday, June 06, 2019; HEADER 4
