Kalana304/CEM_Design_Files/Reports/Circuit Information/cct diagram Sensor schem.pdf

# power P1Power

# J4HEADER 4

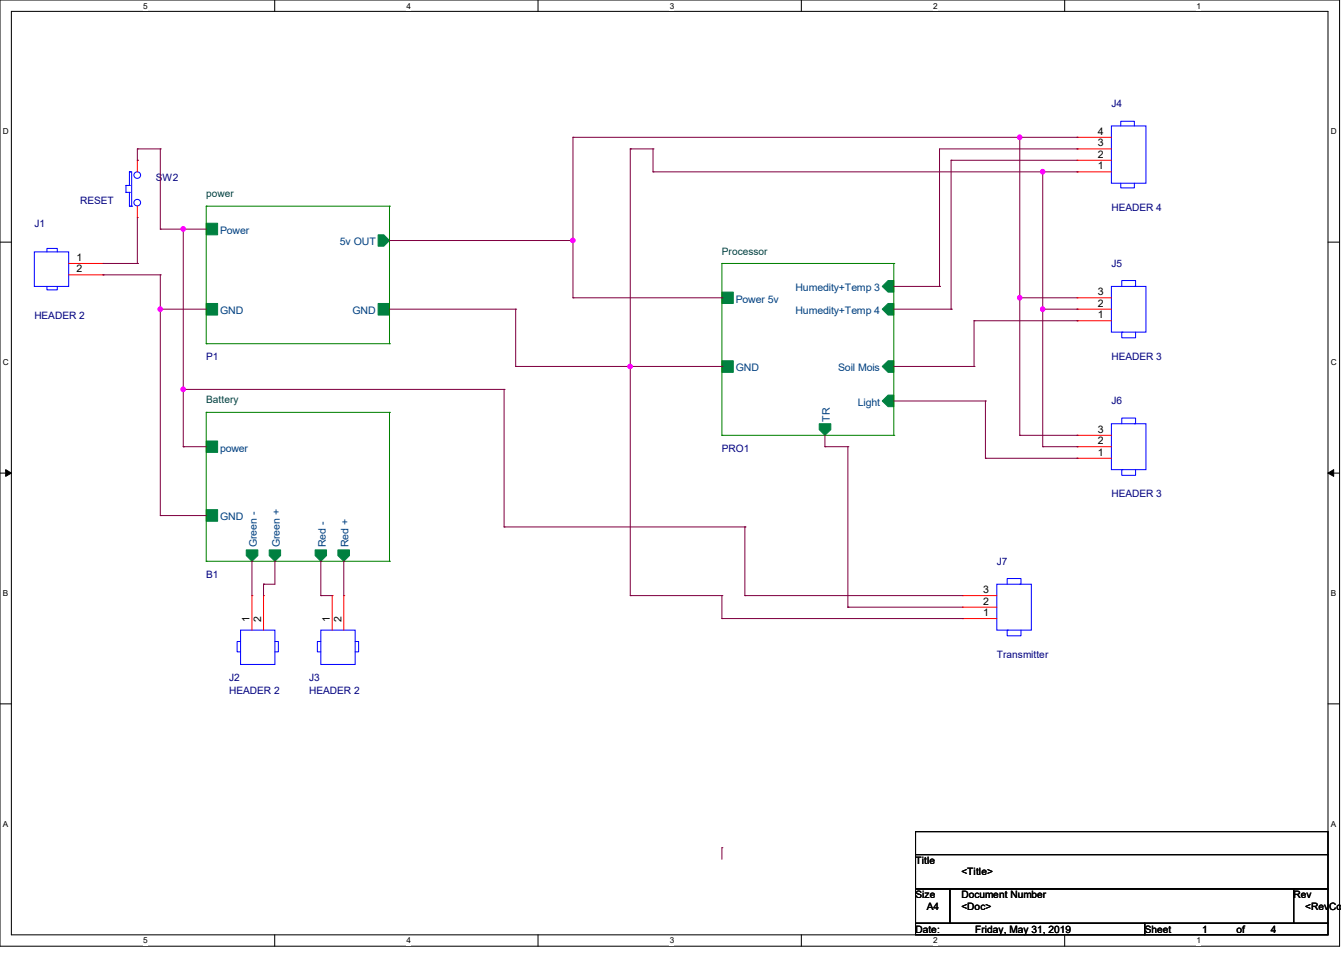
[picture p287: page 1]
A Title Size; Document Number; Rev Date:; Sheet; of <Doc>; <RevCode>; <Title> A4; Friday, May 31, 2019; 4 Title Size; J3HEADER 2; J6HEADER 3; J7Transmitter 1; GND; 5v OUT; 4 SW2 RESET; Processor PRO1; Power 5v; Humedity+Temp 3; Humedity+Temp 4; Soil Mois; Light; J1HEADER 2; J2HEADER 2; J5HEADER 3; Battery B1; power; GND Green ⁻; Green +; Red ⁻; Red +

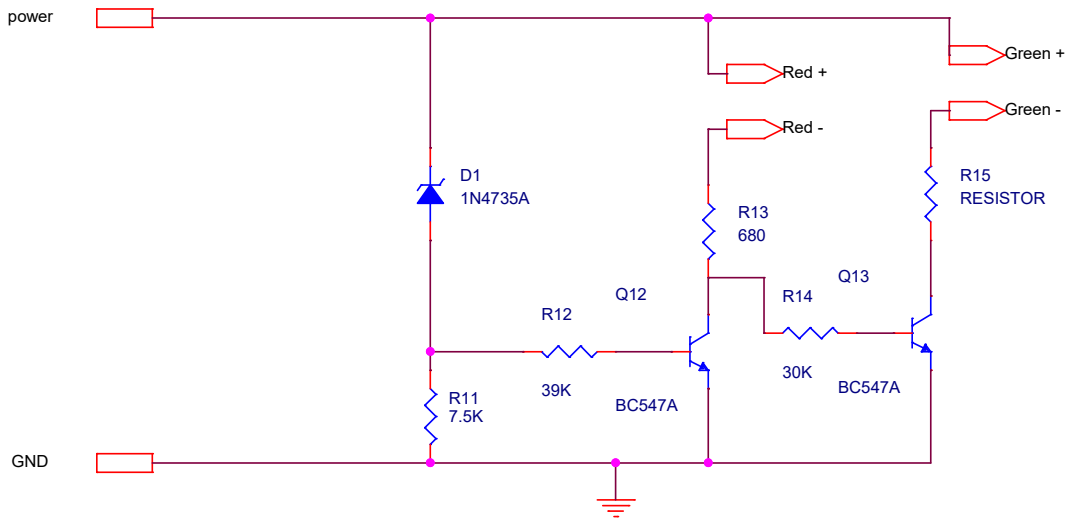
[picture p288: page 2]

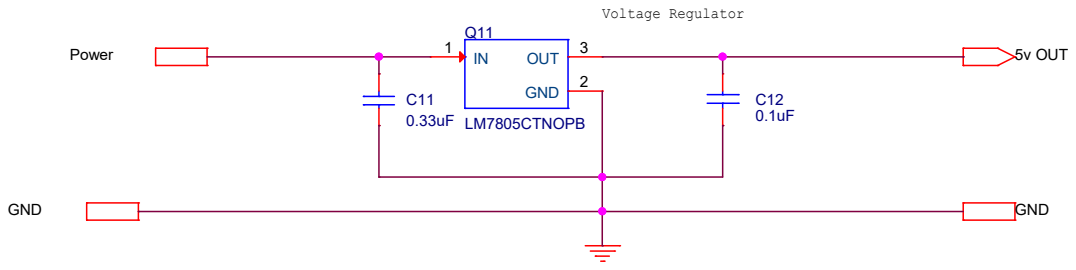
[picture p289: page 3]
Voltage Regulator; Power; GND; 5v OUT; Title; Size; Document Number; Rev; <Doc>; <RevCode>; <Title>; Tuesday, May 28, 2019; LM7805CTNOPB; OUT

# Refdes PB0 1

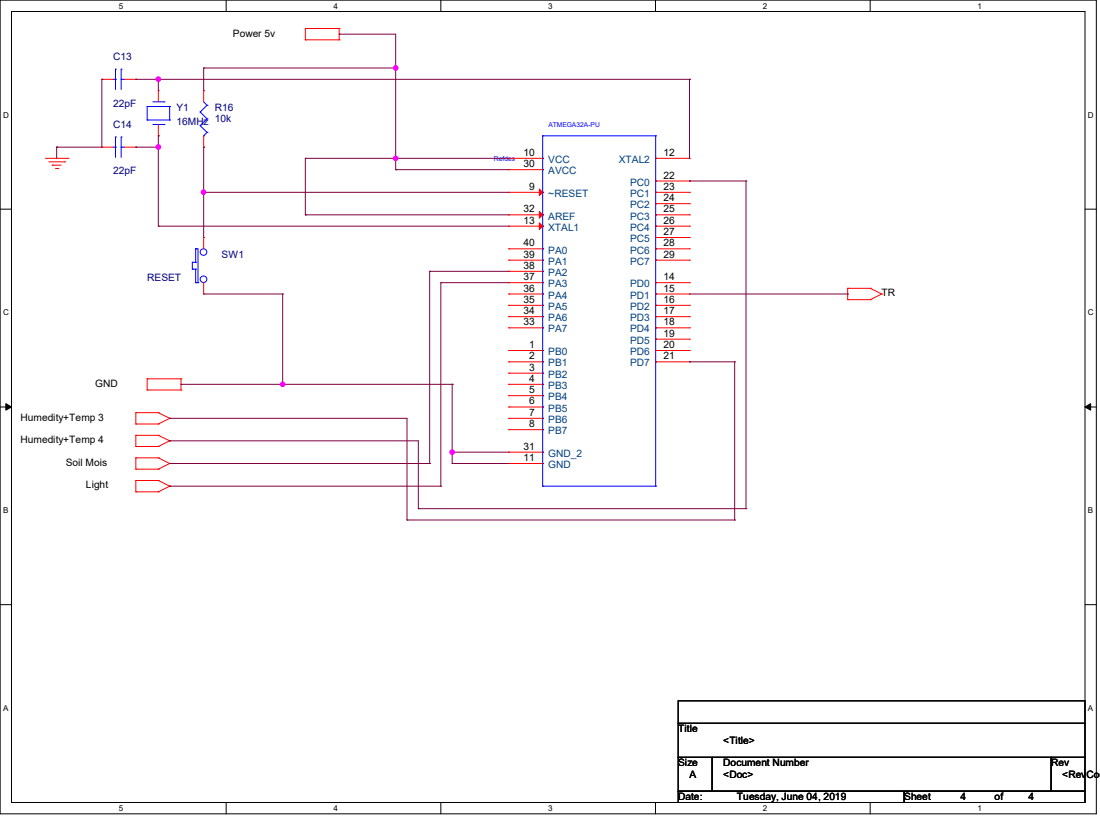
[picture p290: page 4]
Power 5v; GND; Humedity+Temp 3; Humedity+Temp 4; Soil Mois; Light; Title; Size; Document Number; Rev; <Doc>; <RevCode>; <Title>; Tuesday, June 04, 2019; RESET; ATMEGA32A-PU; ~RESET 9; VCC 10; GND 11; XTAL2; XTAL1 13; AVCC 30; GND_2 31; Y1 16MHz

AREF 32
PA7 33 PA6 34 PA5 35 PA4 36 PA3 37 PA2 38 PA1 39 PA0 40
