Kalana304/CEM_Design_Files/ORCAD/PCB_Final/Try_2_Power_correct/schematic.pdf

# Receiver RE

# 5vGND

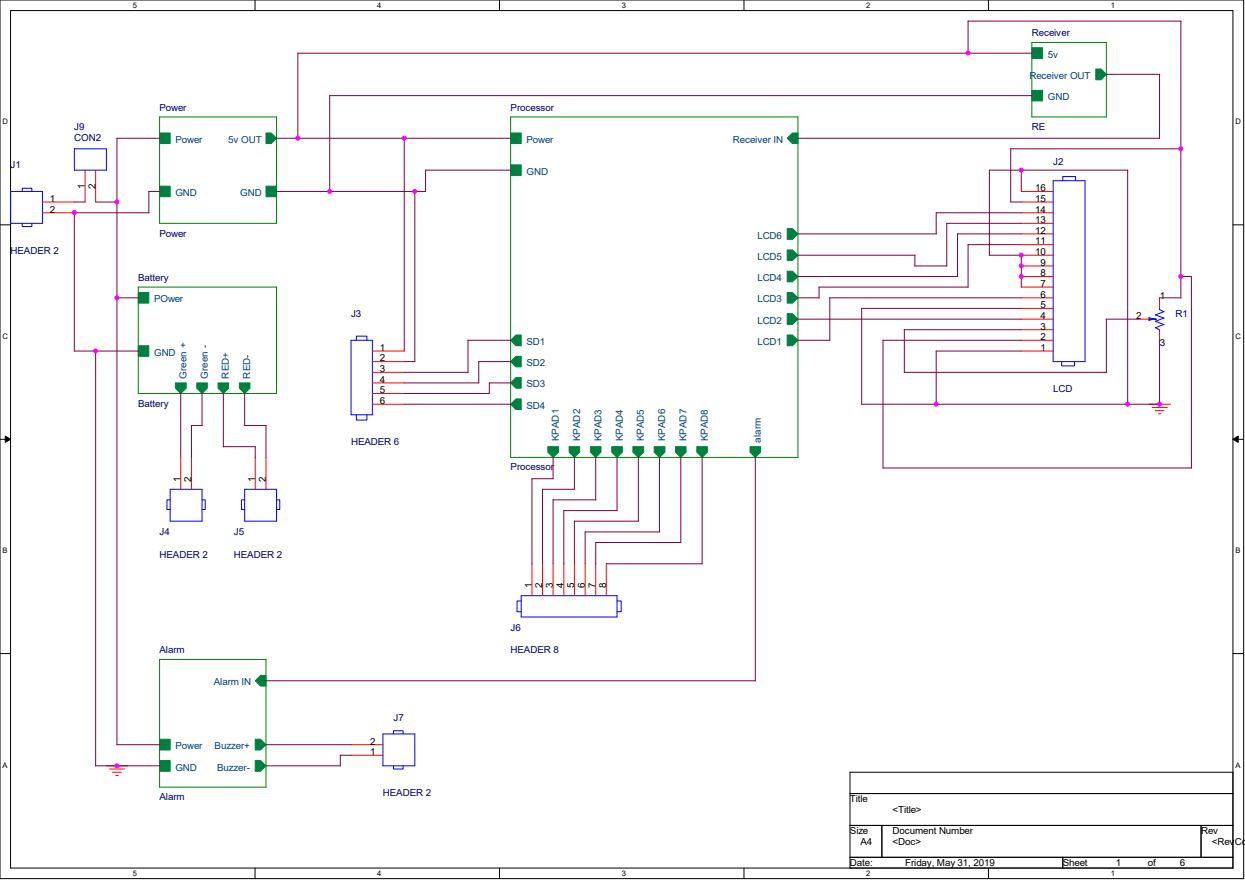
[picture p291: page 1]
A <Doc>; <RevCode>; Title; Power Power Power GND; GND; 5v OUT; Alarm; Power; Buzzer-; Buzzer+; Alarm IN; Battery; Battery Green +; Green ⁻; RED⁺; RED-; POwer GND; Processor; Power GND; Receiver IN; LCD1; LCD2; LCD3; LCD4; LCD5; LCD6 KPAD¹; KPAD²; KPAD³; KPAD⁴; KPAD⁵; KPAD⁶; KPAD⁷; KPAD⁸; alarm; Receiver OUT; J1HEADER 2; J4HEADER 2; J5HEADER 2; HEADER 6; J7 HEADER 2; J9 CON2; HEADER 8; LCD

13
12
11
10

Size | <Title> A4 Friday, May 31, 2019 1 6 Document Number | Rev

Date: | Sheet of

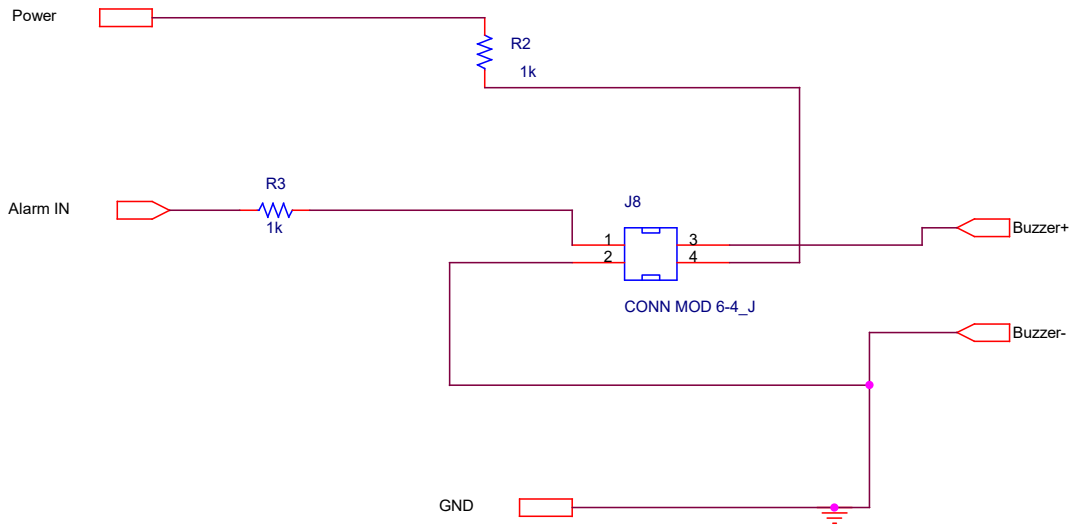
[picture p292: page 2]
A <Doc>; <RevCode>; <Title>; Title Size; Document Number; Rev; CONN MOD 6-4_J; GND; Power; Buzzer- Buzzer+; Alarm IN

Date: Wednesday, May 29, 2019 | Sheet 2 of 6

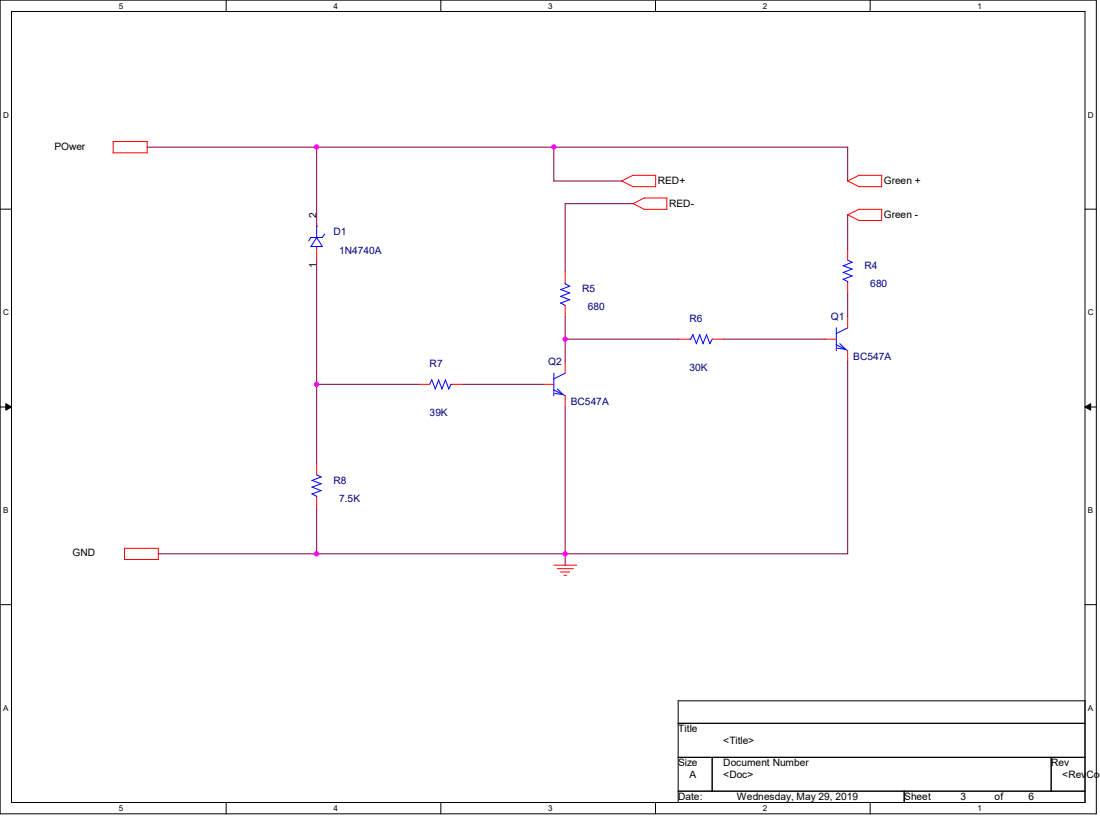
[picture p293: page 3]

Wednesday, May 29, 2019 | 3 6

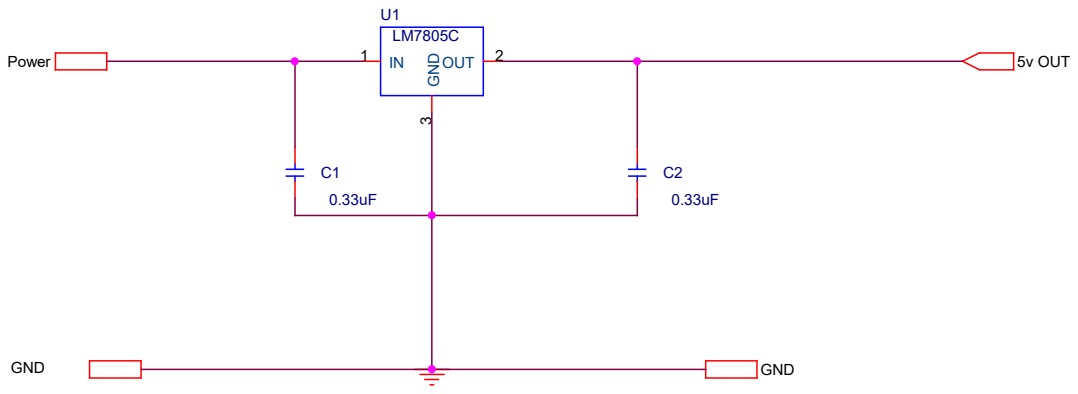
[picture p294: page 4]
A <Doc>; <RevCode>; <Title>; Title Size; Document Number; Rev; OUT GND; Power GND; GND; 5v OUT

Friday, May 31, 2019 | 4 6

# LCD6 KPAD1 KPAD3 KPAD4 KPAD5

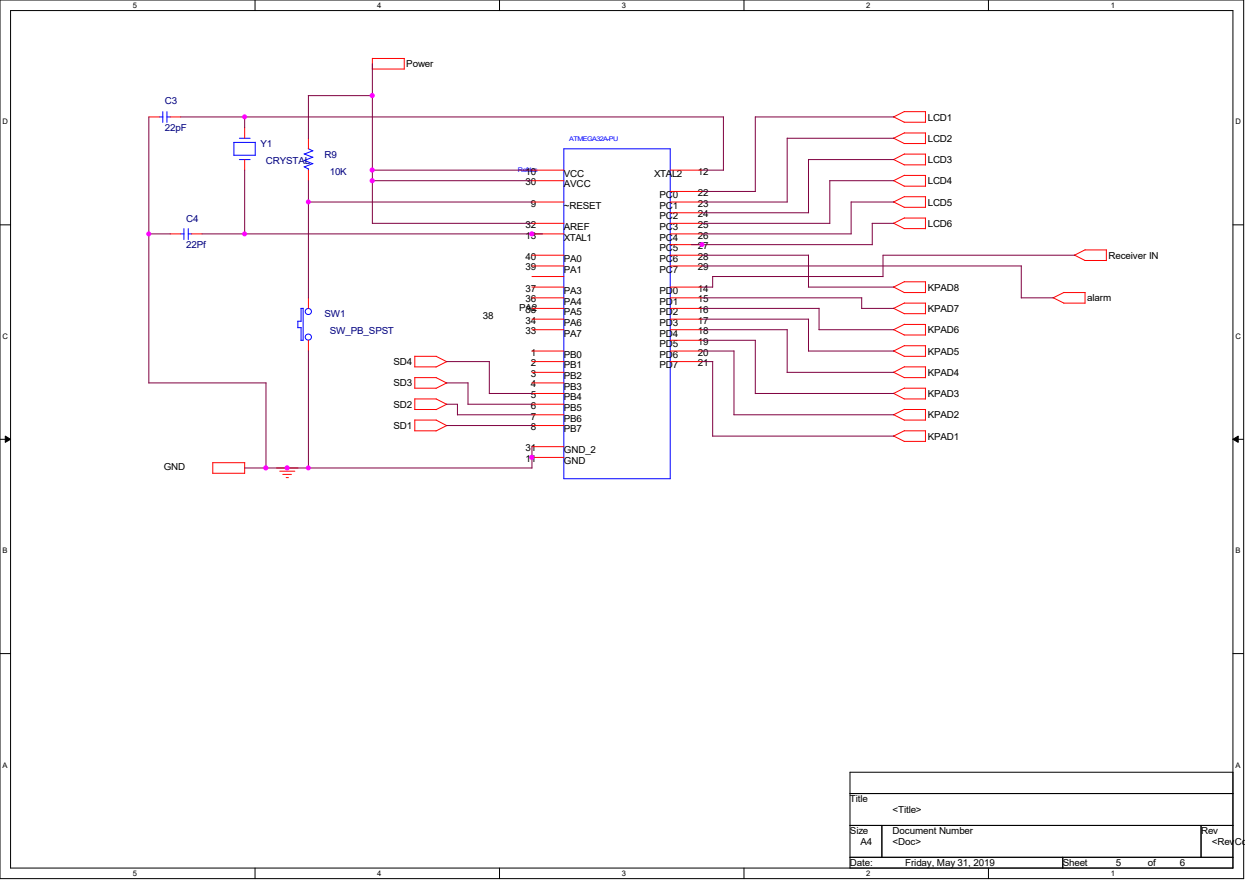
[picture p295: page 5]
A <Doc>; <RevCode>; Title; SW_PB_SPST; Y1CRYSTAL; ATMEGA32A-PU; Refdes 32; AREF; 30 AVCC; 11 GND; 31 GND_2; 10 VCC; XTAL1; XTAL2; 9 ~RESET C4; Power; GND; Receiver IN; LCD1; LCD2; LCD3; LCD4; LCD5; KPAD6 KPAD7 KPAD8; alarm; KPAD2

Size | <Title> A4 Friday, May 31, 2019 5 6 Document Number | Rev

Date: | Sheet of

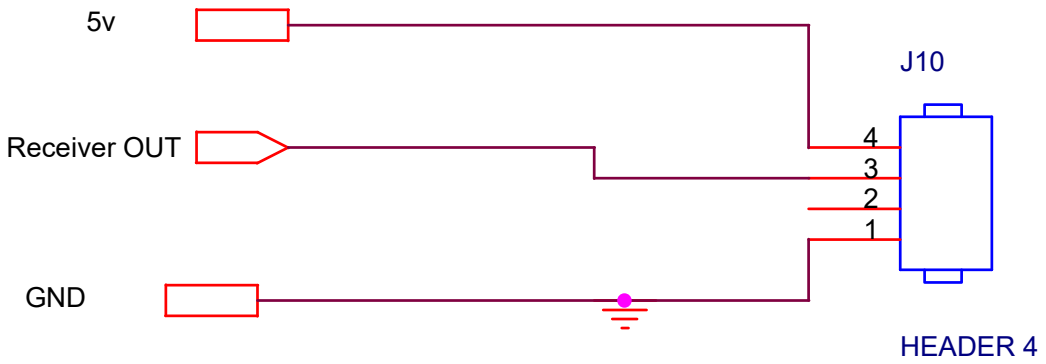
[picture p296: page 6]
A <Doc>; <RevCode>; <Title>; Title Size; Document Number; Rev; HEADER 4; GND; Receiver OUT

Wednesday, May 29, 2019 | 6 6
