Kalana304/CEM_Design_Files/Reports/Circuit Information/bot_display unit.pdf

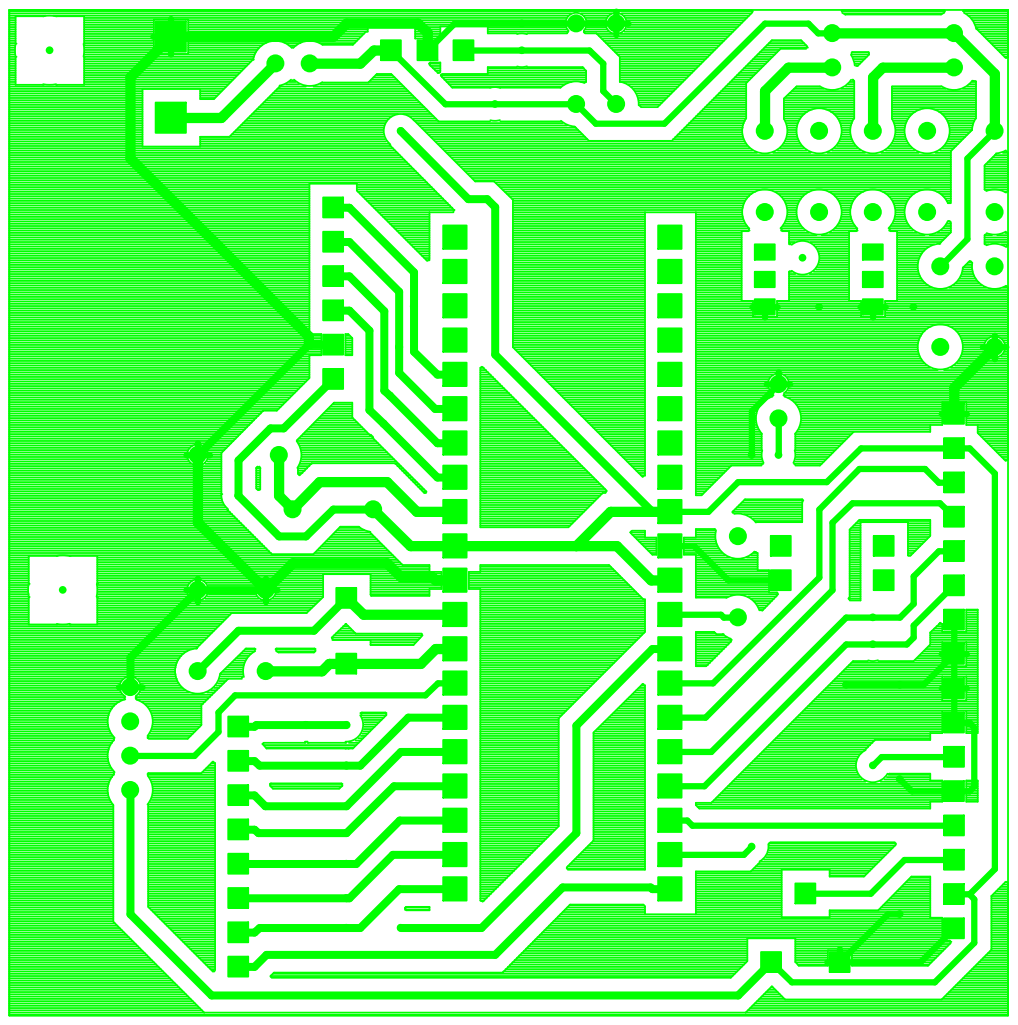
[picture p297: page 1]
