Kalana304/CEM_Design_Files/Reports/Circuit Information/Bottom_sensor unit.pdf

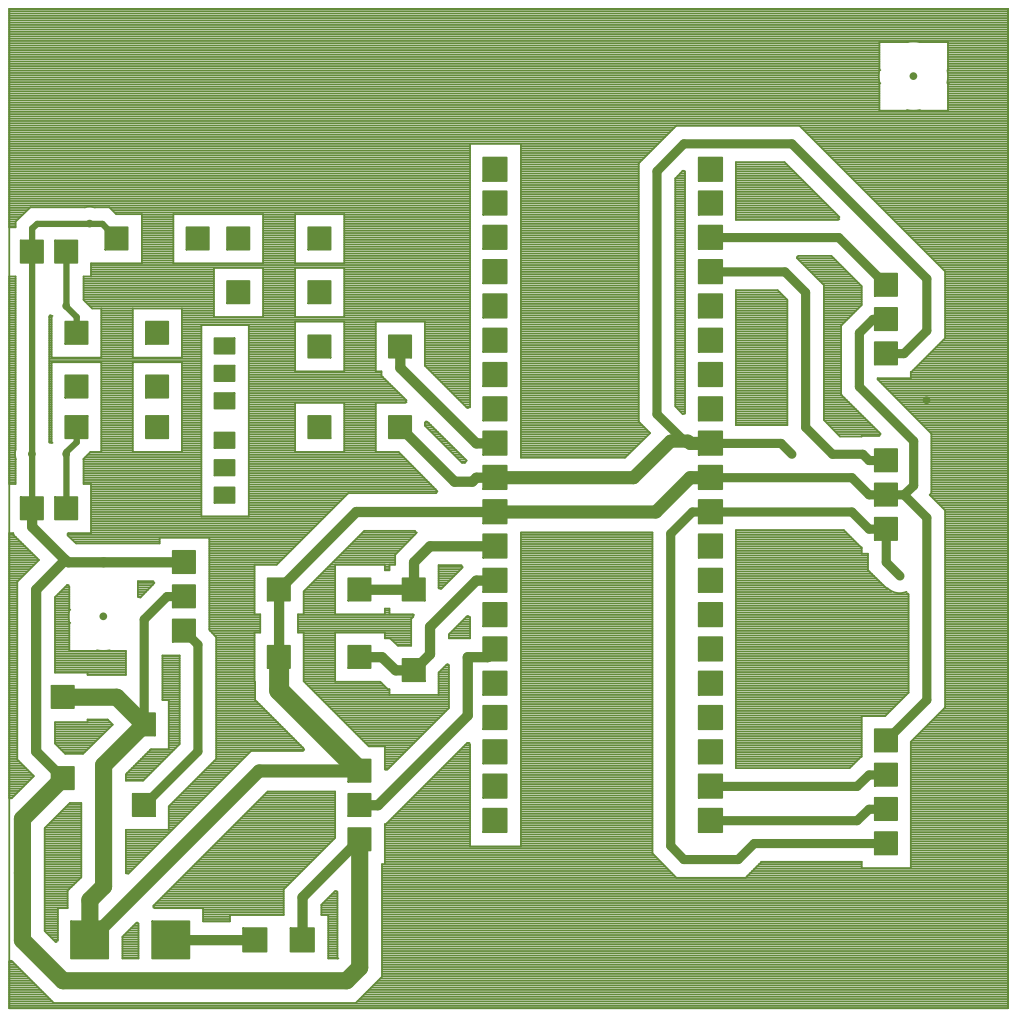
[picture p298: page 1]
