Kalana304/CEM_Design_Files/Reports/Circuit Information/silkscreeen Top_display unit.pdf

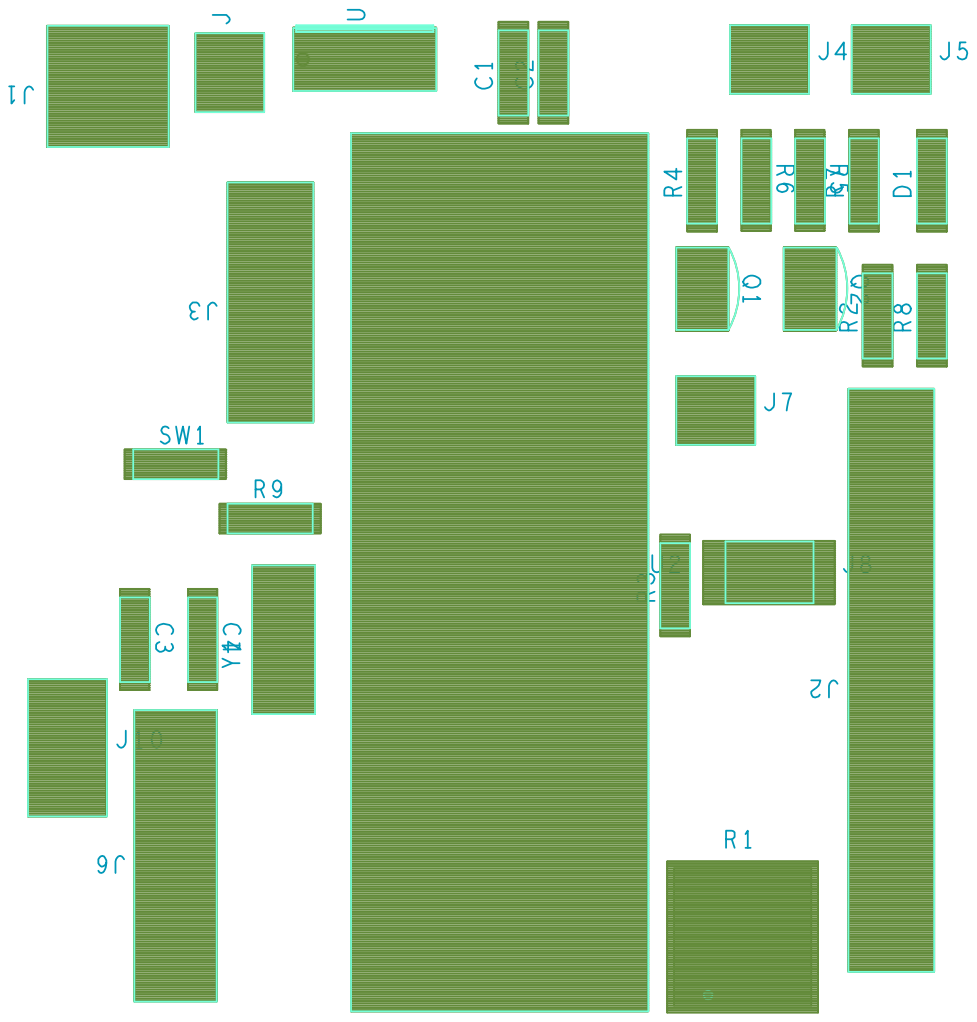
[picture p299: page 1]
