Kalana304/CEM_Design_Files/Reports/Circuit Information/silkscreen Top_sensor unit.pdf

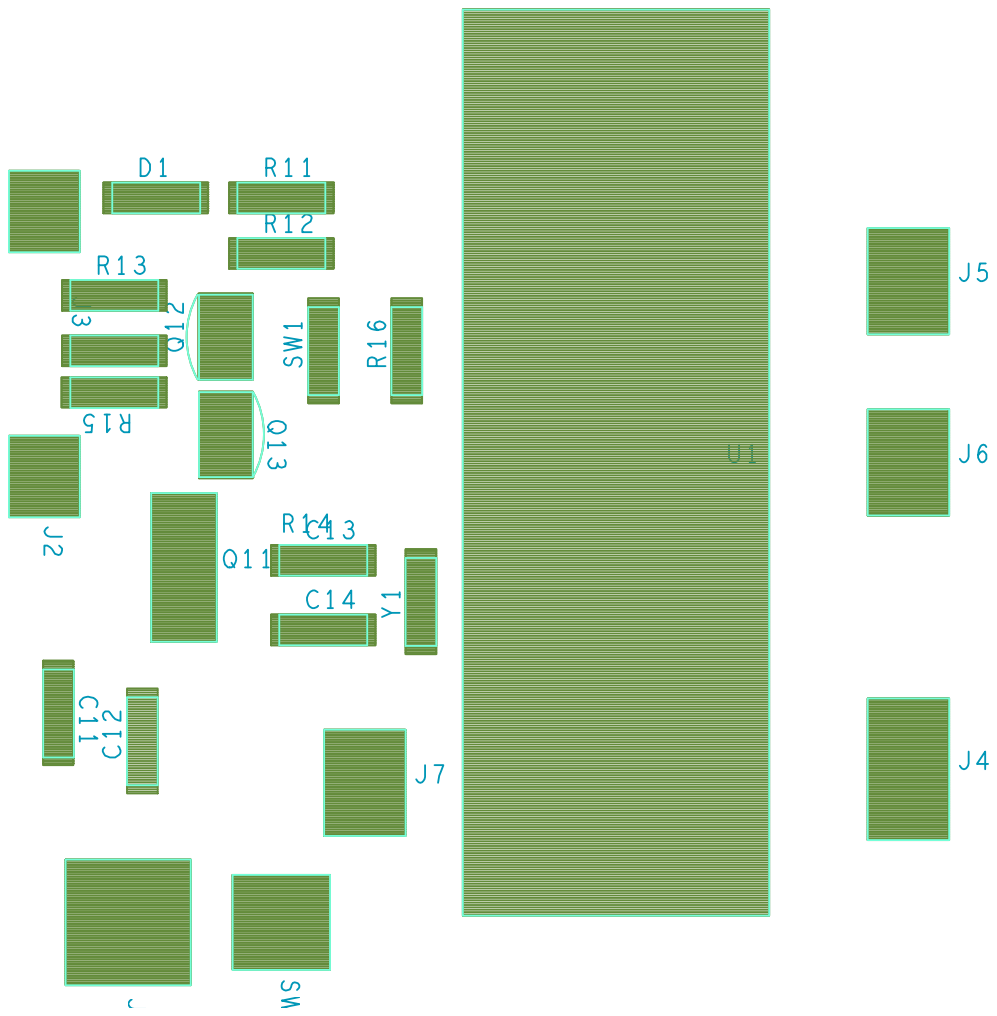
[picture p300: page 1]
