Kalana304/CEM_Design_Files/Reports/Circuit Information/Top_displayunit.pdf

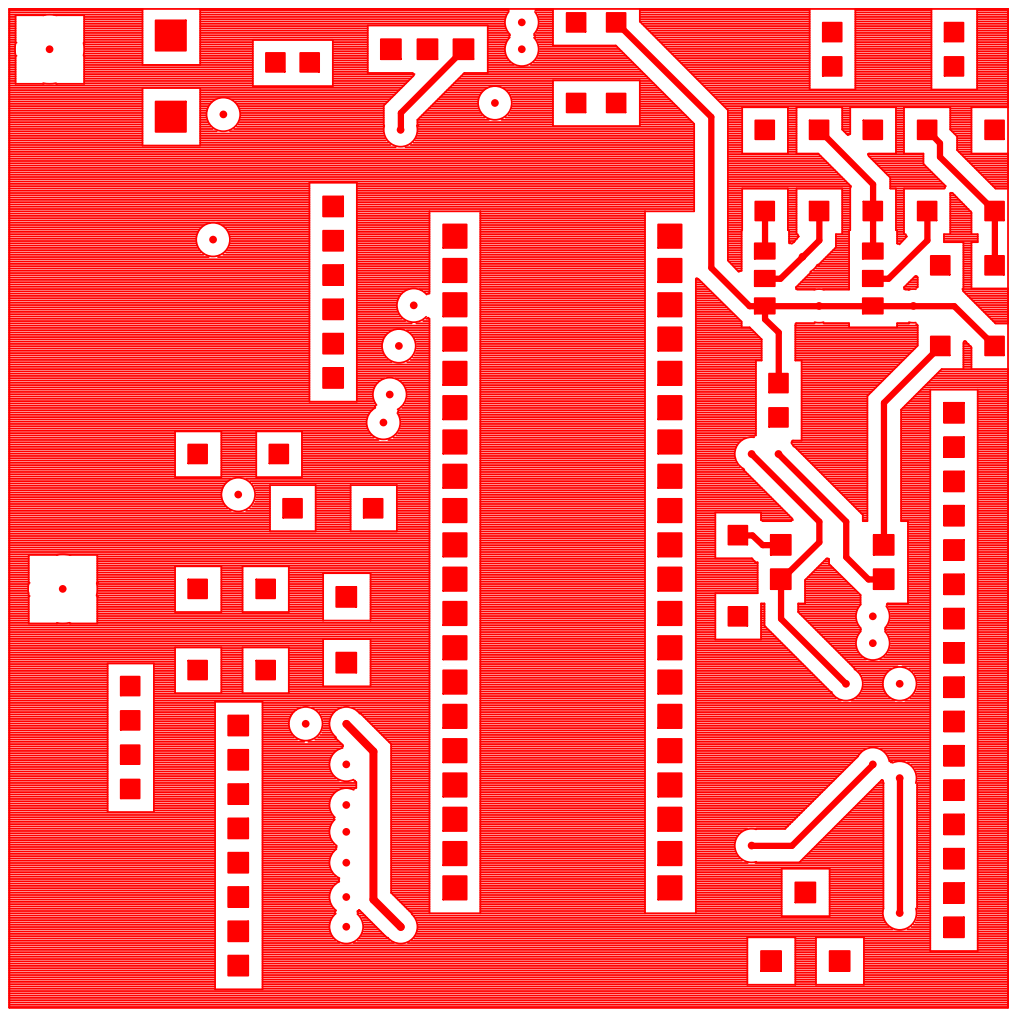
[picture p301: page 1]
