Kalana304/CEM_Design_Files/Reports/Circuit Information/Top_sensorunit.pdf

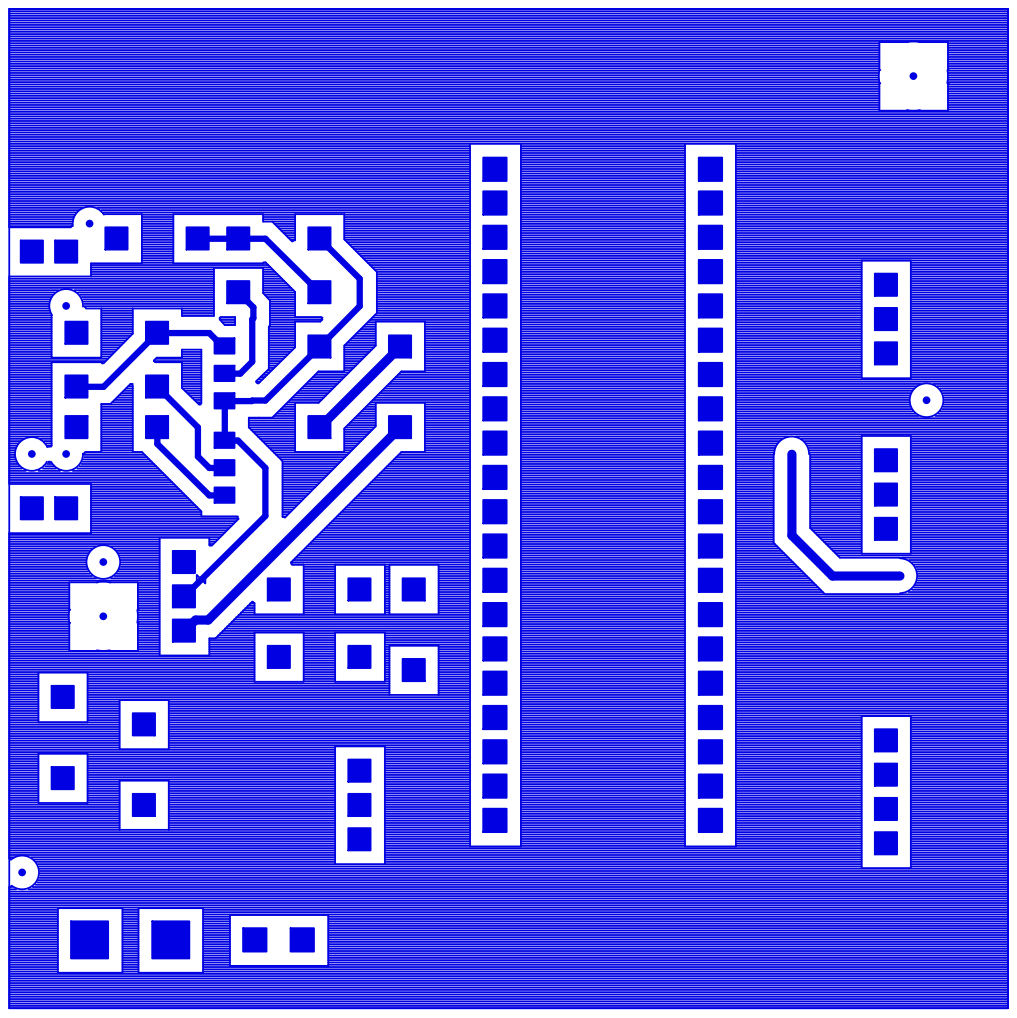
[picture p302: page 1]
