Kalana304/CEM_Design_Files/ORCAD/PCB_Final/test_1.pdf

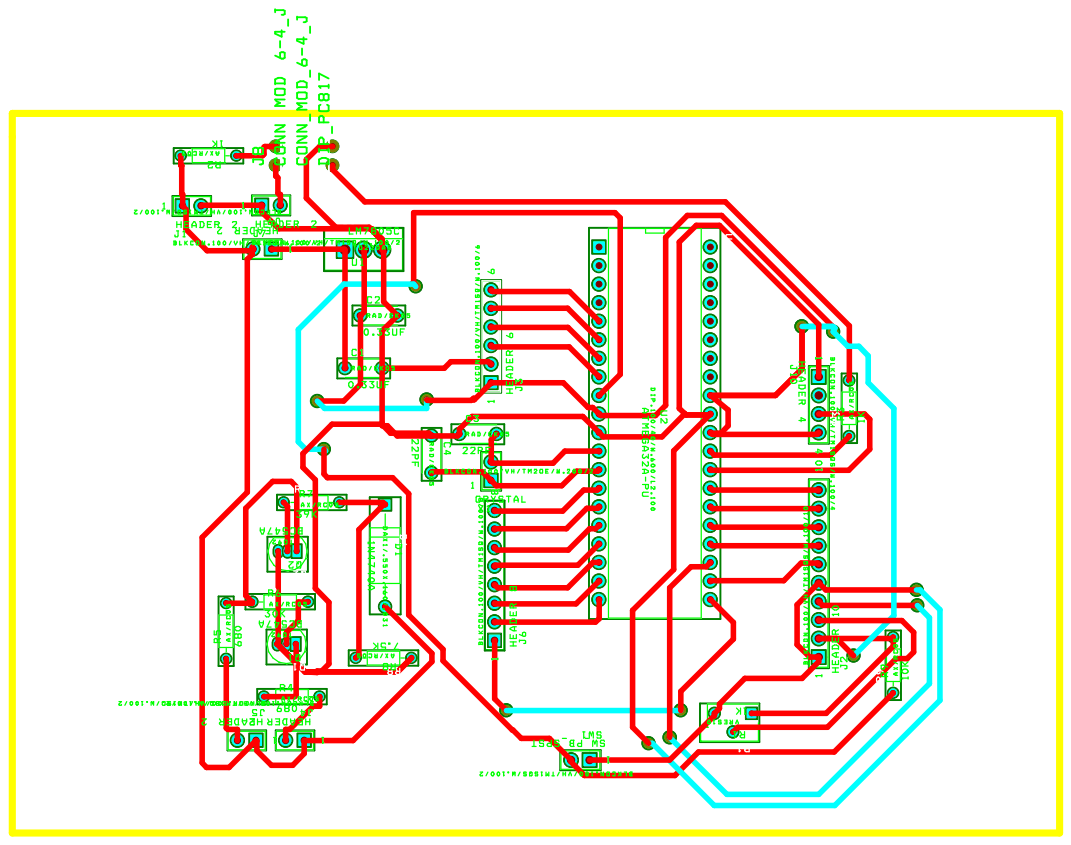
[picture p303: page 1]
