Kalana304/CEM_Design_Files/Reports/Circuit Information/WIP/DisCct1.pdf

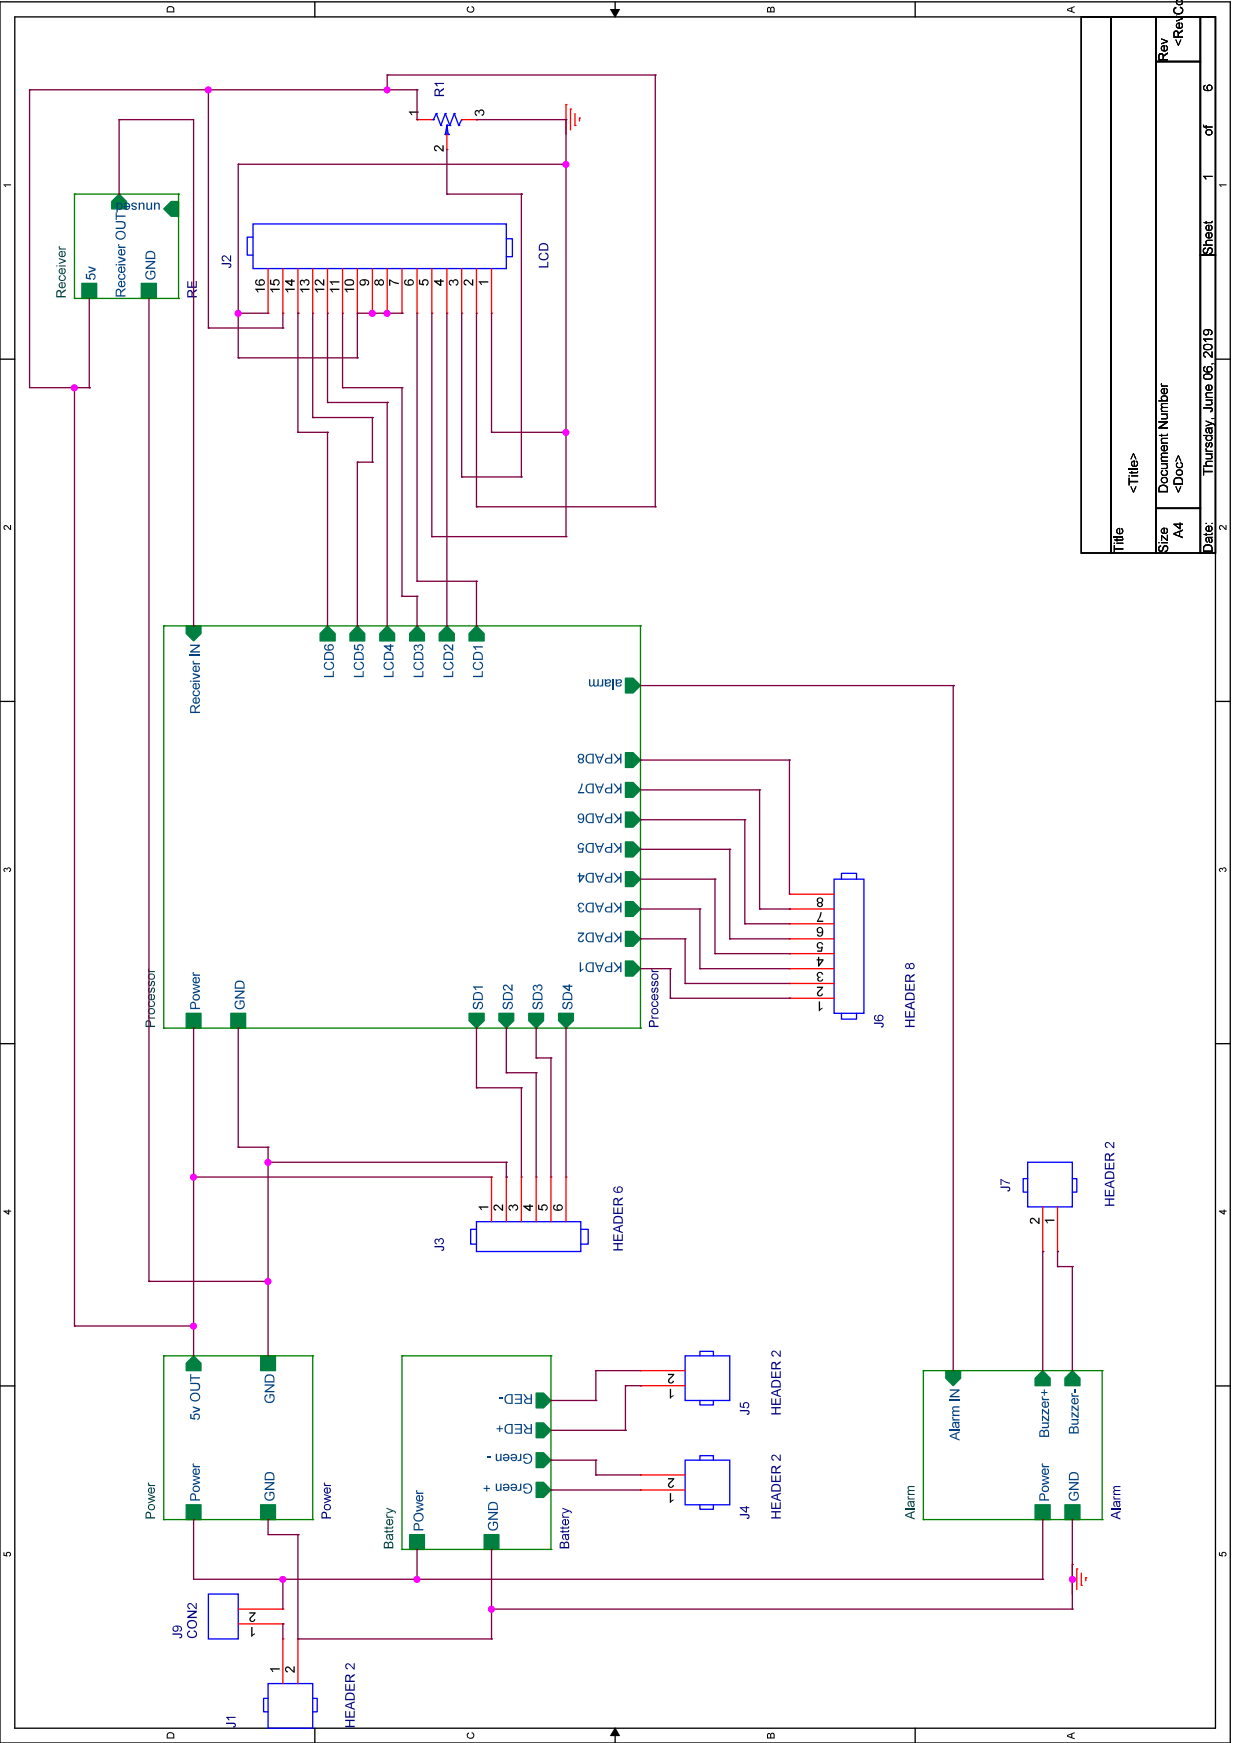
[picture p304: page 1]
