Kalana304/CEM_Design_Files/Reports/Circuit Information/WIP/DisCct2.pdf

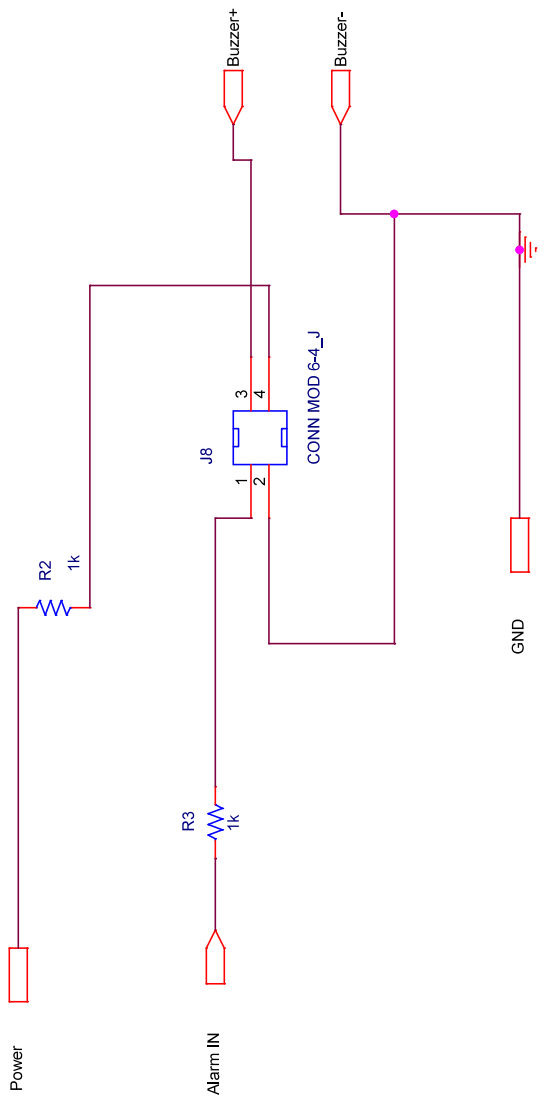
[picture p305: page 1]
