Kalana304/CEM_Design_Files/Reports/Circuit Information/WIP/DisCct3.pdf

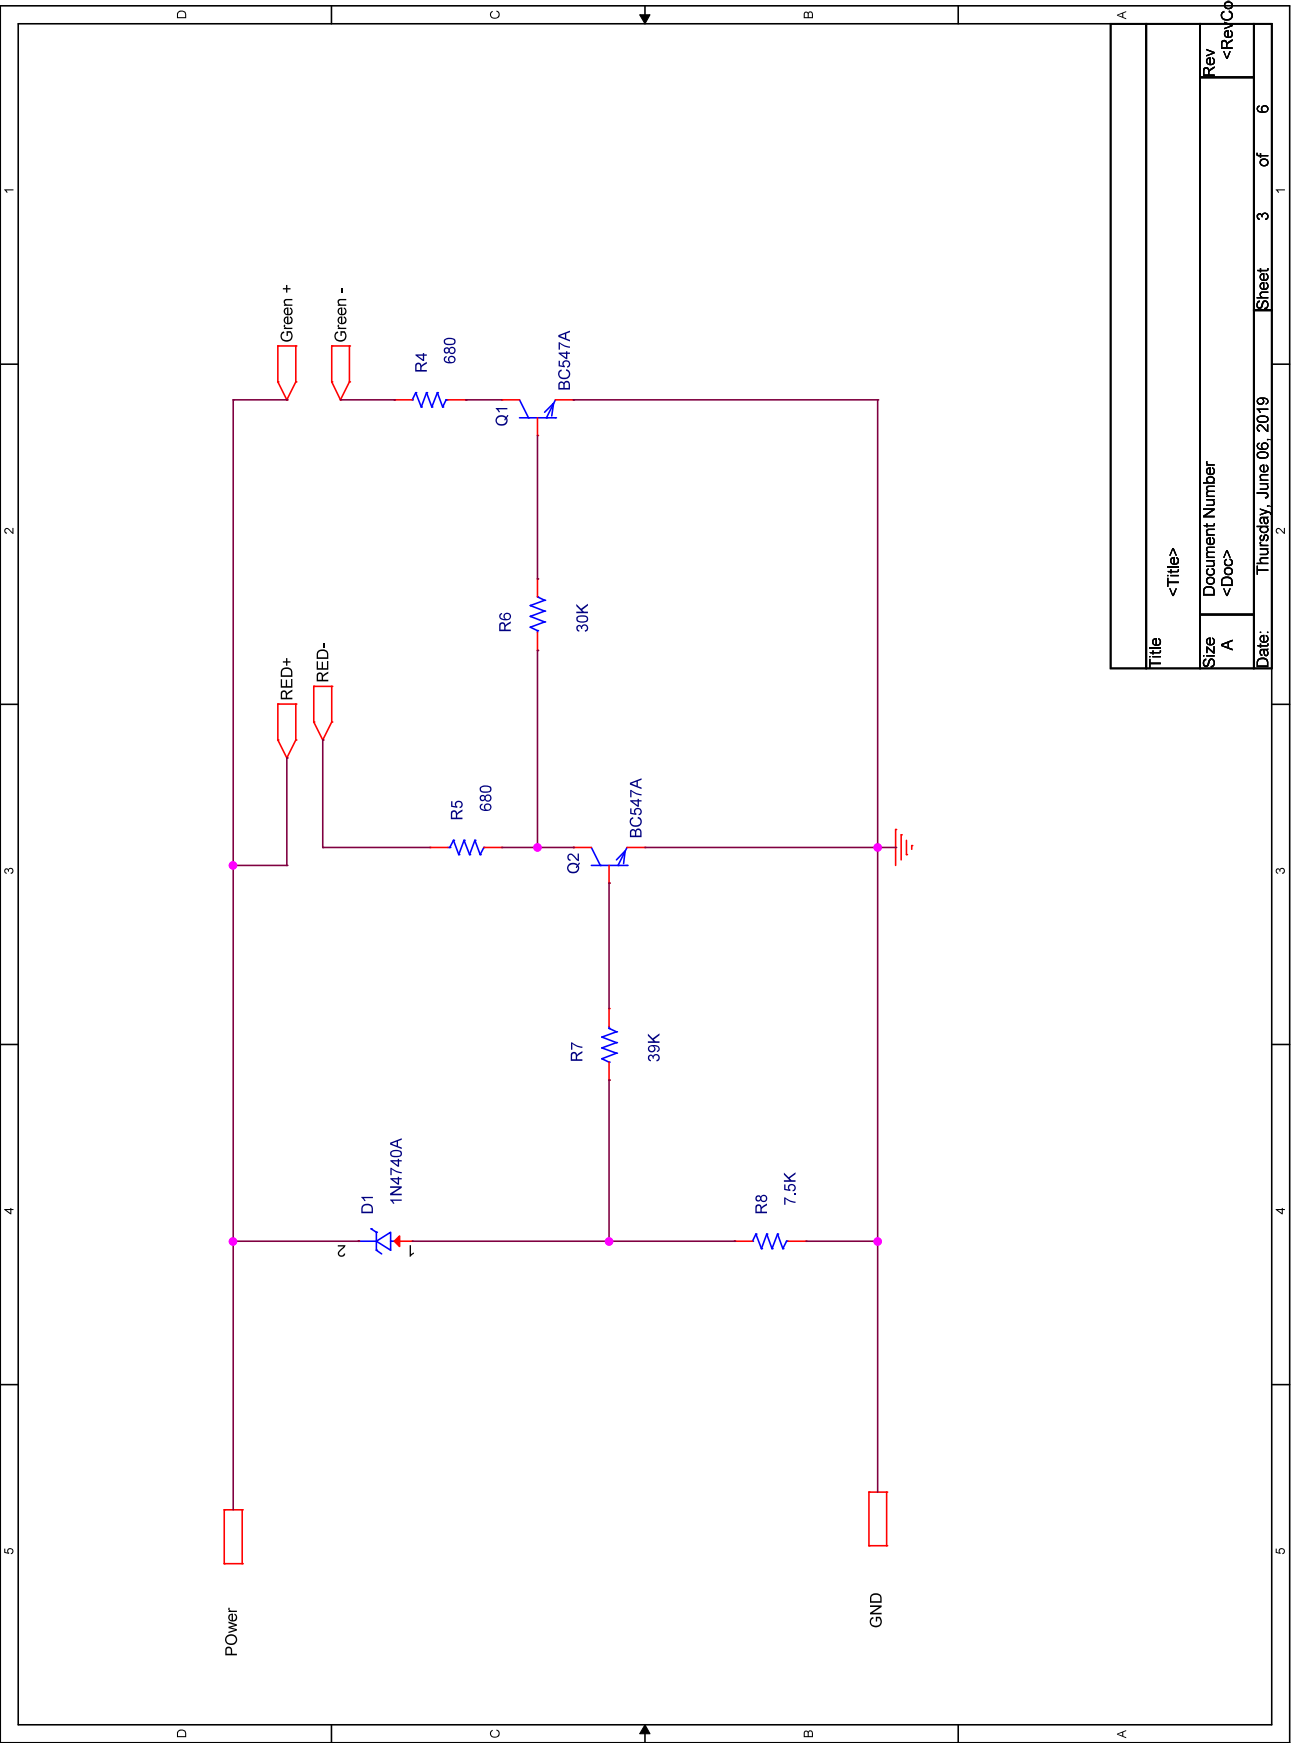
[picture p306: page 1]
