Kalana304/CEM_Design_Files/Reports/Circuit Information/WIP/DisCct4.pdf

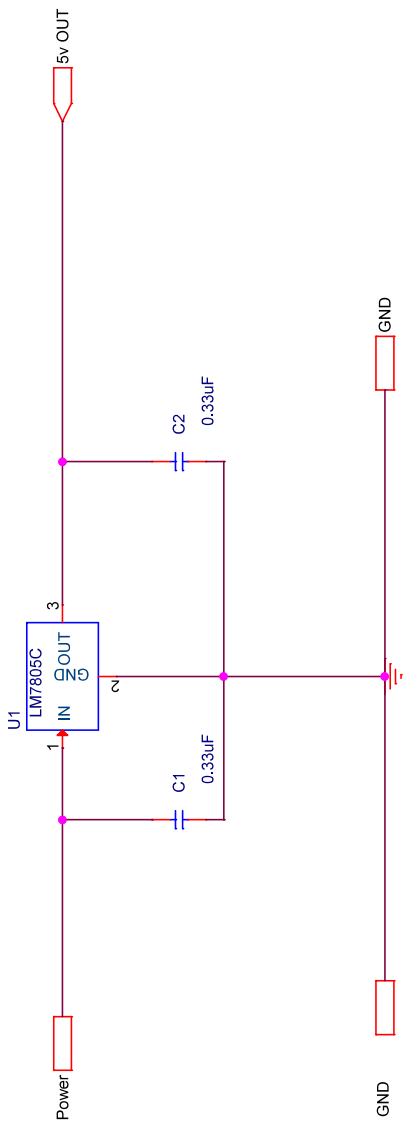
[picture p307: page 1]
