Kalana304/CEM_Design_Files/Reports/Circuit Information/WIP/DisCct5.pdf

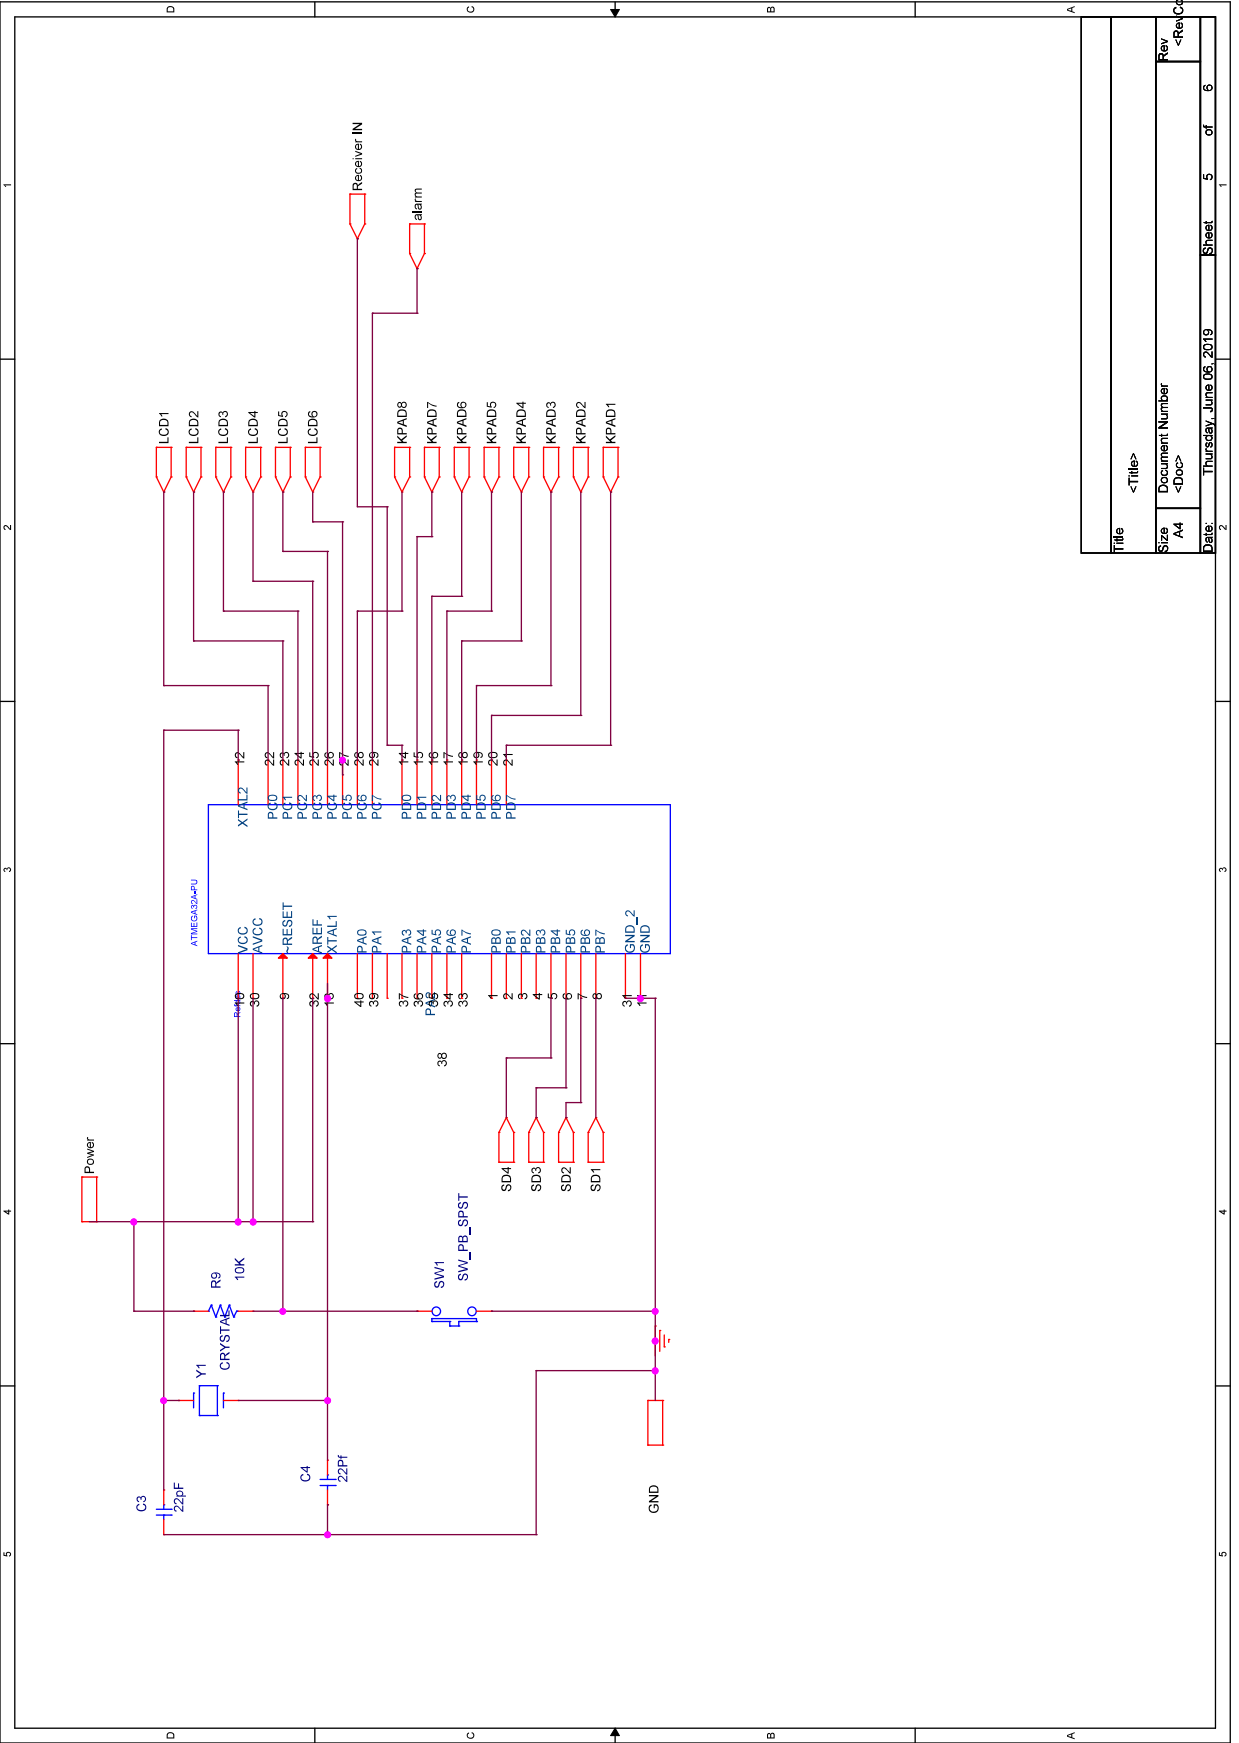
[picture p308: page 1]
