Kalana304/CEM_Design_Files/Reports/Circuit Information/WIP/DisCct6.pdf

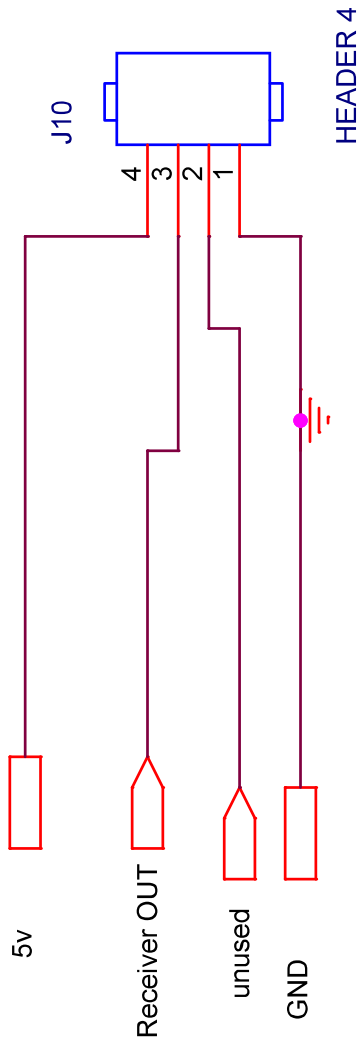
[picture p309: page 1]
