Kalana304/CEM_Design_Files/Reports/Circuit Information/WIP/SenCct1.pdf

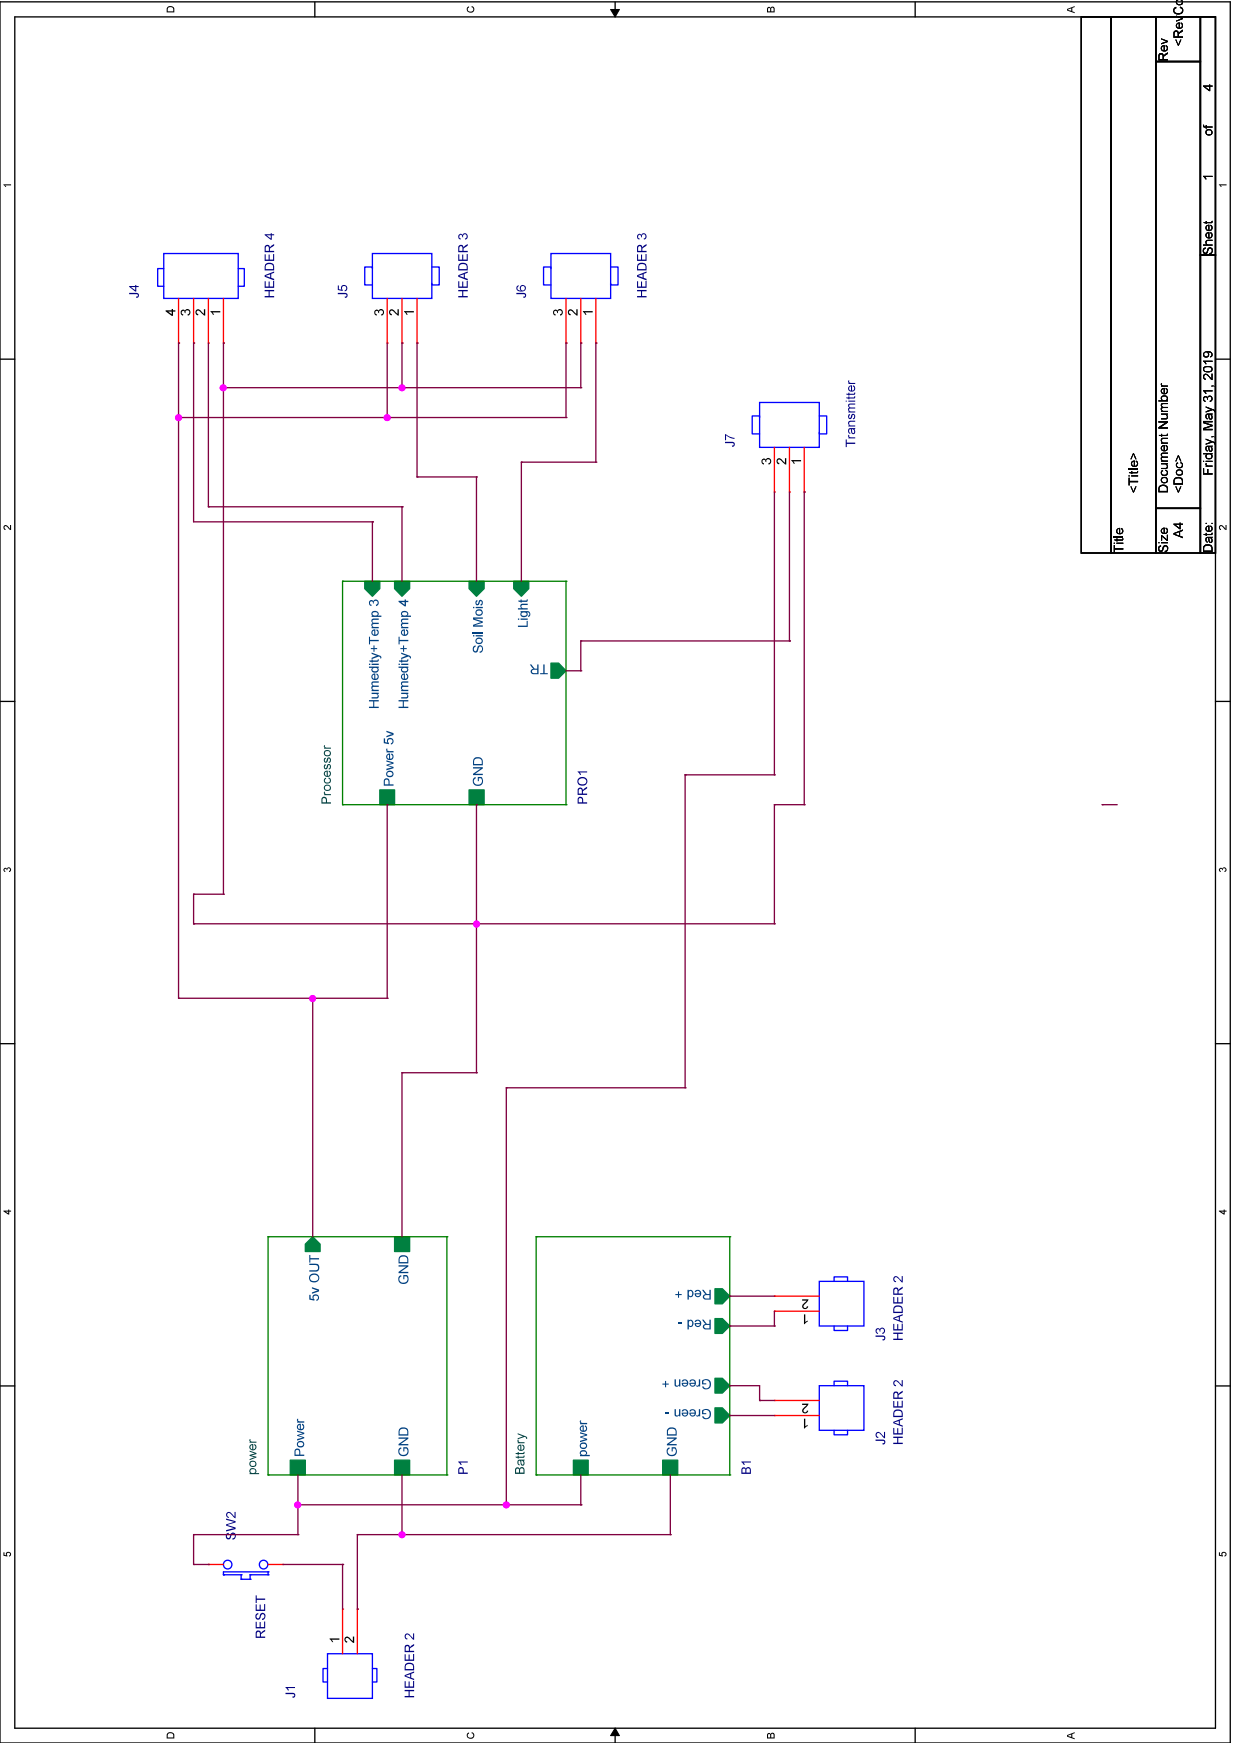
[picture p310: page 1]
