Kalana304/CEM_Design_Files/Reports/Circuit Information/WIP/SenCct2.pdf

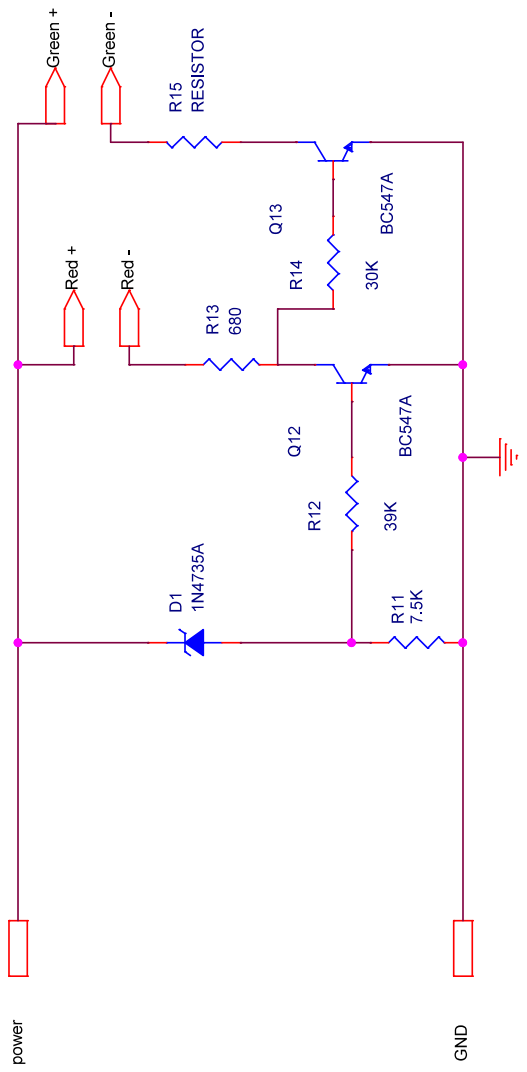
[picture p311: page 1]
