Kalana304/CEM_Design_Files/Reports/Circuit Information/WIP/SenCct3.pdf

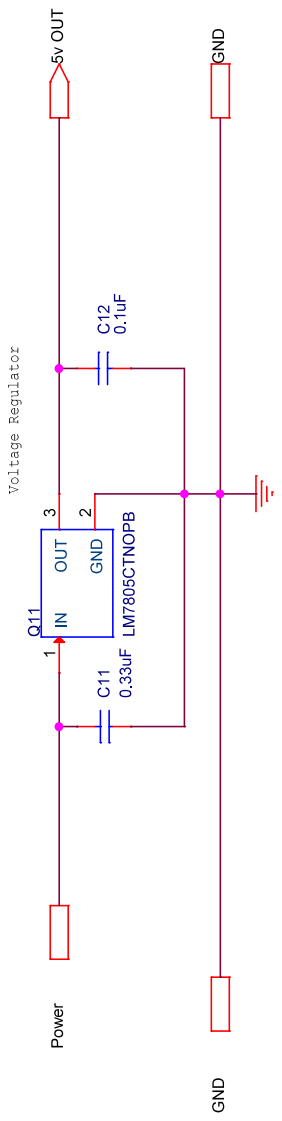
[picture p312: page 1]
