Kalana304/CEM_Design_Files/Reports/Circuit Information/WIP/SenCct4.pdf

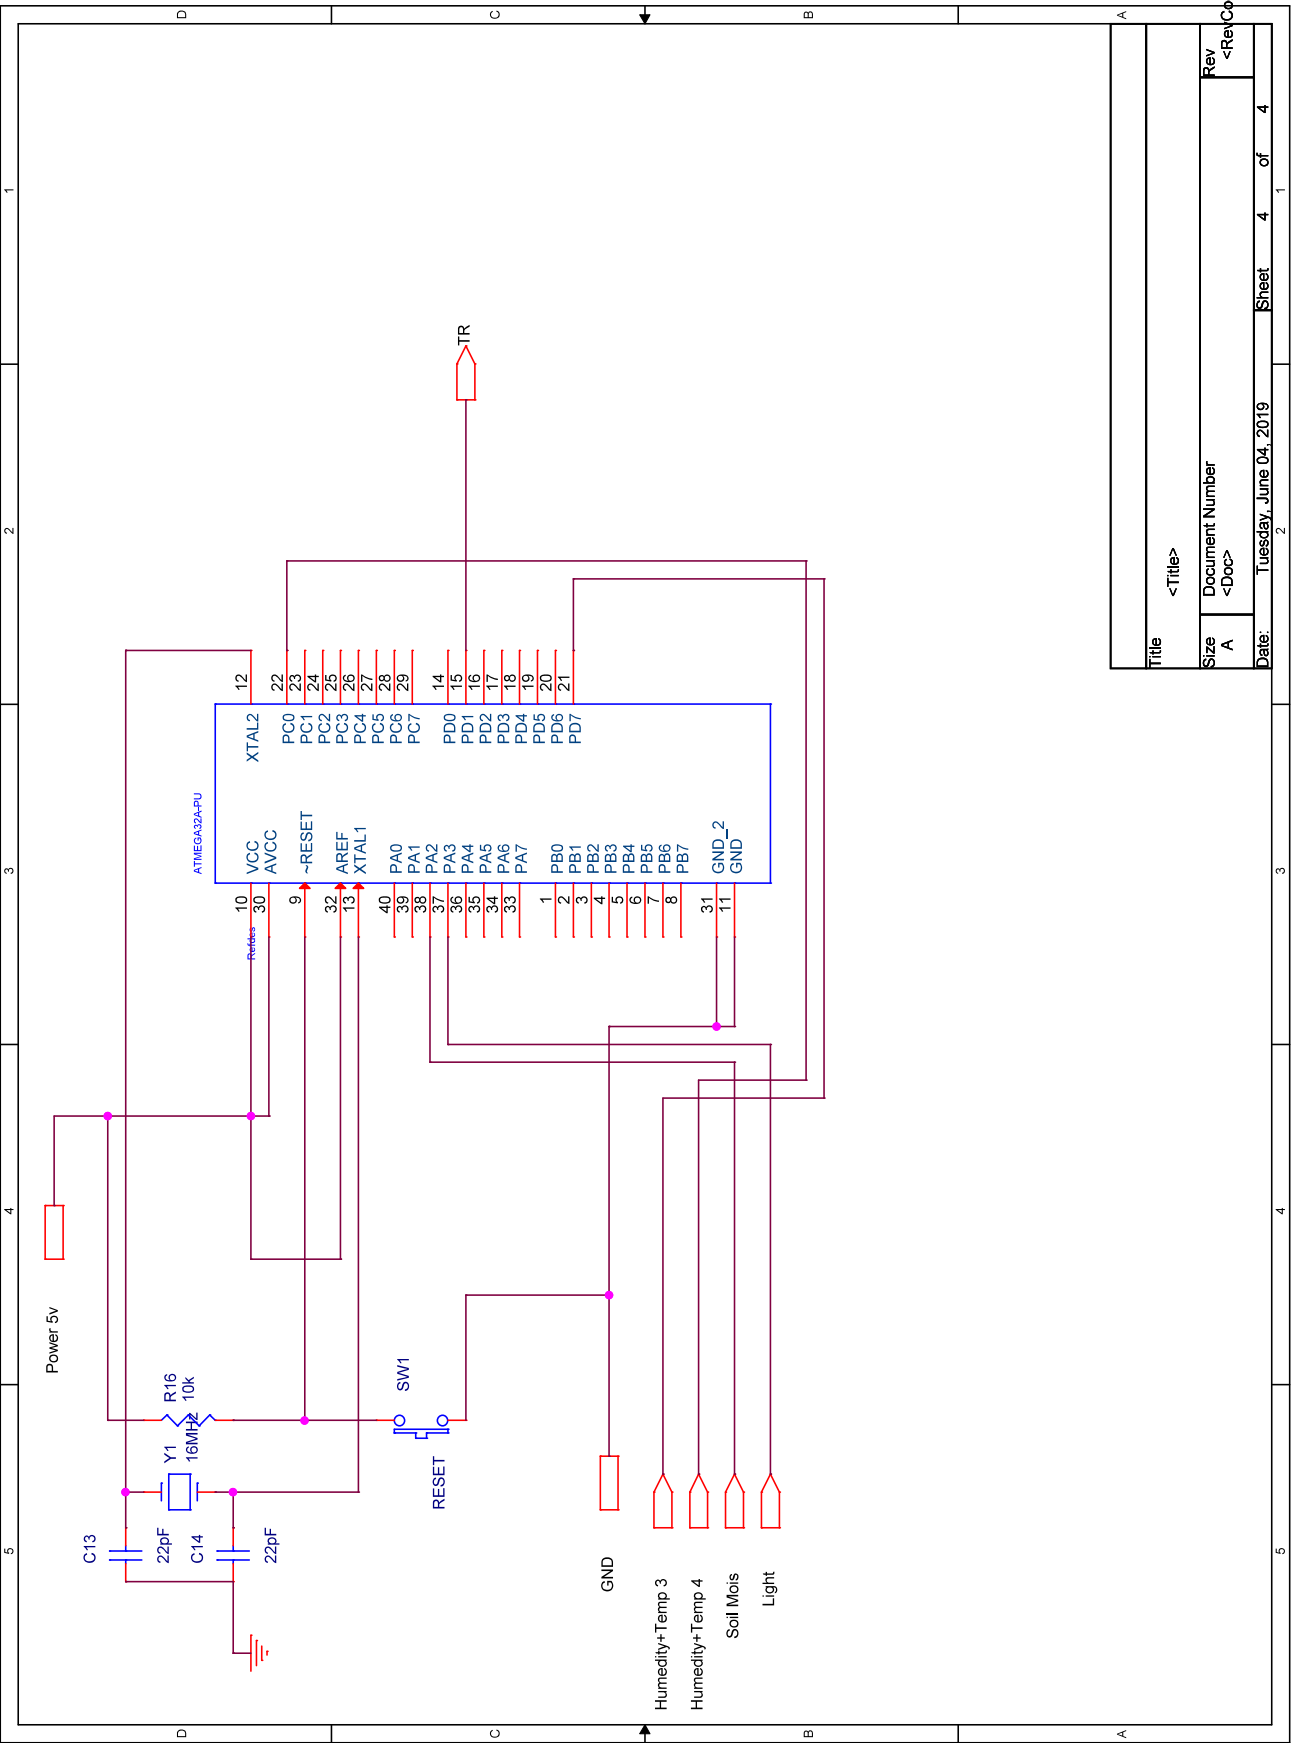
[picture p313: page 1]
