Kalana304/CEM_Design_Files/ORCAD/PCB_Final/Try_2_Power_correct/all.pdf

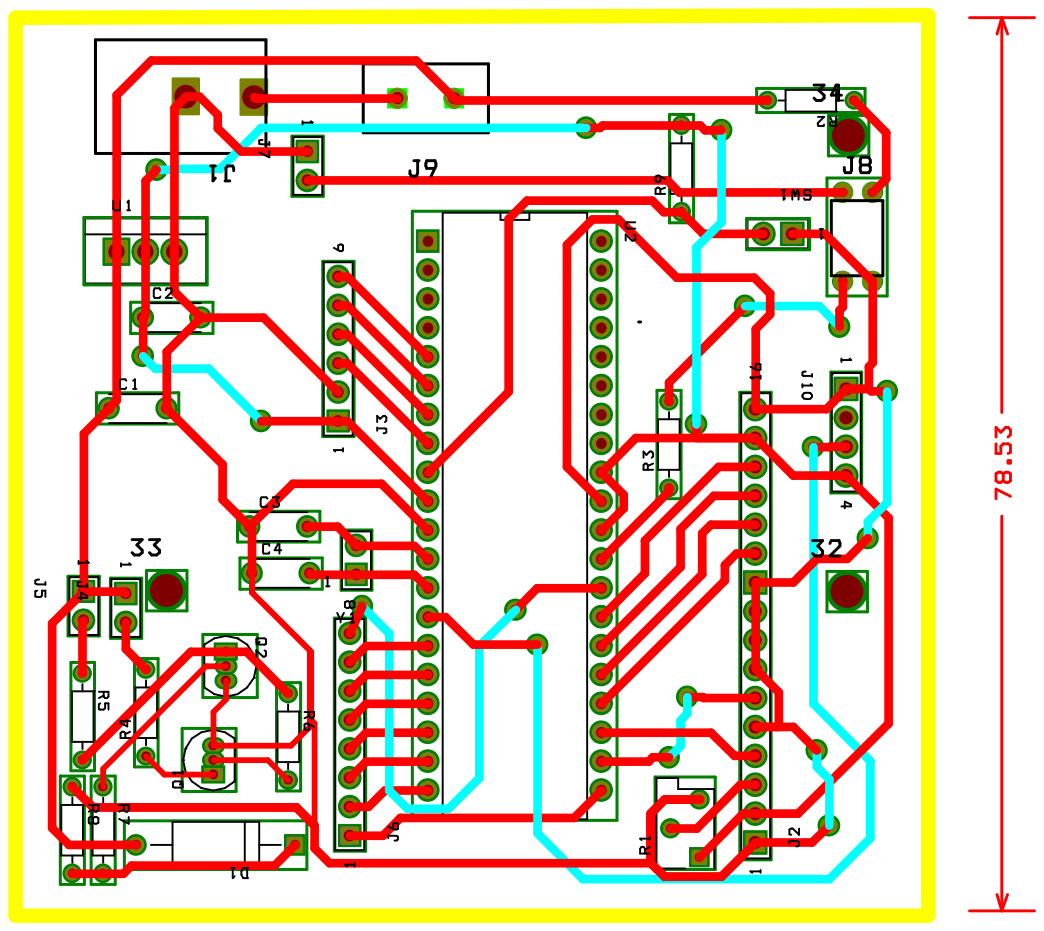
[picture p314: page 1]
