Kalana304/CEM_Design_Files/ORCAD/PCB_Final/Try_2_Power_correct/bottom_drill.pdf

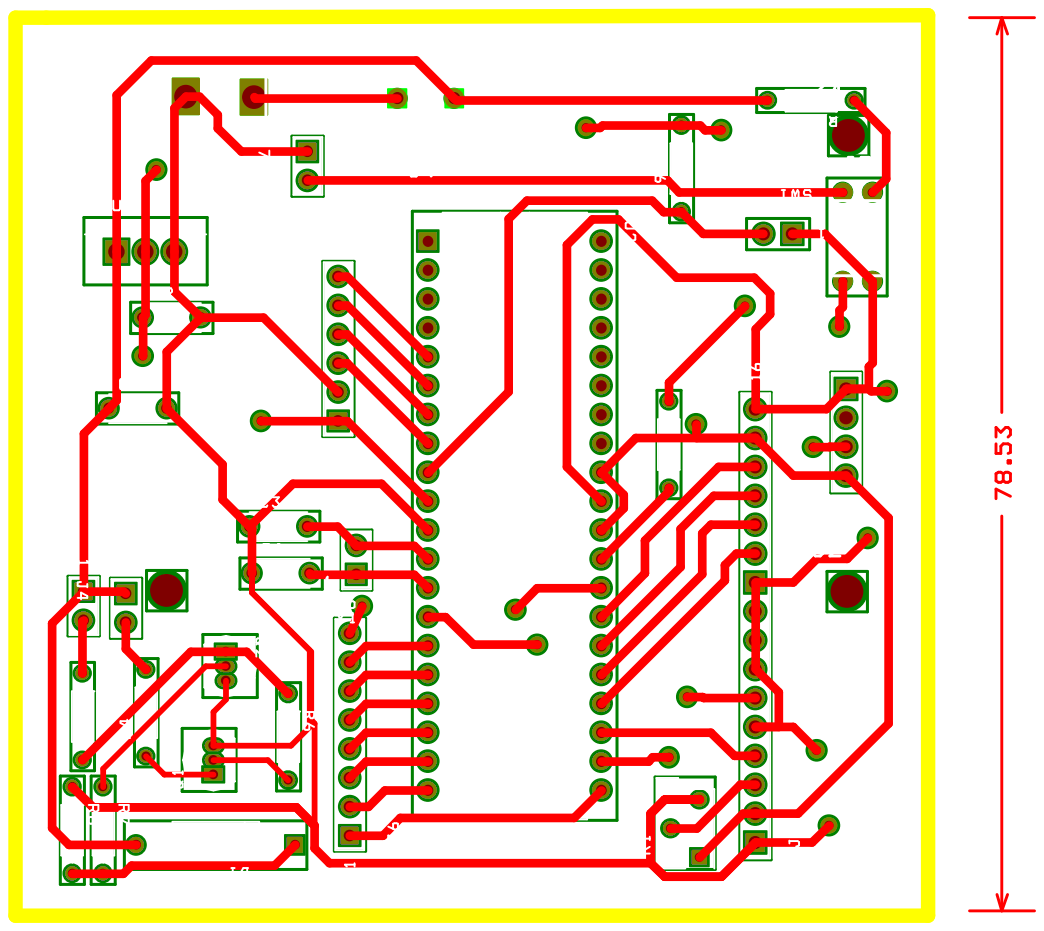
[picture p315: page 1]
