Kalana304/CEM_Design_Files/ORCAD/PCB_Final/Try_2_Power_correct/bottom_final.pdf

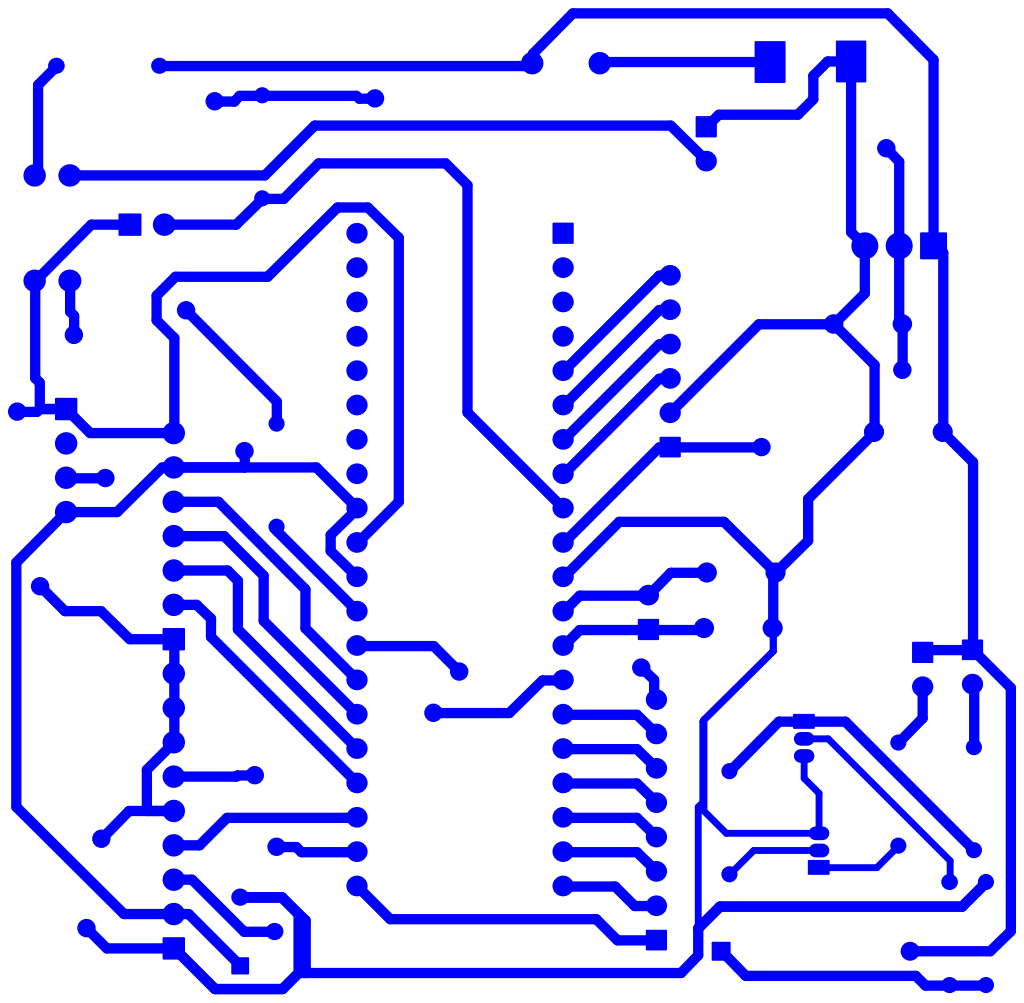
[picture p316: page 1]
