Kalana304/CEM_Design_Files/ORCAD/PCB_Final/Try_2_Power_correct/ss.pdf

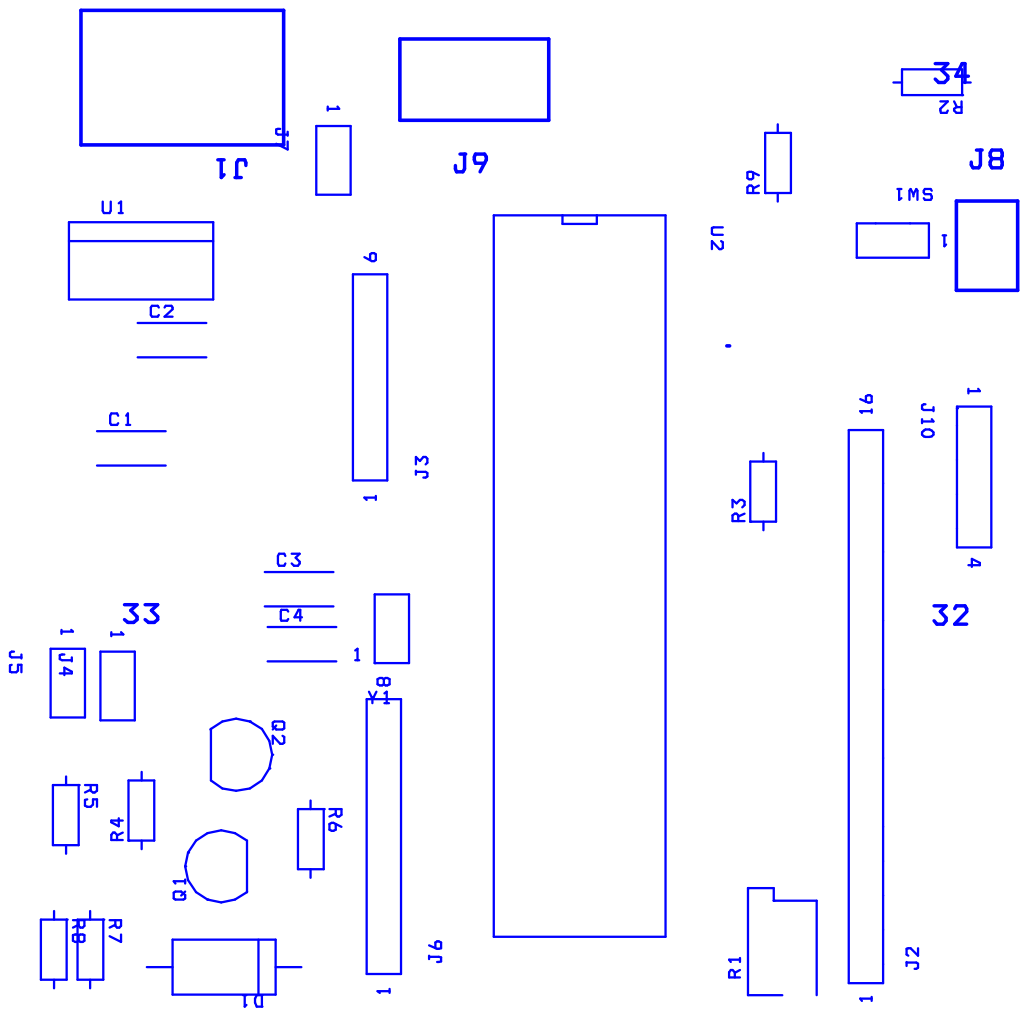
[picture p317: page 1]
