Kalana304/CEM_Design_Files/ORCAD/PCB_Final/Try_2_Power_correct/top_final.pdf

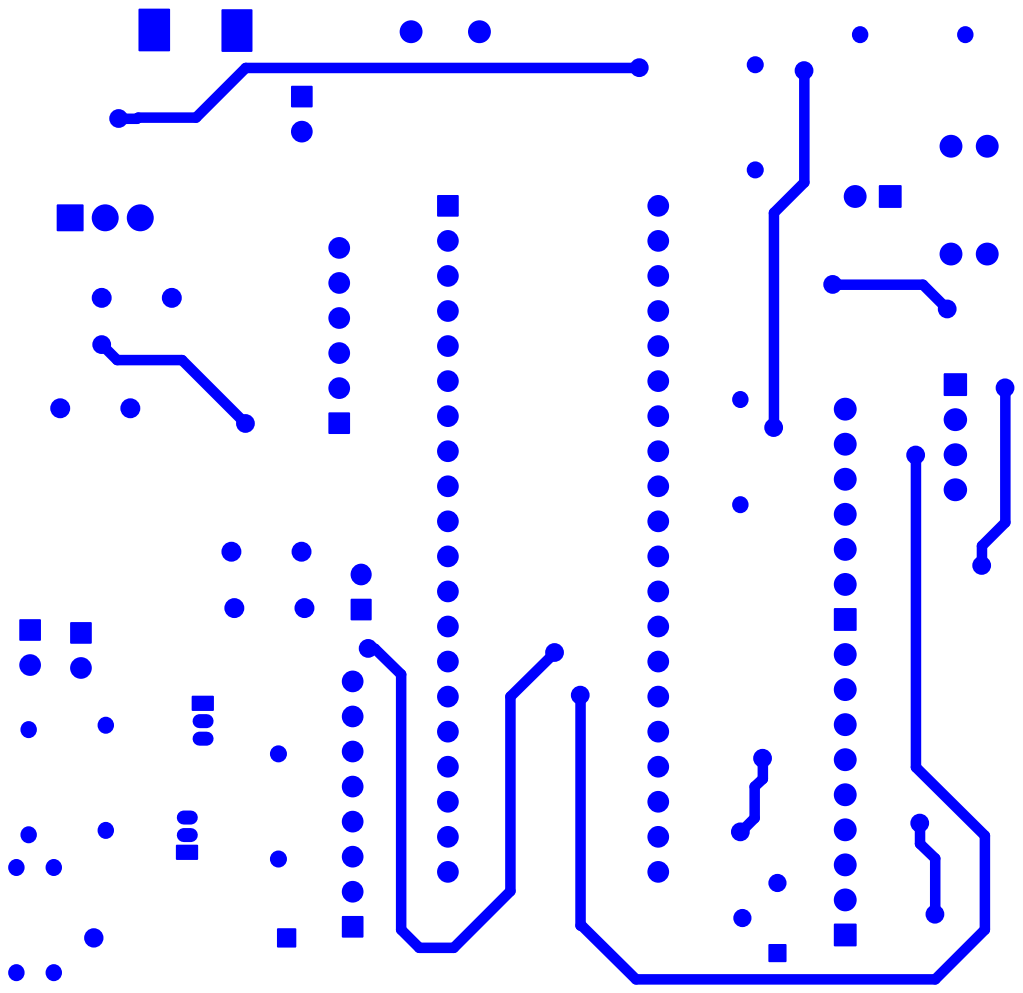
[picture p318: page 1]
