Kalana304/CEM_Design_Files/(list of files, drawings)

Other design files:
ORCAD/PCB_Final/SCHEMATIC 1.DSN
ORCAD/PCB_Final/Schematic 1.opj
ORCAD/PCB_Final/Try_2_Power_correct/SCHEMATIC 1.DSN
ORCAD/PCB_Final/Try_2_Power_correct/Schematic 1.opj
