Kalana304/CEM_Design_Files/(commit log)

2019-06-05 Second Commit
    [Assem3 - Battery Cover-2.STL, Assem3 - Bottom-1.STL, Assem3 - PCB^Assem3-1.STL, Assem3 - Top-1.STL, Assem3.SLDASM, Battery Cover.sldprt, Battery Lock.sldprt, Board.sldprt]
2019-06-17 Sensor unit SolidWorks appearances and Product Views
    [8pin_header.SLDPRT, AMS1117.SLDPRT, Adsong DHT21.SLDPRT, Altavoz.SLDPRT, Assem3.SLDASM, Battery Cover.sldprt, Battery Lock.sldprt, Board.sldprt]
2019-06-17 Service Manual
    [Assem4.SLDASM, Battery Cover.sldprt, Bottom.sldprt, LCD.sldprt, Md0090.SLDPRT, No 8 Pan Head Screw.SLDPRT, Part2.sldprt, Part3.sldprt]
2019-06-19 Collected Documents
    [Assem3 - Battery Cover-2.STL, Assem3 - Bottom-1.STL, Assem3 - PCB^Assem3-1.STL, Assem3 - Top-1.STL, Assem3.SLDASM, Battery Cover.sldprt, Battery Lock.sldprt, Board.sldprt]
2019-06-20 Started work on the FINAL report
    [Document List.xlsx]
2019-06-20 Design Document upto Detail design of Sensor
    [Document List.xlsx]
2019-06-21 Test Info
    [TestPoints.xlsx]
2019-06-21 Promotion Doc done
    [Bill of materials Display unit.xlsx]
